orku/graduation_work/pics/research/list.jpg

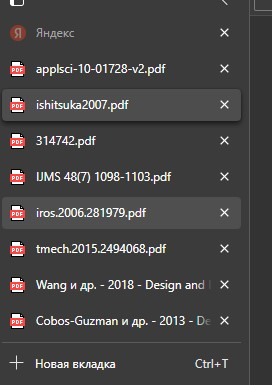
pics/research/list.jpg
