orku/graduation_work/pics/PID_tunes/Снимок экрана 2021-05-26 141231.jpg

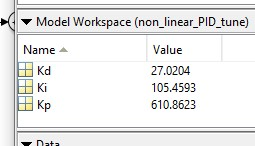
pics/PID_tunes/Снимок экрана 2021-05-26 141231.jpg
