orku/graduation_work/txt/schemes.pptx

М_в

1/(iμ)

ω_(ред)

U

−

1/(Ls+r)

i

K_M

−

−

М_(дв)

1/((J_п +J_р )s)

ω_(дв)

1/i

1/s

α

K_u

30/π

1/(iμ)

k_(гд)

## Slide 2

(K_M)/(Ls+r)

−

1/((J_п +J_р )s)

1/i

1/s

1/(iμ)

k_(гд)

k_л

1/i

(K_M)/(Ls+r)

K_u

30/π

М_(дв)

ω_(дв)

α

## Slide 3

М_в

ω_(ред)

U

−

1/(Ls+r)

i

K_M

−

М_(дв)

1/((J_п +J_р )s)

ω_(дв)

1/i

1/s

α

K_u

−

1/(iμ)

k_(гд)

k_л

## Slide 4

М_в

1/(iμ)

ω_(ред)

U

−

1/(Ls+r)

i

K_M

−

−

М_(дв)

ε/((J_п +J_р )s)

ω_(дв)

1/i

1/s

α

K_u

30/π

1/(iμ)

k_(гд)

k_л

## Slide 5

K_i

1/s

−

K_p

Объект
регулирования

K_d s

W_д

## Slide 6

(K_i)/s

−

K_p

Объект
регулирования

K_d s

W_д

## Slide 7

М_в

1/(iμ)

ω_(ред)

U

−

1/(Ls+r)

i

K_M

−

−

М_(дв)

ε/((J_п +J_р )s)

ω_(дв)

1/i

1/s

α

K_u

30/π

1/(iμ)

k_(гд)

## Slide 8

30/π

1/(iμ)

k_(гд)

k_л

(K_i)/s

K_p

U

1/(Ls+r)

i

K_M

−

М_(дв)

1/((J_п +J_р )s)

ω_(дв)

1/i

ω_(ред)

1/s

−

−

−

K_d s

K_u

α

## Slide 9

Линейная
часть

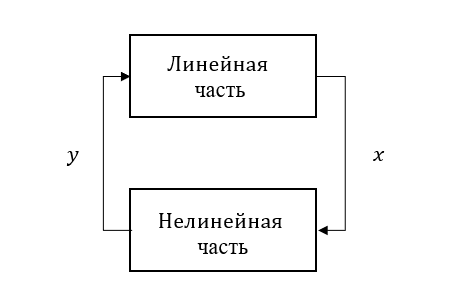
[picture p3: figure]

y

−

x

Нелинейная
часть

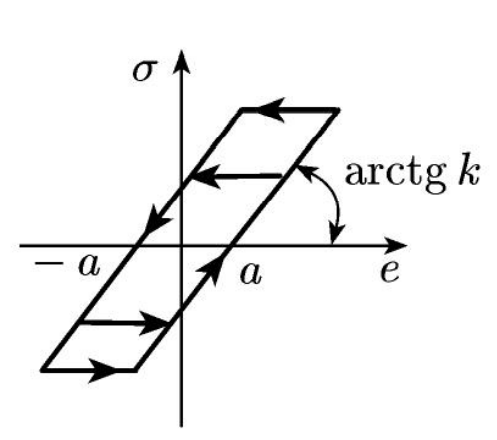
[picture p4: figure]
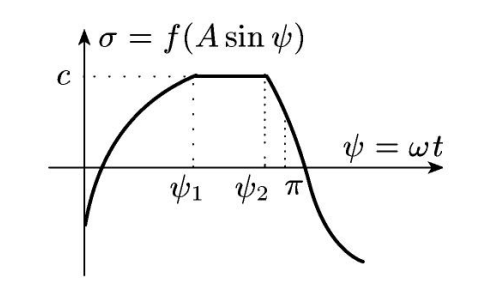
[picture p5: figure]

−

Линейная
часть

x

Нелинейная
часть

y

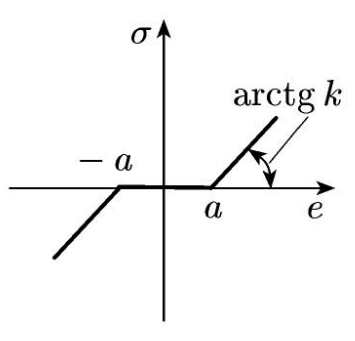
[picture p6: figure]

α

b

b

-b

b

α

## Slide 10

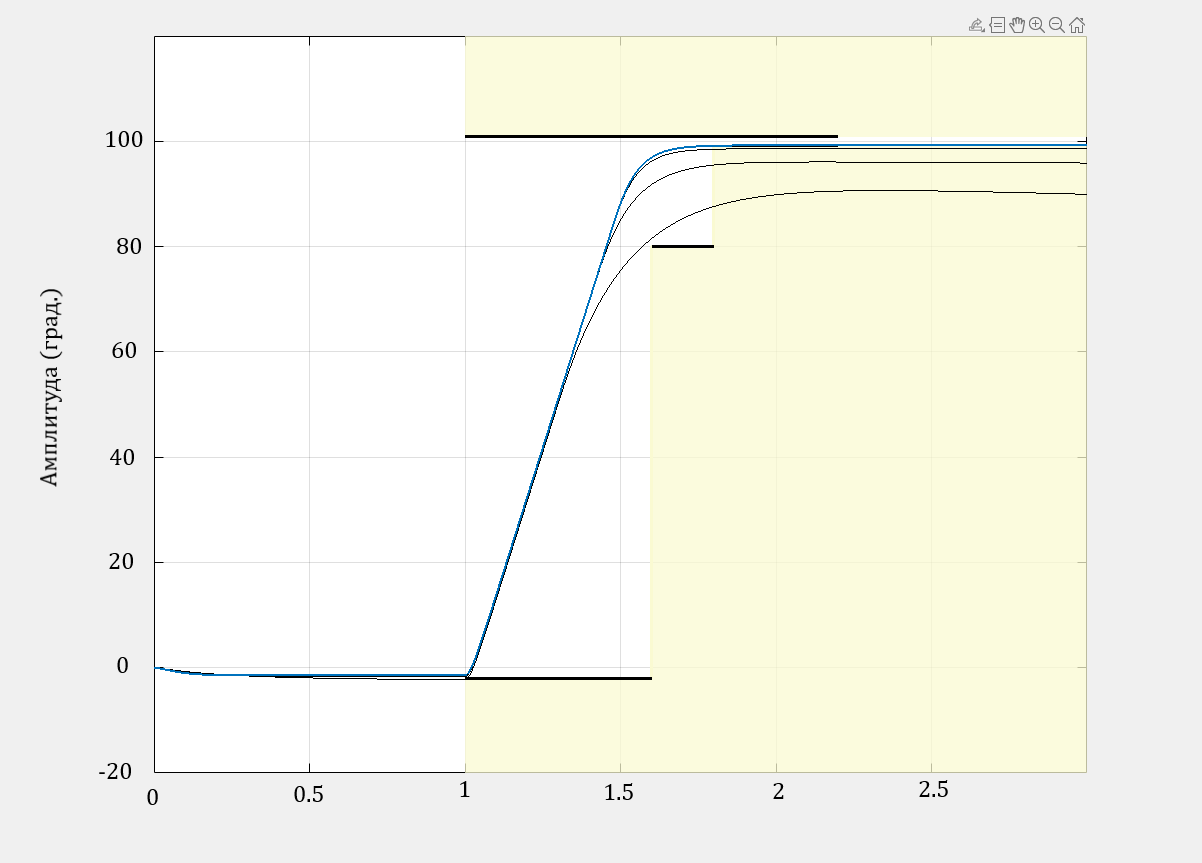
[picture p7: figure]

## Slide 11

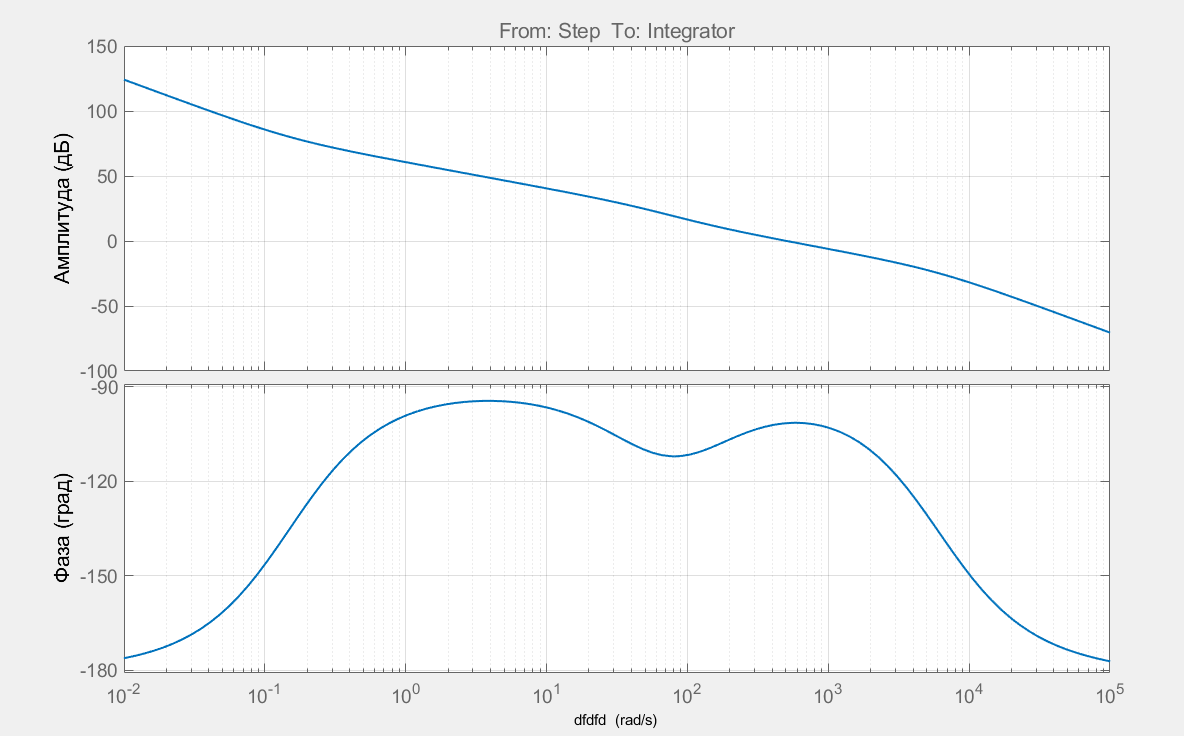
[picture p8: figure]

Частота (рад/с)

## Slide 12

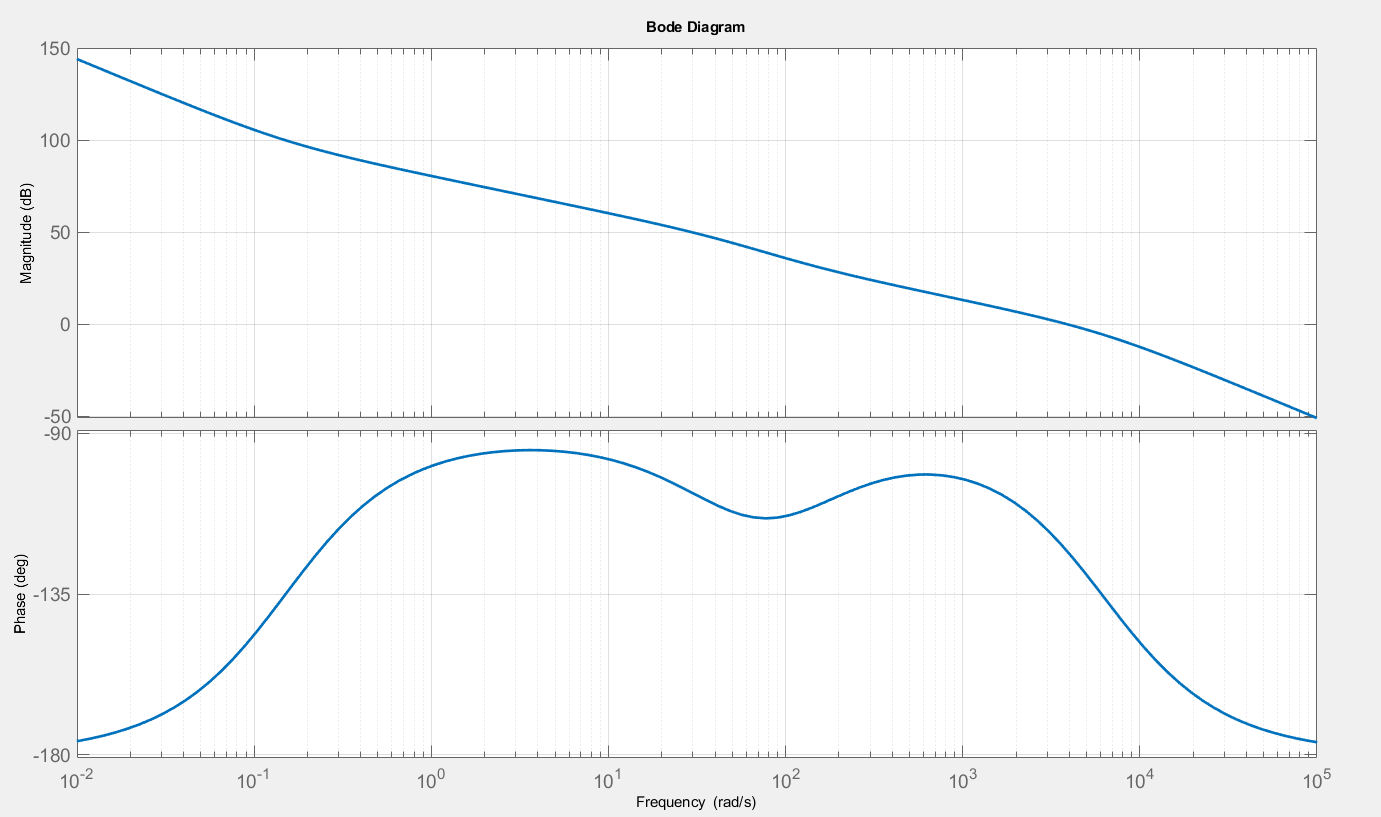
[picture p9: figure]

Амплитуда (дБ)

Фаза (град.)

Частота (рад/с)

## Slide 13

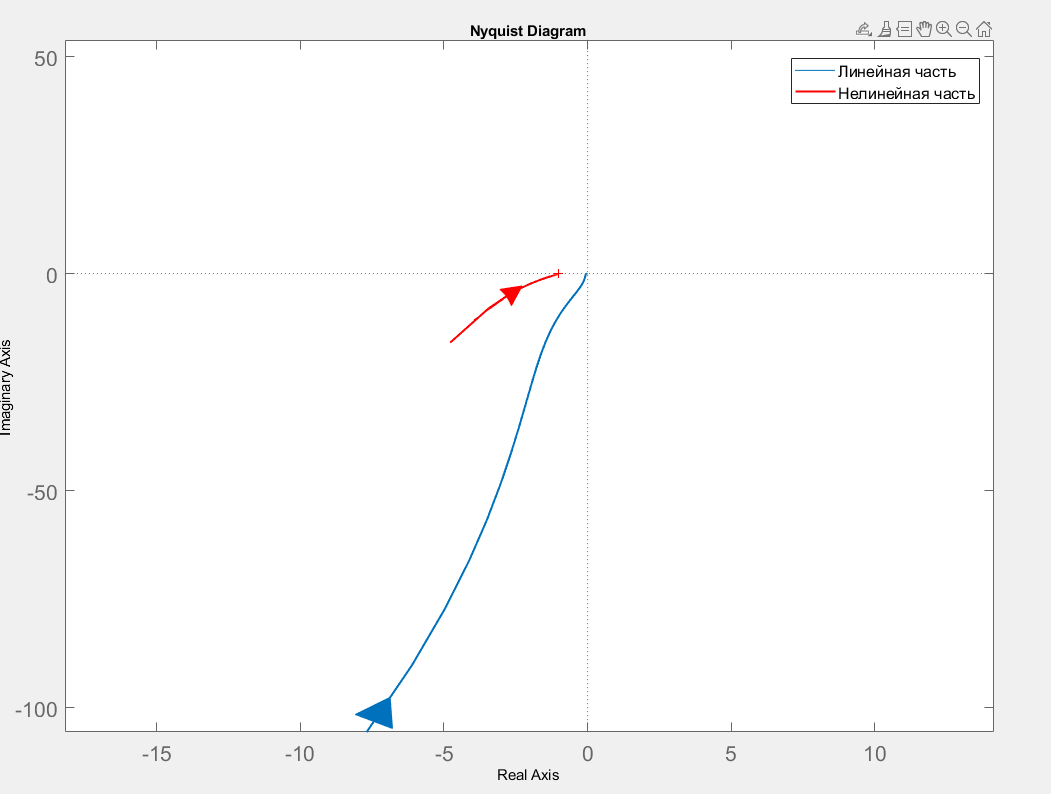
[picture p10: figure]

Мнимая часть

A = ∞

ω=∞

Действительная часть

## Slide 14

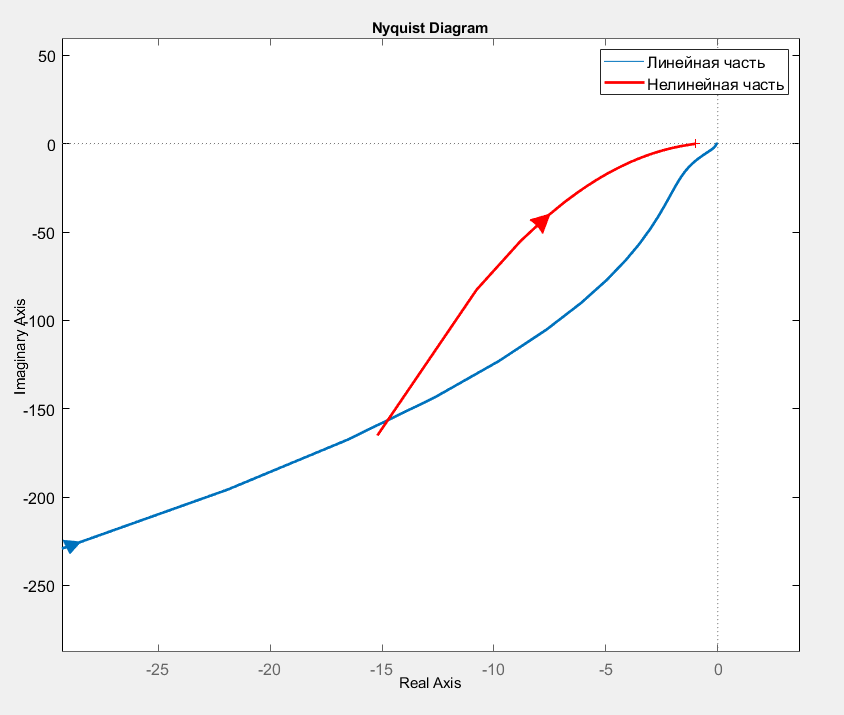
[picture p11: figure]

Мнимая часть

A = ∞

ω=∞

Действительная часть

## Slide 15

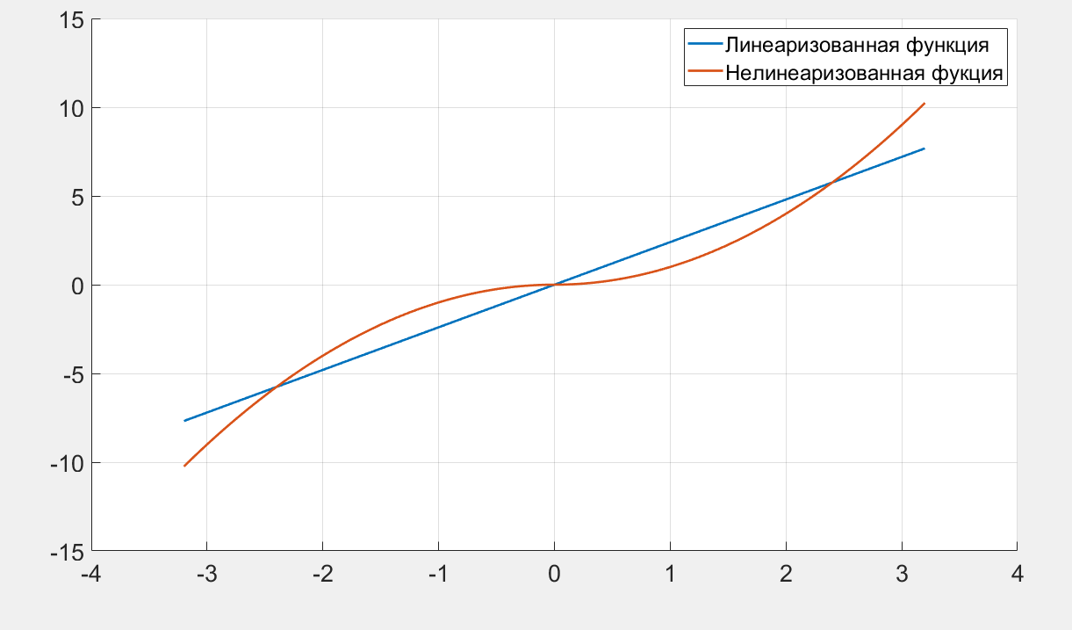
[picture p12: figure]

F(ω)

ω, рад/с

## Slide 16

20

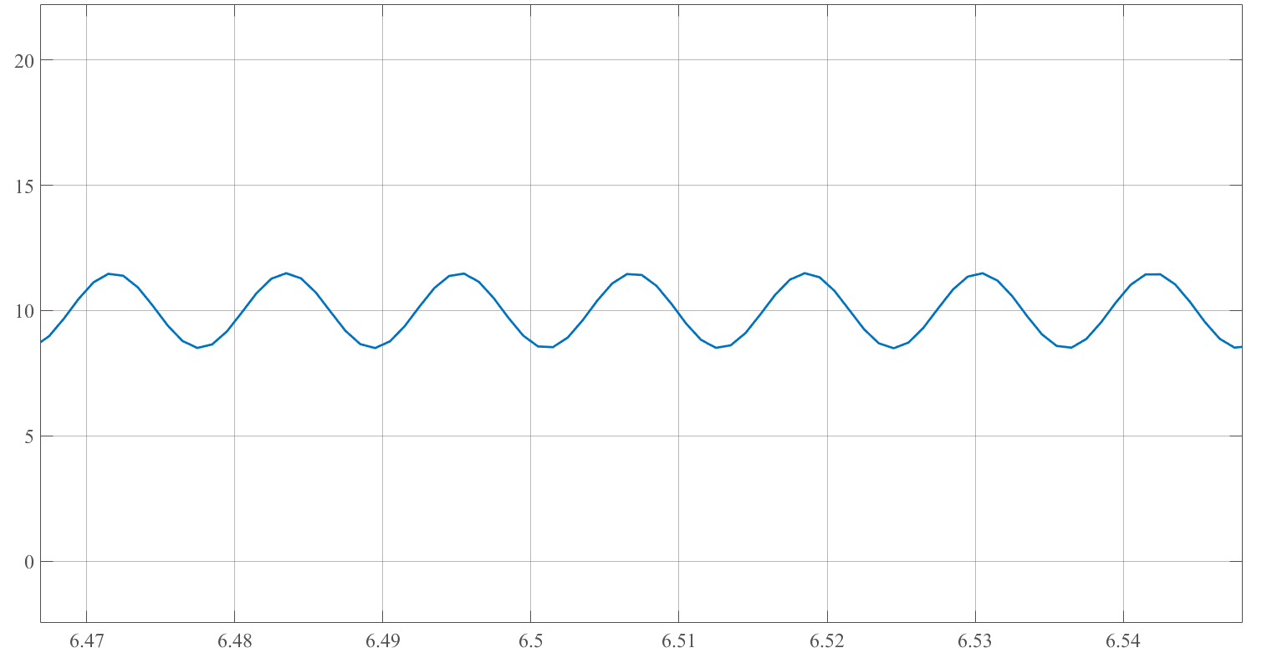
[picture p13: figure]

15

10

5

0

6.42

6.62

6.82

7.02

7.22

7.42

7.62

7.82

## Slide 17

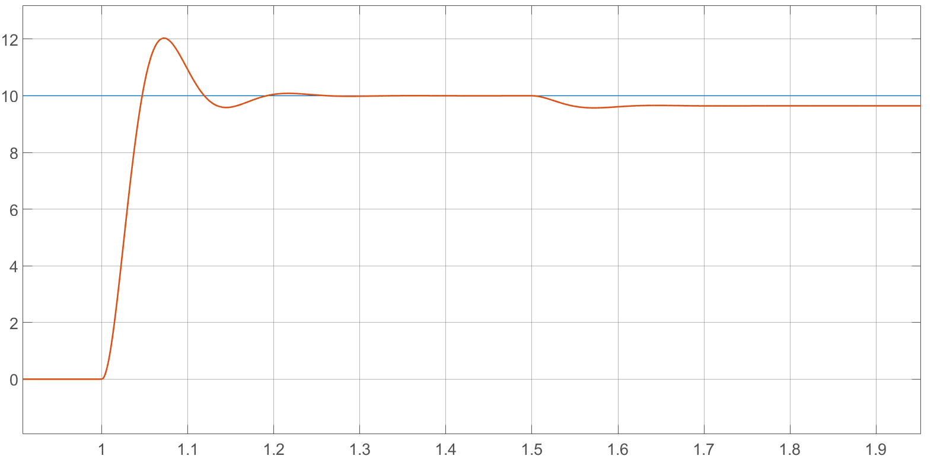
[picture p14: figure]
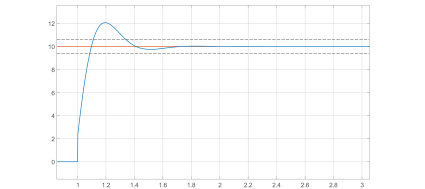
[picture p15: figure]
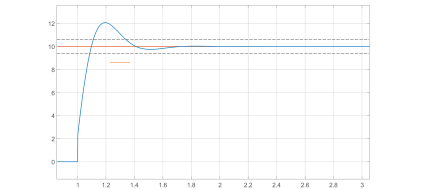
[picture p16: figure]

## Slide 18

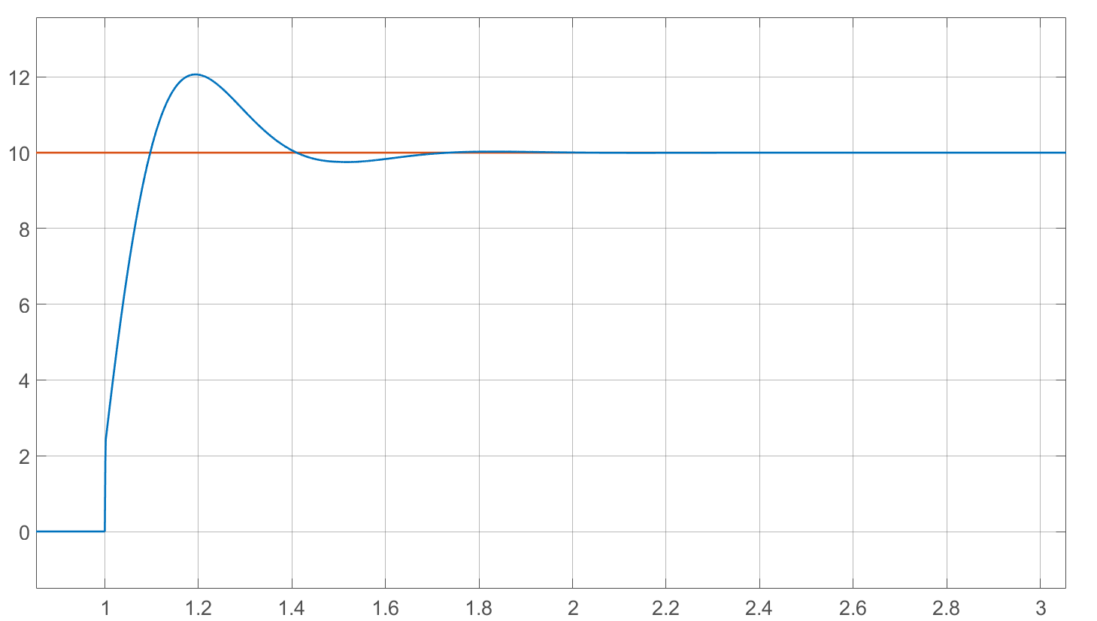
[picture p17: figure]

## Slide 19

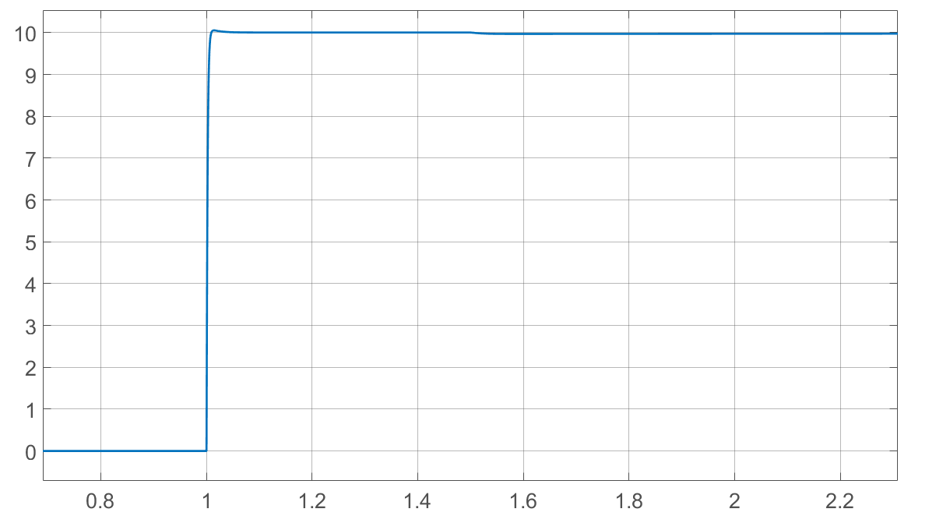
[picture p18: figure]

## Slide 20

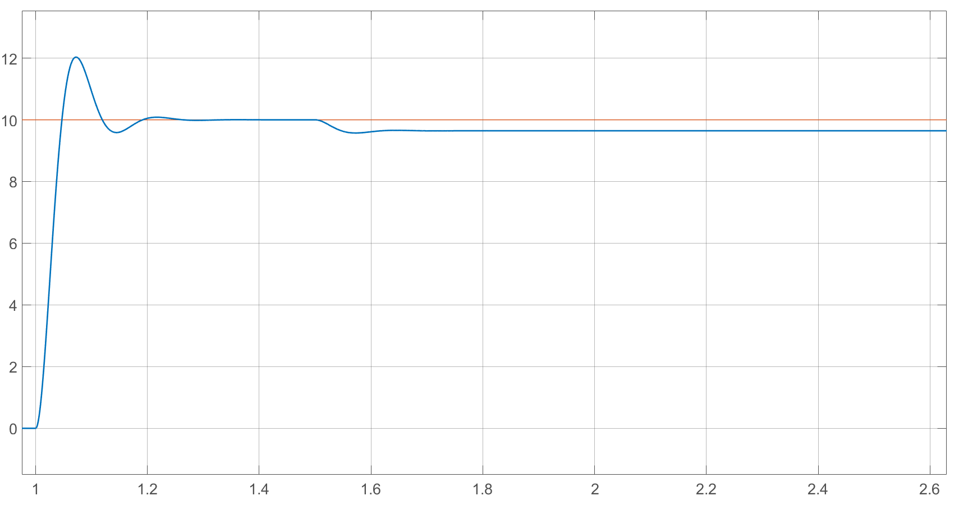
[picture p19: figure]

## Slide 21

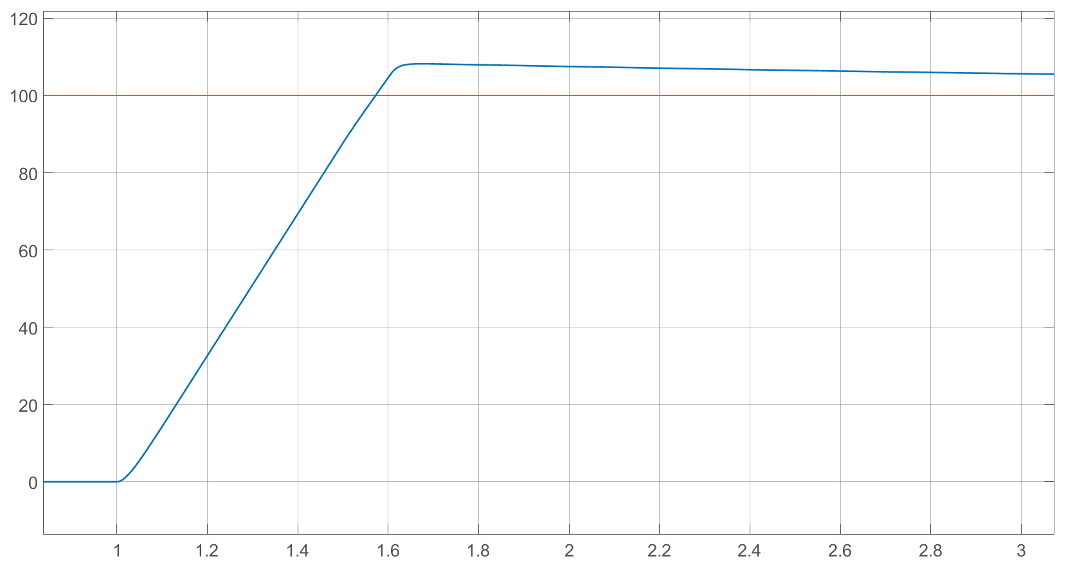
[picture p20: figure]

## Slide 22

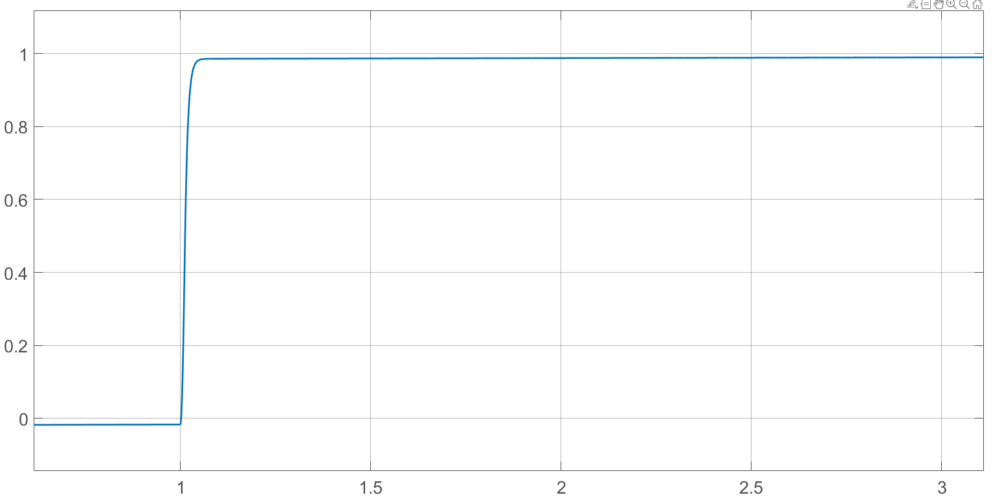
[picture p21: figure]

## Slide 23

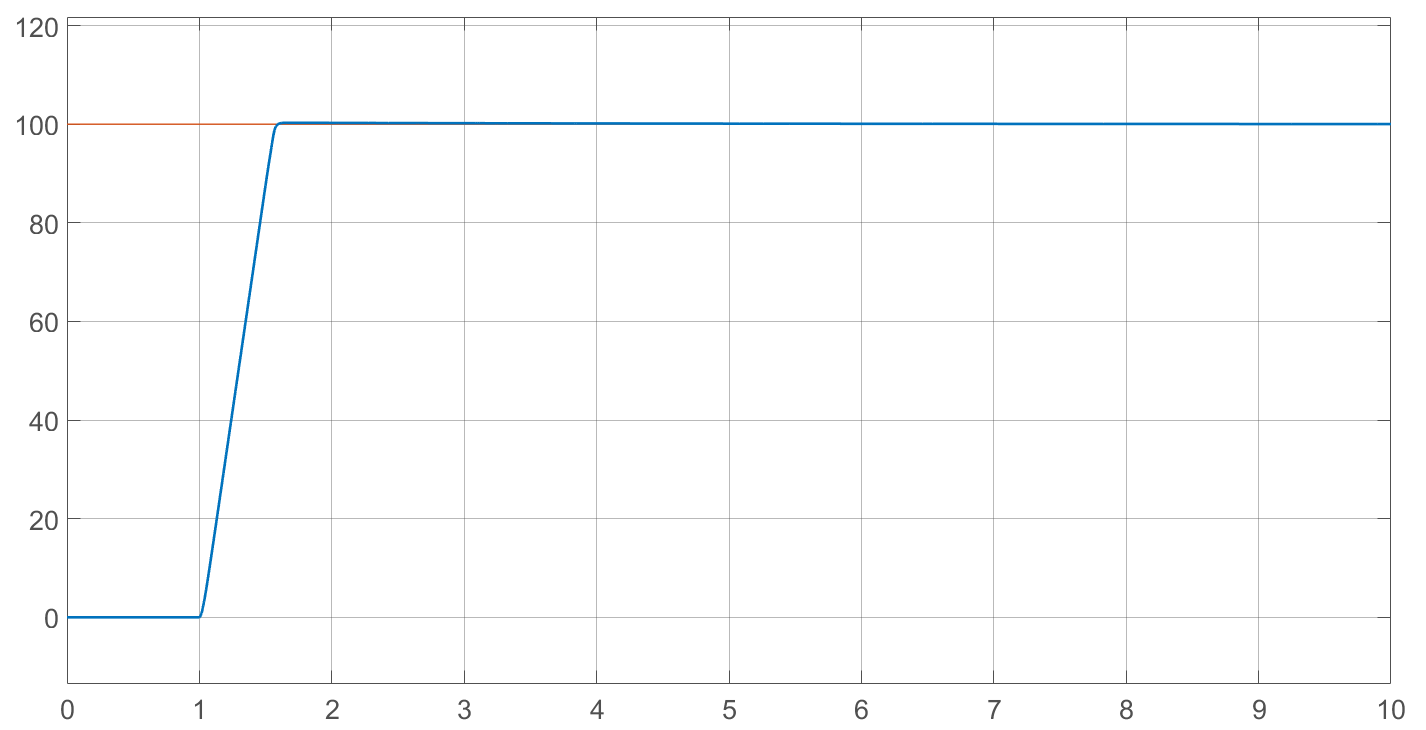
[picture p22: figure]

## Slide 24

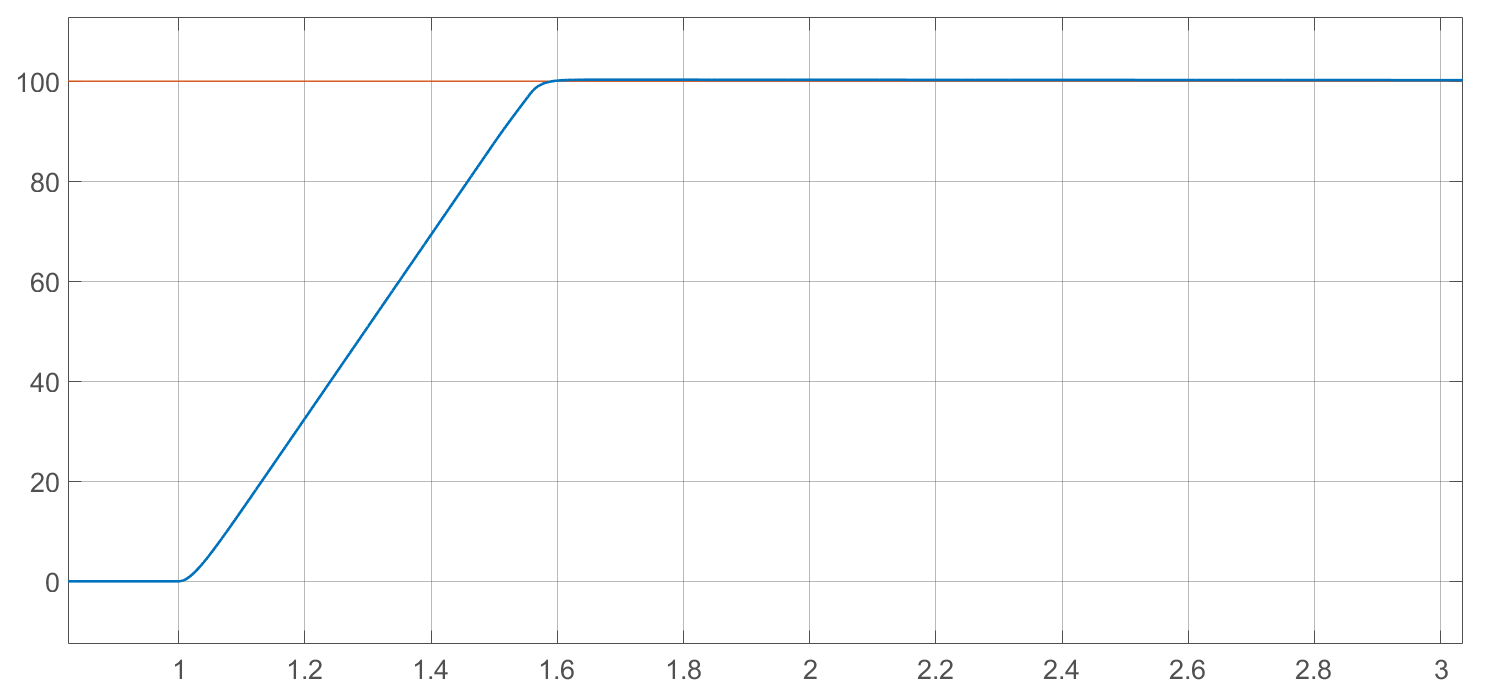
[picture p23: figure]

## Slide 25

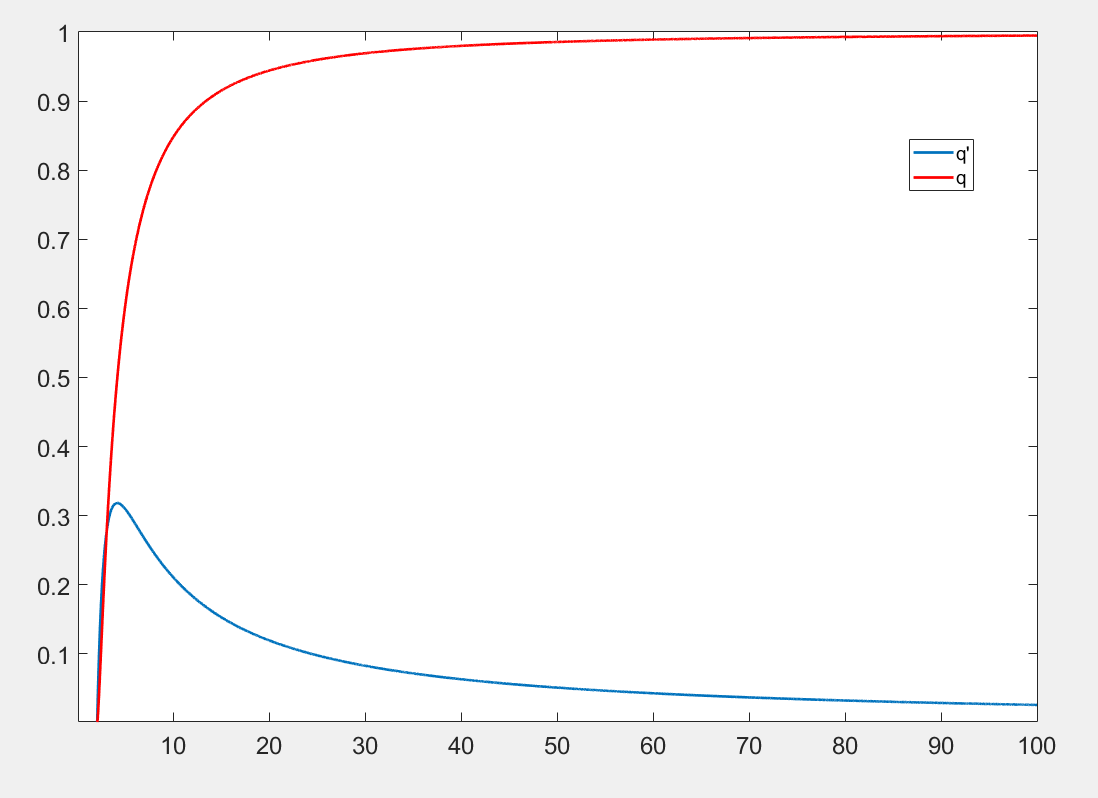
[picture p24: figure]

## Slide 26

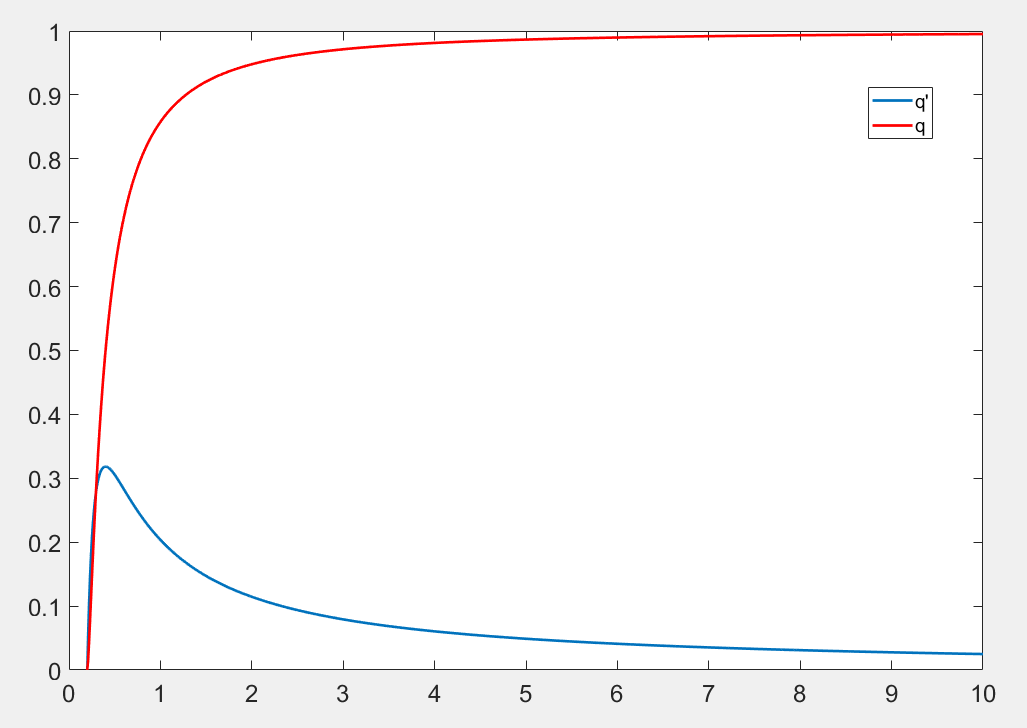
[picture p25: figure]

## Slide 27

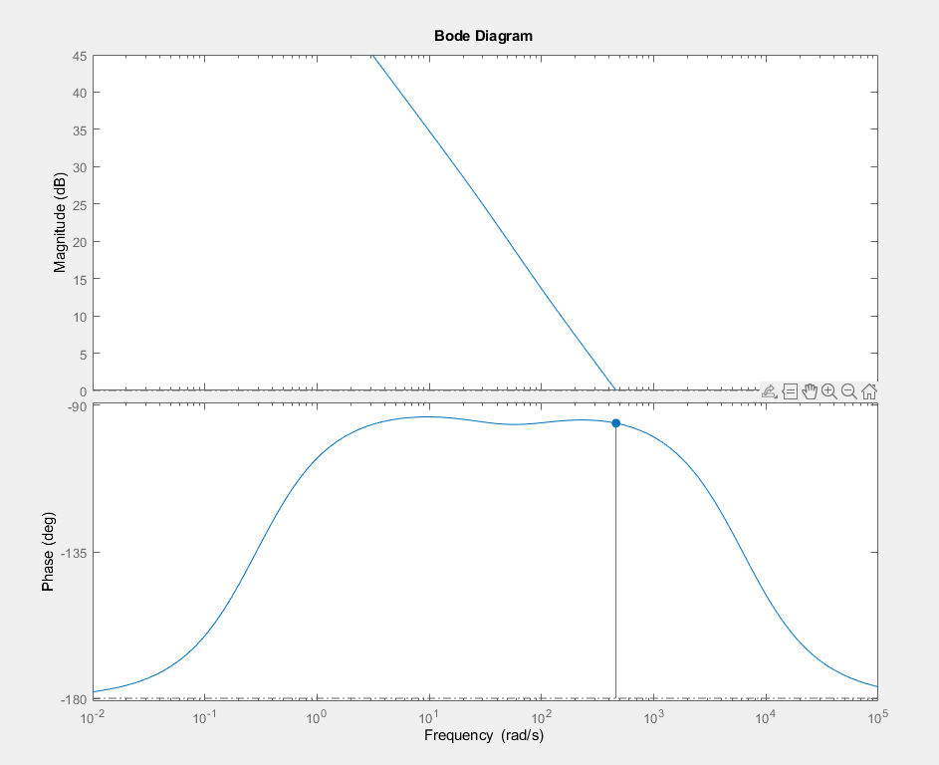
[picture p26: figure]
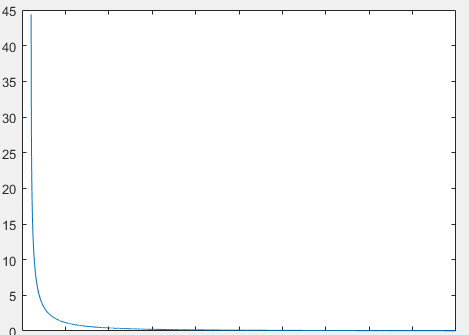
[picture p27: figure]
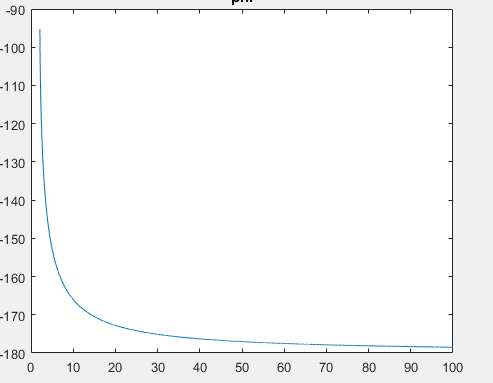
[picture p28: figure]

## Slide 28

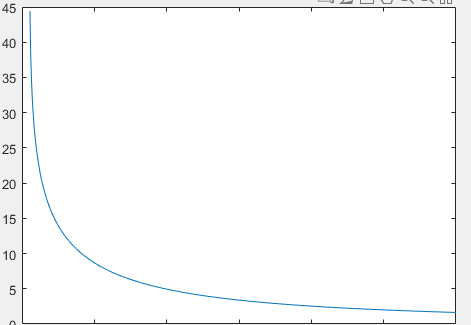
[picture p29: figure]
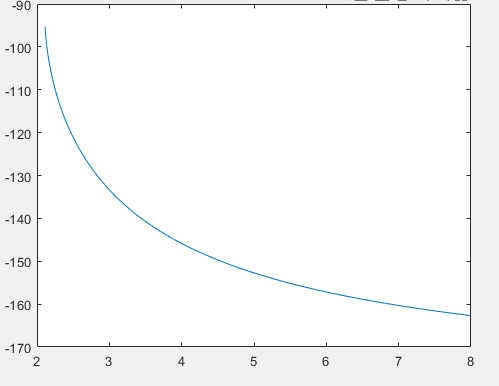
[picture p30: figure]

## Slide 29

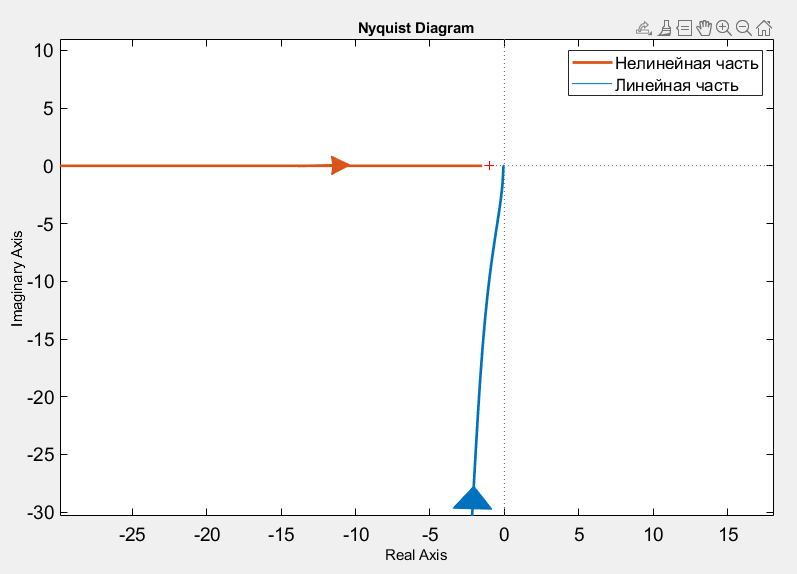
[picture p31: figure]

Мнимая часть

A = ∞

ω=∞

Действительная часть

## Slide 30

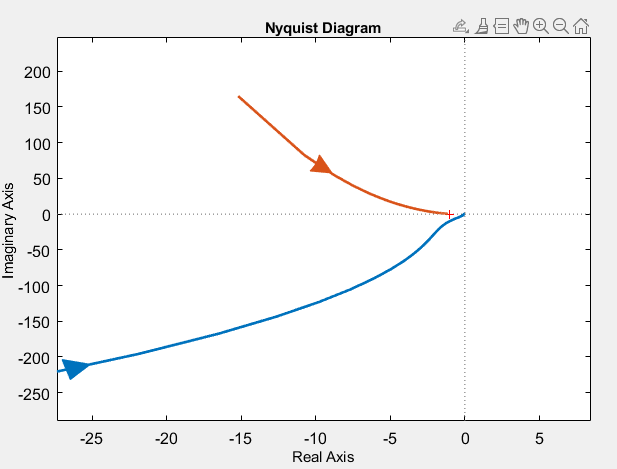
[picture p32: figure]

Действительная часть

Мнимая часть

A = ∞

ω=∞

## Slide 31

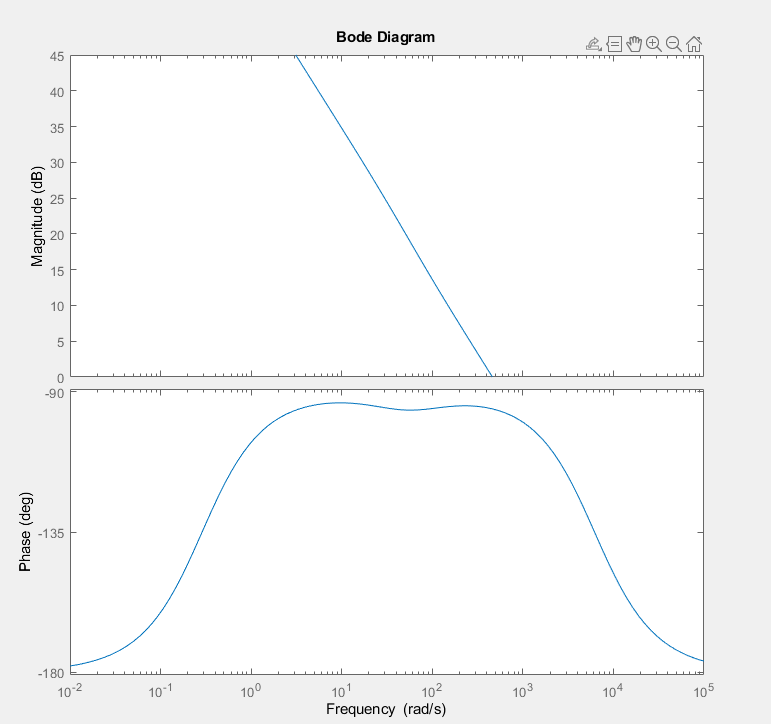
[picture p33: figure]
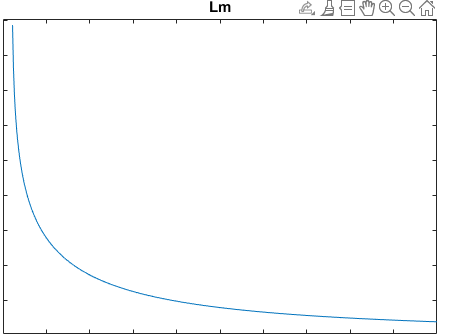
[picture p34: figure]
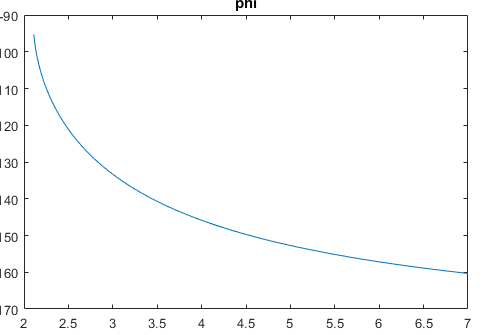
[picture p35: figure]

## Slide 32

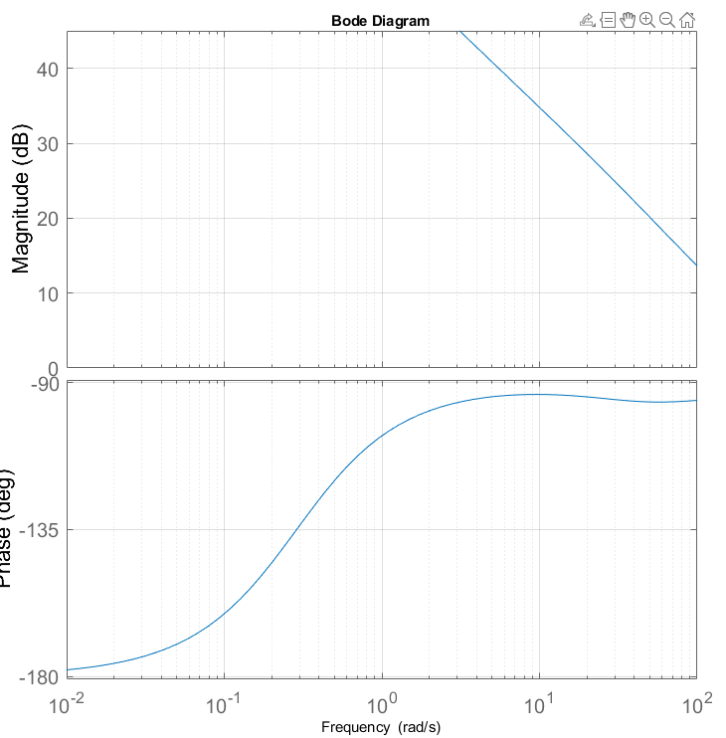
[picture p36: figure]
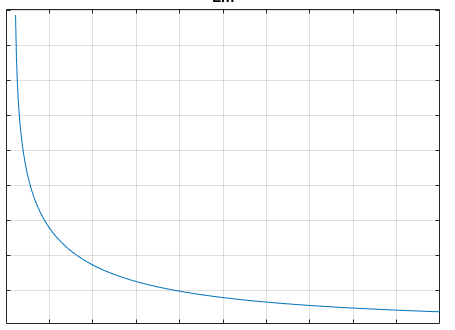
[picture p37: figure]
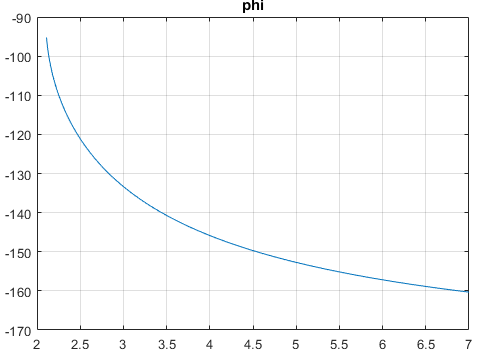
[picture p38: figure]

## Slide 33

4

3

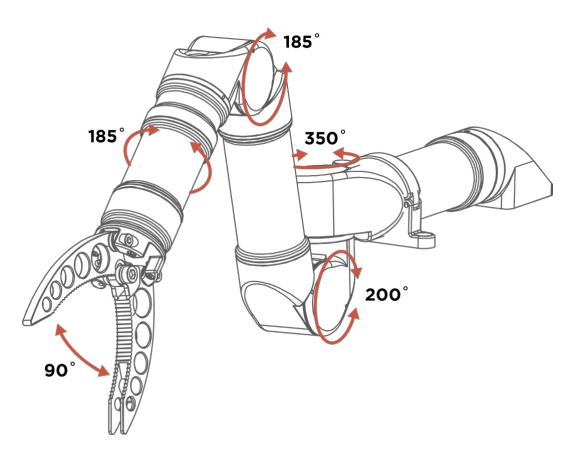
[picture p39: figure]

1

5

2

## Slide 34

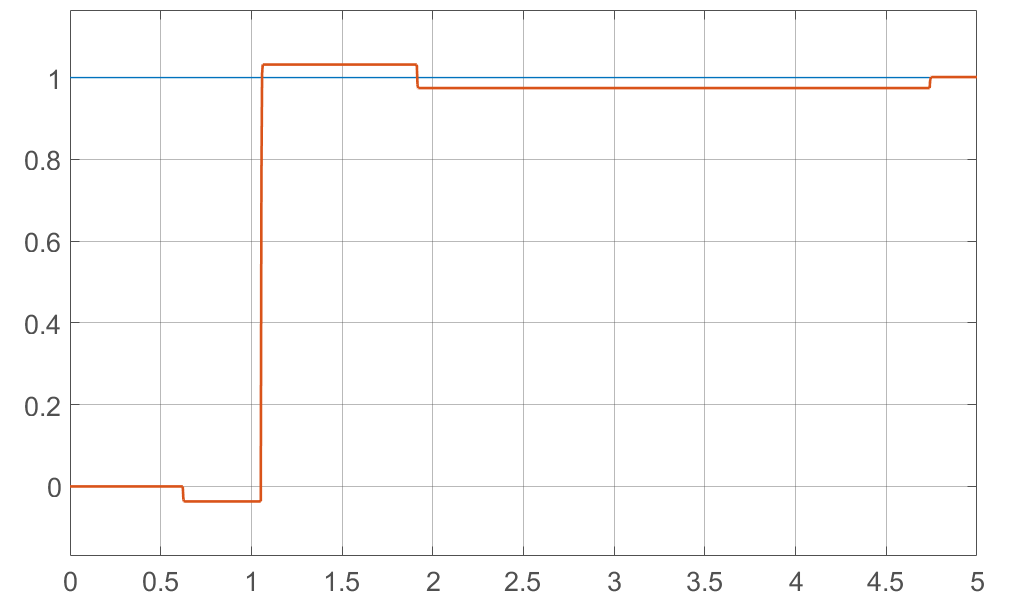
[picture p40: figure]

## Slide 35

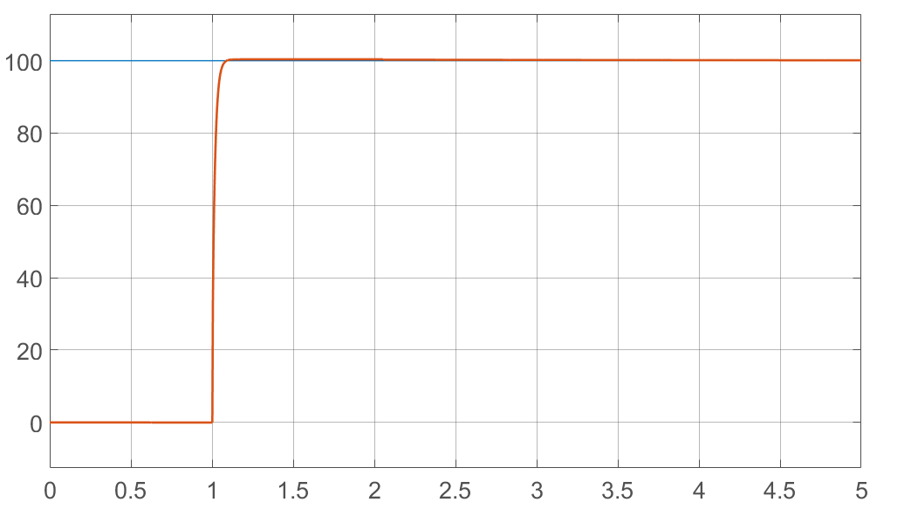
[picture p41: figure]

## Slide 36

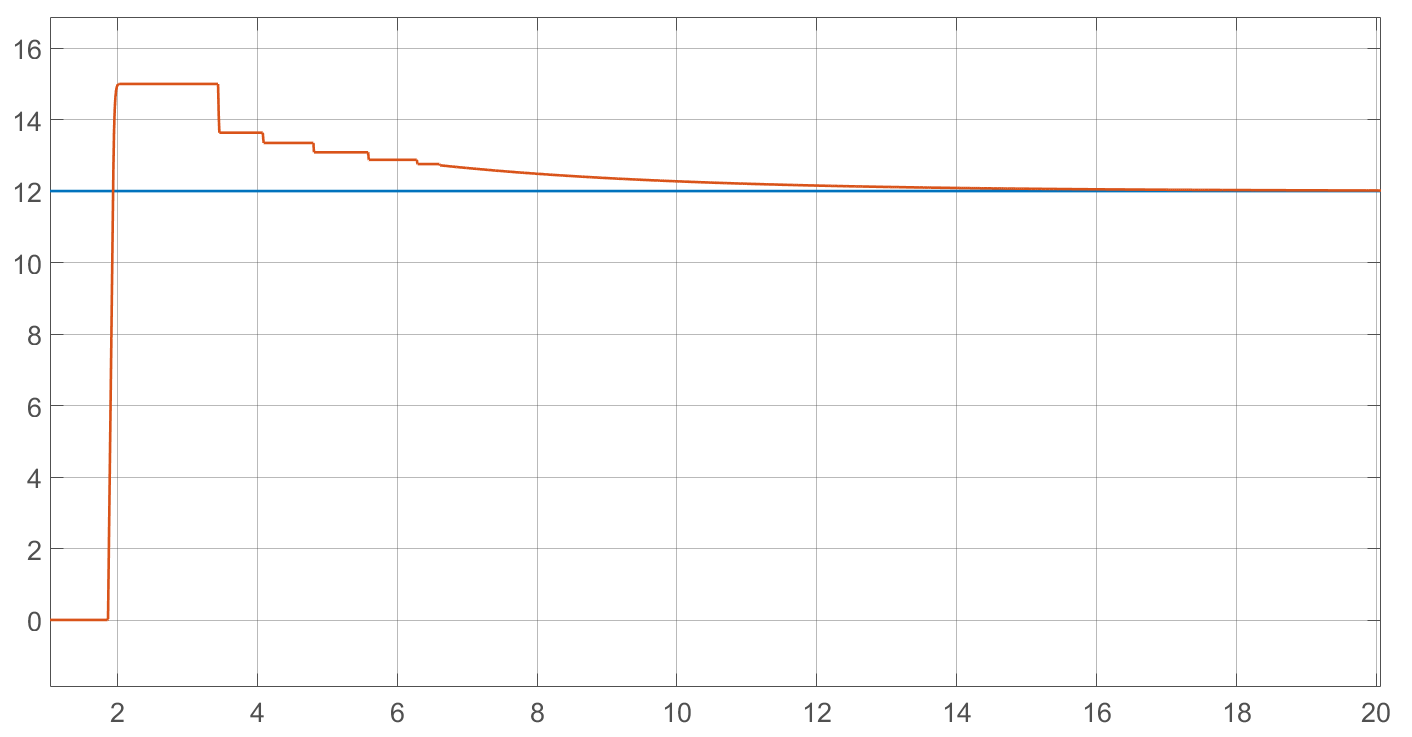
[picture p42: figure]

## Slide 37

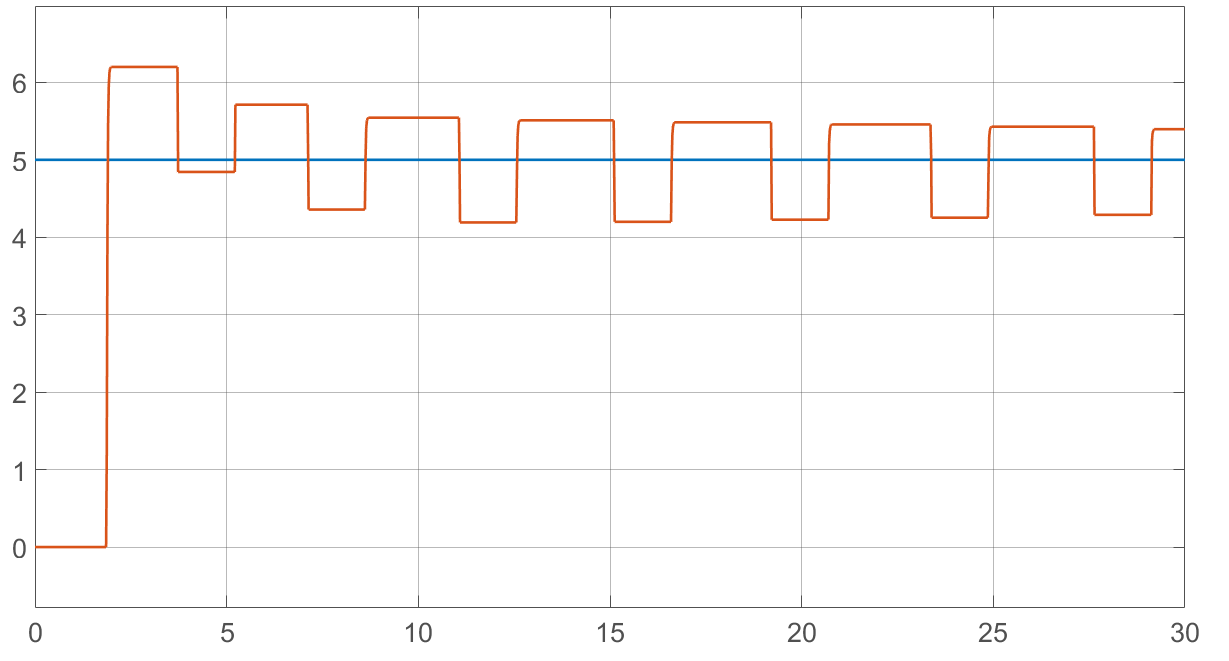
[picture p43: figure]

## Slide 38

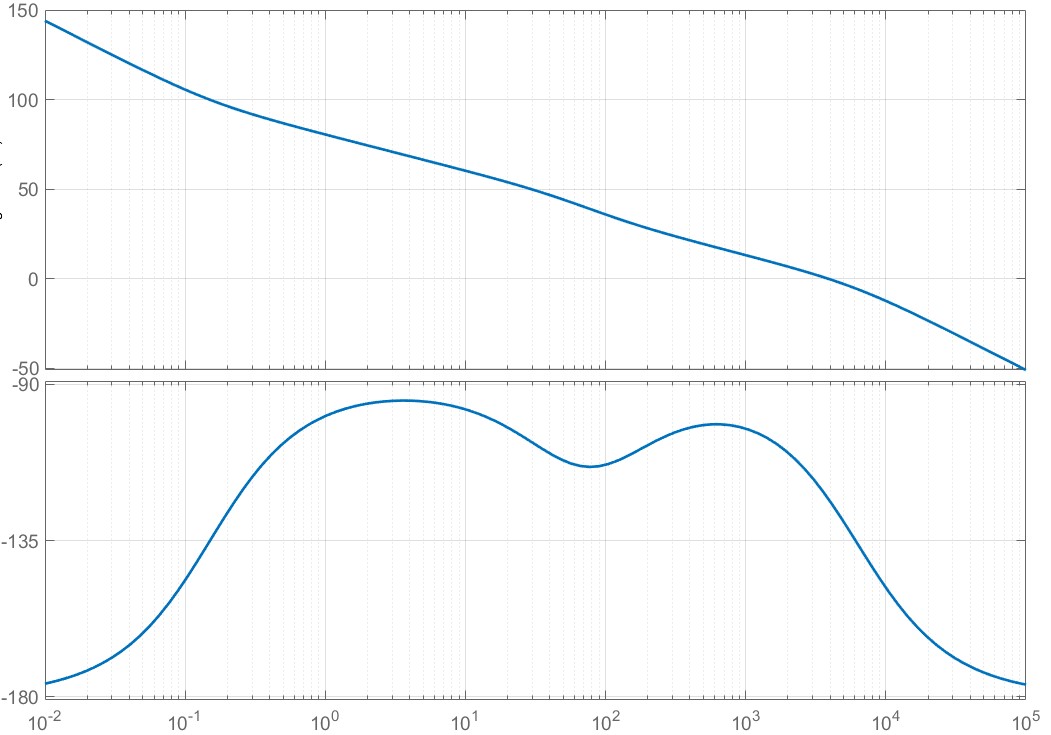
[picture p44: figure]

## Slide 39

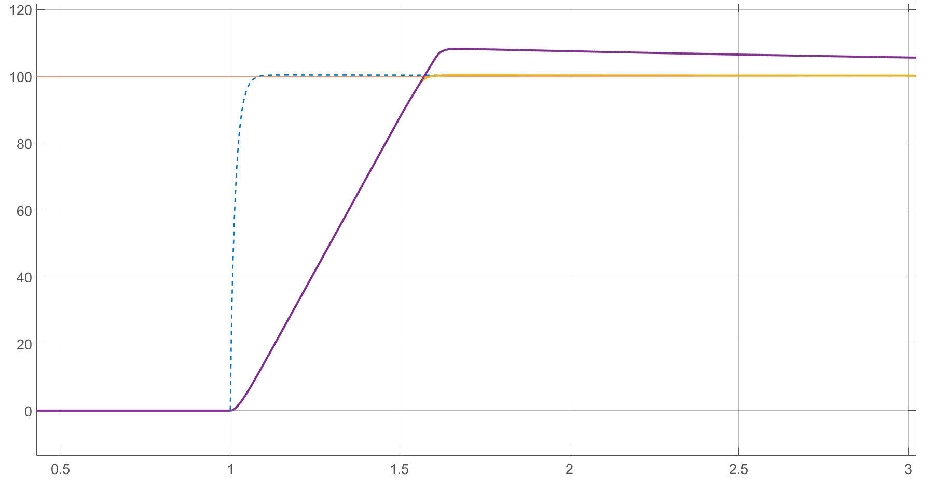
[picture p45: figure]

## Slide 40

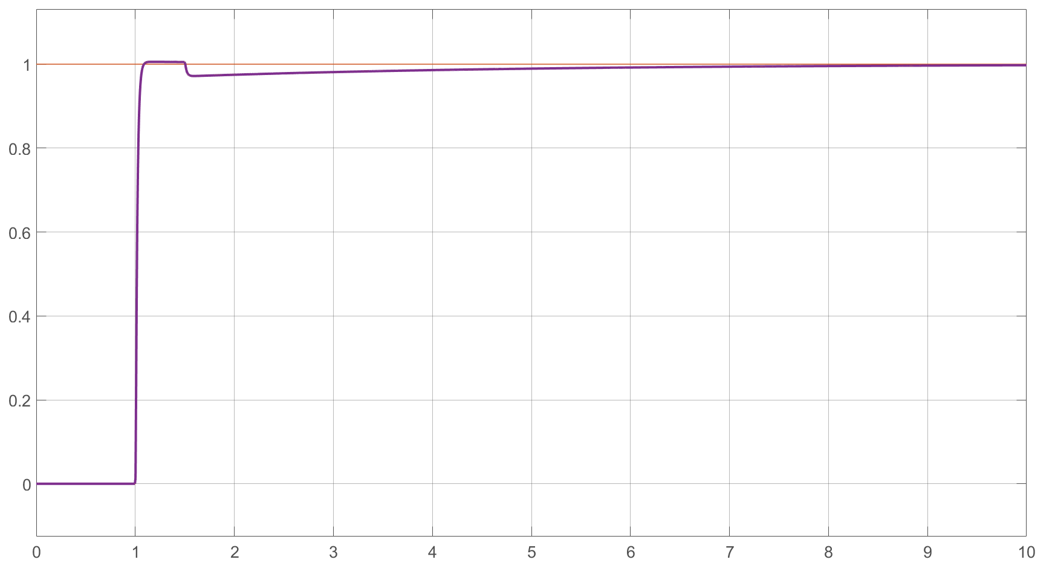
[picture p46: figure]

## Slide 41

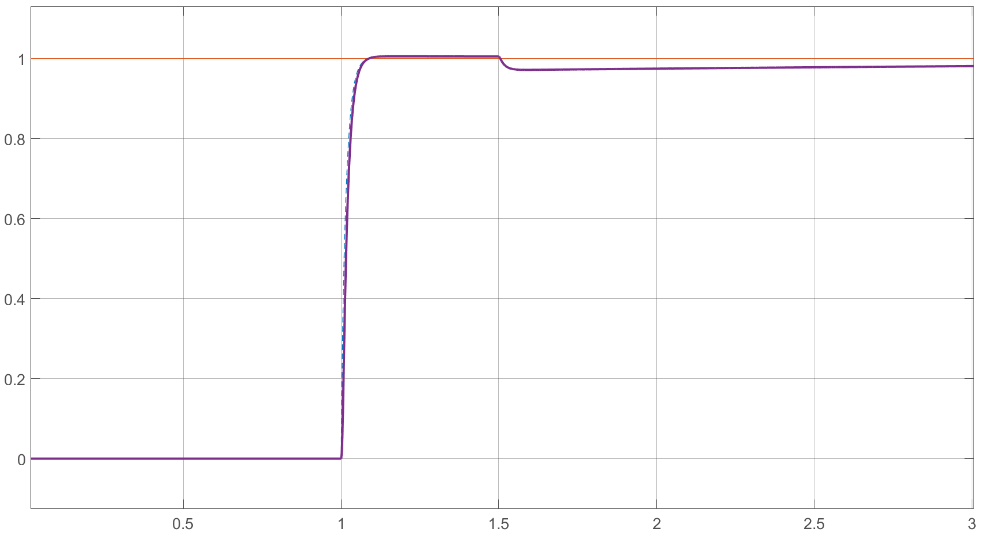
[picture p47: figure]

## Slide 42

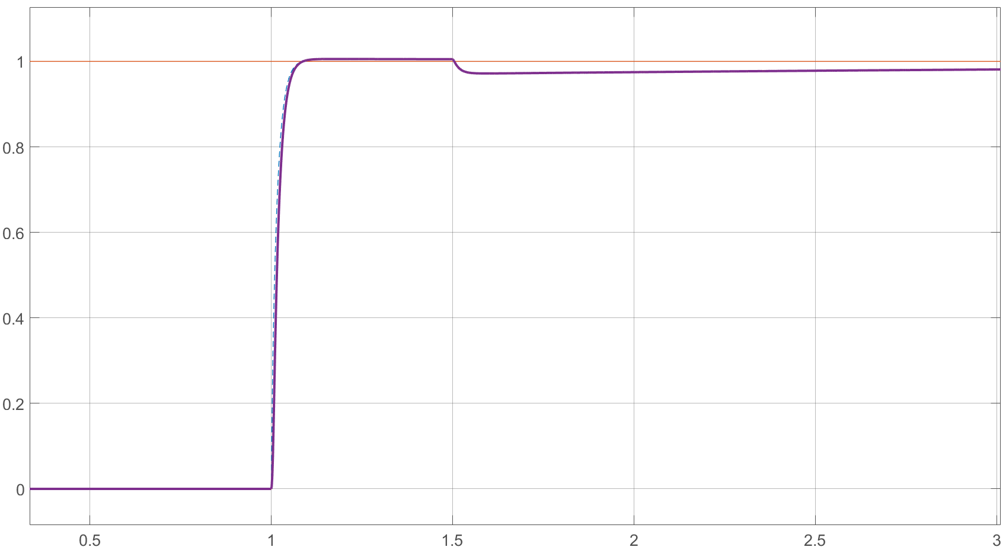
[picture p48: figure]
