orku/graduation_work/txt/main.docx

# Список сокращений

ТНПА – телеуправляемый подводный аппарат;

ДПТ – двигатель постоянного тока;

СУ – система управления;

ТЗ – техническое задание;

ЛФЧХ – логарифмическая фазовая частотная характеристика;

ЛАЧХ – логарифмическая амплитудная частотная характеристика;

САУ – система автоматического управления;

П – пропорциональный;

ПИД – пропорционально – интегрально – дифференцирующий;

АЦП - аналого – цифровой преобразователь;

# Введение

Манипуляторы являются крайне удобным инструментом для проведения работ в воде, поэтому с их помощью выполняется обширный спектр работ: взятие геологических проб, археологические работы, отчистка различных поверхностей, открытие и закрытие вентилей, прокладка и ремонт кабеля и так далее. Поскольку выполняемые манипуляторами подводных роботов задачи разнятся, то разнятся и их конструкции, от больших манипуляторов с небольшим числом степеней свободы, которые служат для перемежения тяжёлых объектов, и длинных манипуляторов с большим числом степеней свободы, которые выполняют сложные операции с более лёгкими объектами, до простых захватов с 1 степенью свободы.

Целью данной работы является проектирование первого привода подводного электромеханического манипулятора и его СУ (системы управления).

# 1 Постановка задачи

Технические характеристики манипулятора, для которого проектируется электромеханический привод представлены в ниже:

- число степеней свободы, с учётом рабочего звена – 4;
- грузоподъёмность в вытянутом состоянии 25Н;
- максимальная скорость перемещения по степени свободы – 25 об/мин;
- длина в вытянутом положении 0.4м.

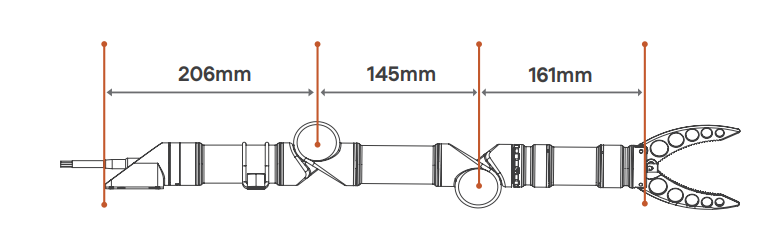
[picture p49: figure]

В качестве примера готового изделия можно привести электромеханический манипулятор Alpha 4 от компании BlueprintLab. Основываясь на его габаритах, будет строиться модель для определения значений некоторых необходимых для расчётов параметров. Он представлен на рисунке 1.

Рисунок 1 – Схема электромеханического манипулятора BlueprintLab Alpha 4

# 2 Энергетический расчёт привода подводного электромеханического манипулятора

Целями энергетического расчёта проектируемого привода являются:

- анализ действующих на привод нагрузок;
- выбор комплектующих изделий (ДПТ (двигатель постоянного тока) и редуктора);
- уточнение всех характеристик привода.

## 2.1 Анализ действующих на привод нагрузок

Рассмотрим полный момент нагрузки на выходном валу электропривода:

M_н =(J_н +J_д )(d^2 α)/(dt^2)+M_(ст) sgn((dα)/(dt))+b((dα)/(dt))+k_(гд) ((dα)/(dt))^2 sgn((dα)/(dt))+cα+M_в , (1)

где:

J_н –момент инерции нагрузки и вращающихся частей манипулятора;

J_н –момент инерции присоединенных масс;

α – угол поворота выходного звена вала;

M_(ст) – момент сухого трения, обусловленный трением в механических узлах манипулятора;

b – коэффициент вязкого трения;

k_(гд) – коэффициент гидродинамического сопротивления;

c – коэффициент позиционного момента;

M_в – внешний статический момент.

Теперь выделим основные составляющие нагрузки для энергетического расчёта. Позиционный момент является следствием действия позиционных сил на объект, примерами таких сил являются сила упругости и сила тяжести. В данном случае из позиционных сил на привод действует только сила тяжести – в общем случае её значение зависит от положения объекта, к которому она приложена. Однако в пределах рабочей области манипулятора её можно рассматривать как постоянную силу. Тогда её влияние и влияние силы Архимеда на вращающиеся части манипулятора учтём, как составляющую внешнего статического момента M_в . Провести расчёт присоединённых масс J_д и момента сухого трения в механических узлах манипулятора M_(ст) представляется трудоёмкой задачей. Но можно предположить, что динамический момент от момента инерции присвоенных масс J_д будет незначительным, потому что манипулятор имеет малые габариты, как и момент сухого трения M_(ст) , поскольку в механических узлах манипулятора будет использовать опоры качения, которые характеризуются малыми потерями на силы трения в них. Тогда введём коэффициент ε = 1.2 необходимый для учёта этих двух составляющих момента нагрузки. Момент вязкого трения возникает от действия внутренних сил, например, в маслонаполненном приводе это силы трения между подвижными деталями и маслом, в котором они находятся. В нашем случае разрабатываемый манипулятор сам перемещается в воде, поэтому очевидно, что величина момента вязкого трения будет пренебрежимо мала по сравнению с вентиляторным моментом от гидродинамических сил, действующих на вращающиеся части манипулятора, поэтому рассматривать её в энергетическом расчёте не будем.

Таким образом оставим динамический момент нагрузки, вентиляторный момент, внешний статический момент и коэффициент запаса ε = 1.2. Эти моменты составят основную часть момента нагрузки. После учёта вышеописанных соображений уравнение 1 примет вид:

M_н =ε(J_н (d^2 α)/(dt^2)+k_(гд) ((dα)/(dt))^2 sgn((dα)/(dt))+M_в ) , (2)

Результатом данного энергетического расчёта является нагрузочная характеристика привода, исходя из которой будут выбираться ДПТ и механическая передача. Для её построения необходимо определить численные значения параметров M_в , J_н , k_(гд) .

### 2.1.1 Определение внешнего статического момента

В общем случае внешний момент M_в зависит от угла поворота выходного вала привода α , однако для упрощения расчётов будем рассматривать его как статический момент, со значением равным его максимальному значению (тогда, когда манипулятор находится в вытянутом состояние). Тогда внешний статический момент определяется по следующей формуле:

M_в =M_(наг) +M_(пр) =P_(наг) l+(F_т -F_(арх) )r , (3)

где:

P_(наг) – максимальная вес нагрузки в воде, P_(наг) = 25 Н;

l – расстояние от выходного вала рассчитываемого привода до нагрузки при вытянутом состоянии манипулятора, l = 0.3 м;

F_т – сила тяжести, действующая на вращающуюся часть манипулятора, примем F_т = 15 Н;

F_(арх) – сила Архимеда, действующая на вращающуюся часть манипулятора, примем F_(арх) = 5Н;

r – расстояние от выходного вала рассчитываемого привода до центра масс вращающейся части манипулятора, примем r = 0.15 м.

Подставив все вышеперечисленные значения в формулу (3), получим значение внешнего момента M_в = 9 Н·м.

### 2.1.2 Определение коэффициента гидродинамического сопротивления вращающихся частей манипулятора

Для определения момента гидродинамического сопротивления необходимо определить коэффициент гидродинамического сопротивления k_(гд) . Определять численное значение данного коэффициента будем с помощью пакета SolidWorks Flow Simulation. Для начала проведем верификацию настройки параметров пакета SolidWorks Flow Simulation для дальнейших расчётов.

Проведем в нём расчёт момента гидродинамического сопротивления для бруска квадратного сечения 40x40мм и длиной 300 мм. Будем вращать рисунок относительно оси, проходящей через его торец, с угловой скоростью ω = 2 рад/с, как это показано на рисунке 2.

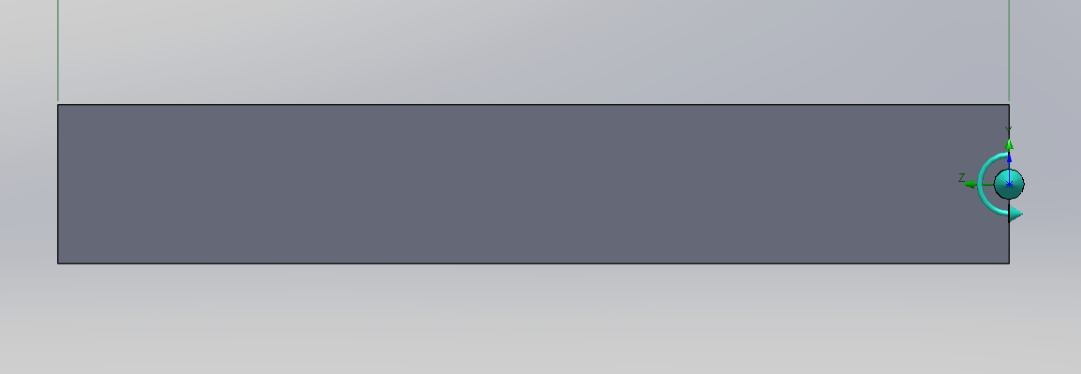
[picture p50: figure]

Рисунок 2 – Брусок в пакете SolidWorks Flow Simulation

Получим следующее значение момента M_(гд)^1 = 0.255 Н·м.

Теперь проведём аналогичный расчёт аналитическим способом. При вращении заданным образом на каждую элементарную часть детали длинной dr и шириной В набегает поток со скорость ωdr . Таким образом, на этом участке детали возникает сила гидродинамического сопротивления

dF=c_x ρ/2Bdr(ωdr)^2 , (4)

где:

c_x – коэффициент гидродинамического сопротивления, c_x = 1,6 [1];

B – ширина сечения бруска, B = 0.04 м;

ρ – плотность жидкости, в которой происходит вращение, ρ = 1000 кг/ м^3 .

Такая сила создаёт элементарный момент

dM=c_x ρ/2Bω^2 r^3 dr , (5)

Полный гидродинамический момент сопротивления при вращении получим, проинтегрировав элементарный момент по всей длине бруска R.

M_(гд) =∫_0^R c_x ρ/2Bω^2 r^3 dr=1/8c_x ρBR^4 ω^2 , (6)

Подставив все необходимые численные значения в формулу (6) и получим значение момента M_(гд)^2 =0.259 Н·м.

Видно, что значения M_(гд)^2 =0.259 Н·м и M_(гд)^1 = 0.255 Н·м, полученные разными способами примерно равны. Это значит, что настройки параметров пакета SolidWorks Flow Simulation проведена верно, поэтому перейдём теперь к определению коэффициента k_(гд) более сложной модели.

Построим более сложную модель вращающихся частей манипулятора и рассчитаем её на разных скоростях вращения. На рисунках 3 и 4 представлена данная модель с разных ракурсов.

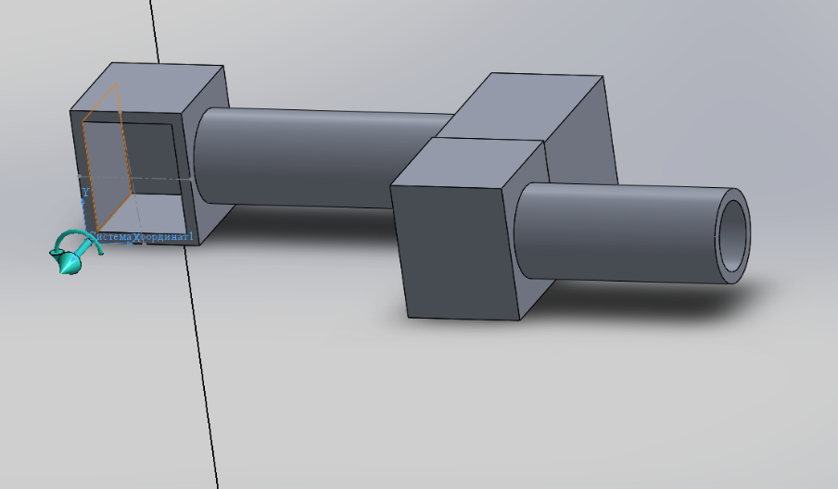
[picture p51: figure]

Рисунок 3 – Приближённая модель вращающихся частей манипулятора

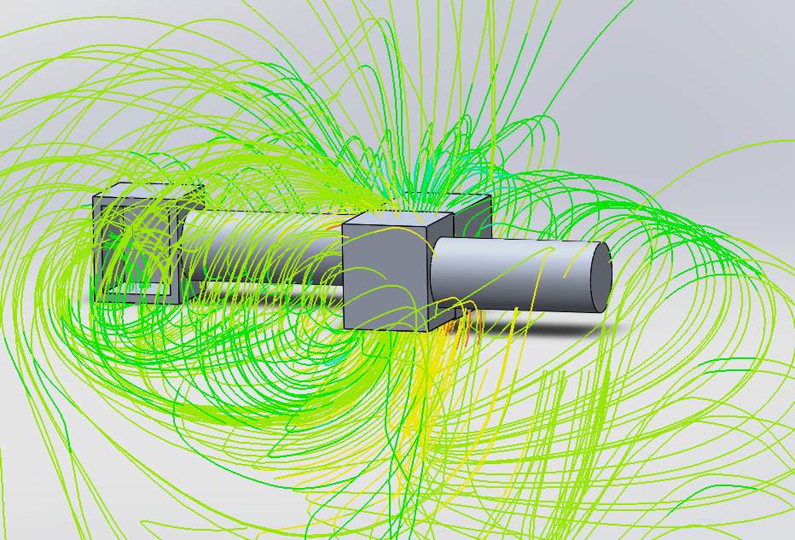
[picture p52: figure]

Рисунок 4 – Траектории обтекания вращающихся частей манипулятора частицами воды при расчёте

Результаты данных расчетов представлены в виде графика на рисунке 5. На рисунке 5 мы можем видеть, квадратичную зависимость гидродинамического момента сопротивления от скорости вращения гидропривода. Это согласуется с формулой гидродинамического момента сопротивления

M_(гд) = k_(гд) ω^2 sgn(ω) , (7)

учто ещё раз показывать достоверность расчётов, проведённых в пакете SolidWorks Flow Simulation.

Теперь рассчитаем k_(гд) . Возьмём среднее арифметическое значение по результатам 7 расчётов. Рассчитывать значения будем по формуле

k_(гд) =(M_(гд))/(ω^2) , (8)

Для каждолго рачёта соответсвующие значения M_(гд) и ω прдеставлены в табдице 1. Также в таблице 1 представлены значения коэффициента гидродинамического сопротивления k_(гд) , вычисленные для каждого испытания.

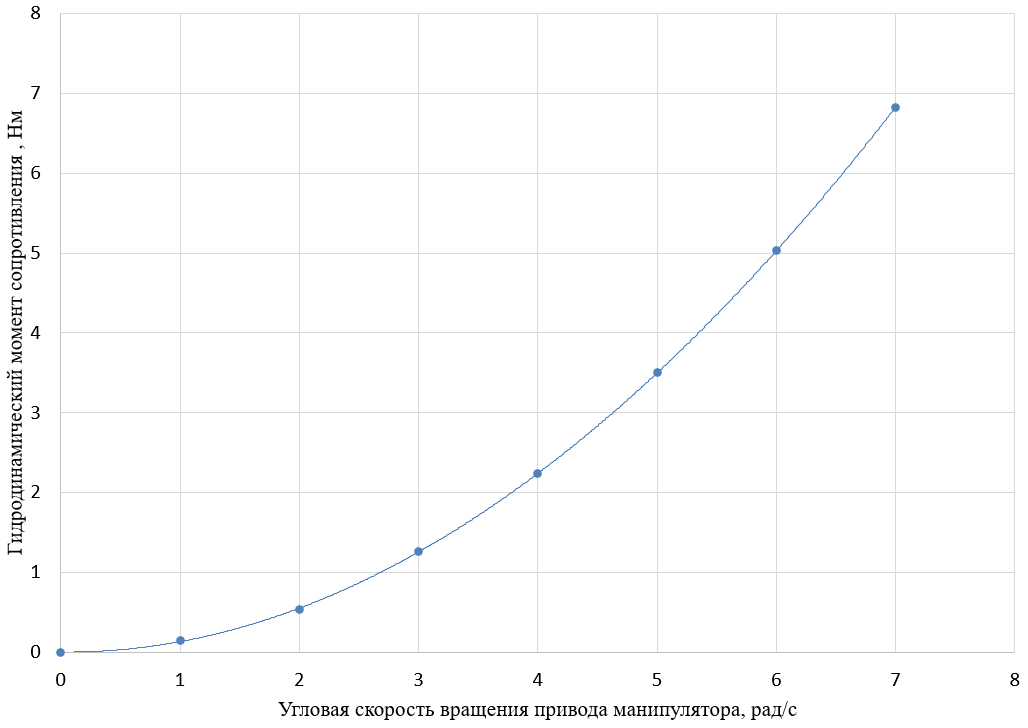
[picture p53: figure]

Рисунок 5 – График зависимости гидродинамического момента

сопротивления от угловой скорости вращения привода манипулятора

Таблица 1 – Значения коэффициентов k_(гд) по результатам расчётов

M_(гд) , Нм | ω, рад/с | k_(гд) | k_(гд)^(ср)
0,14 | 1 | 0.142 | 0.139
0,54 | 2 | 0.135
1,26 | 3 | 0.140
2,24 | 4 | 0.140
3,52 | 5 | 0.140
5,03 | 6 | 0.139
6,83 | 7 | 0.138

В дальнейших расчётах примем k_(гд) = 0.139 Н · м /(рад/с)^2

### 2.1.3 Определение момента инерции нагрузки и вращающихся частей манипулятора

Будем рассчитывать момент инерции нагрузки и вращающихся частей привода по формуле

J=J_н +J_м , (9)

где:

J_н – момент инерции нагрузки;

J_м – момент инерции вращающихся частей манипулятора.

Поскольку нам не известны габариты нагрузки то представим её как материальную точку с массой mн = 3 кг. Тогда её момент инерции будет равен

J_н =ml^2 =3⋅0.3^2 =0.27 кг⋅м^2 .

Момент инерции вращающихся частей манипулятора рассчитаем с помощью SolidWorks по модели, которая использовалась для расчёта k_(гд) . Примем материал всех частей модели алюминий 6061 – Т6. Получим J_м = 0.18 кг⋅м^2 .

Тогда итоговый момент инерции будет равен

J=J_н +J_м = 0.27 + 0.18 = 0.45 кг⋅м^2 .

### 2.2 Построение нагрузочной характеристики привода

Теперь, когда известны все численные значения необходимых нам параметров, можно переходить к построению нагрузочной характеристики. Предположим, что выходной угол α меняется по синусоидальному закону

α(t)=α_a sinω_э t , (10)

где:

α_a – амплитуда выходного угла, α_a = 200о или α_a = 3.5 рад;

ω_э – частота эквивалентного гармонического сигнала.

Тогда закон изменения скорости будет определяться по следующему выражению

α(t)=α_a ω_э cosω_э t = α_a cosω_э t , (11)

а ускорение соответственно

α(t)=-α_a ω_э sinω_э t . (12)

Поскольку значения α_a и α_a заданы, то можно определить значение ω_э

ω_э =(α_a)/(α_a)=2.5/3.5=0.74 рад/с. (13)

Подставив в (2) выражения (10), (11) и (12) получим выражение для построения нагрузочной характеристики привода

M_н =ε(-J_н α_a ω_э sinω_э t+k_(гд) (α_a cosω_э t)^2 sgn(α_a cosω_э t)+M_в ) , (14)

Построим нагрузочную характеристику привода по выражению (14) в среде разработки Matlab. Результат представлен на рисунке 6.

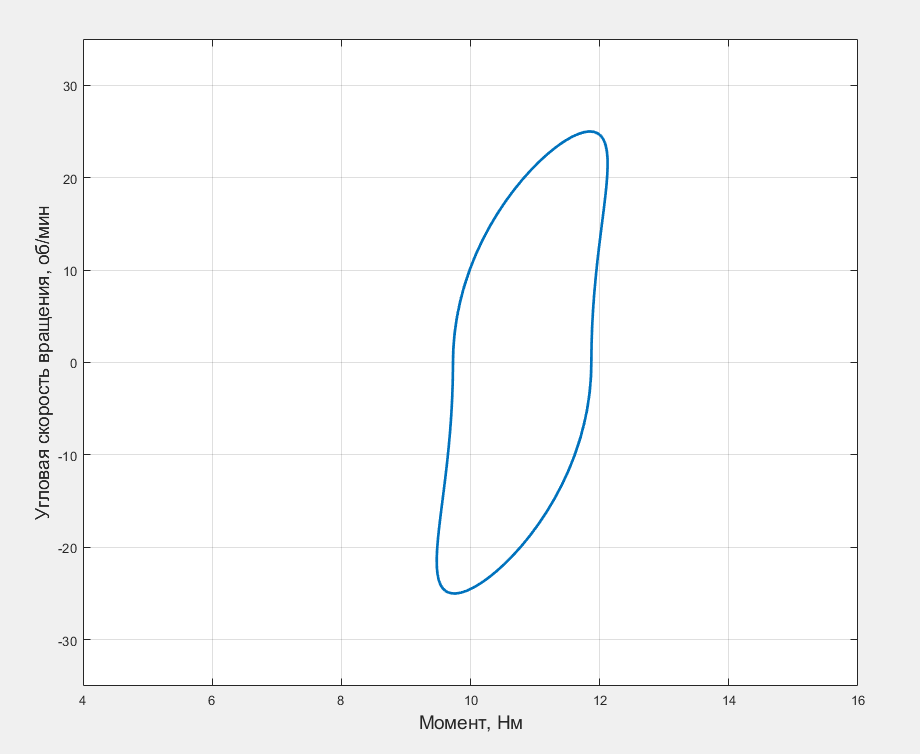
[picture p54: figure]

Рисунок 6 – Нагрузочная характеристика первого привода подводного электромеханического манипулятора

Из графика на рисунке 6 видно, что основную часть нагрузки составляет внешний статический нагрузки, когда динамический момент и гидродинамический момент сопротивления вносят меньший вклад в момент нагрузки гидропривода. Это происходит из-за небольших габаритов манипулятора и относительно небольших скоростей вращения его приводов. Также стоит отметить, что с помощью нагрузочной характеристики можно определить максимальный момент нагрузки Mmax = 12.3 Н·м, а максимальная мощность нагрузки P_н = 28 Вт.

## 2.3 Выбор двигателя и механической передачи электромеханического привода подводного манипулятора

Исходя из максимальной мощности нагрузки будем выбирать двигатель мощностью 60 Вт. Выбор правильность выбора двигателя будем осуществлять путём сравнения механической и нагрузочной характеристики привода. Эти характеристики должны удовлетворять следующему условию [1]

|M_(эп) (α_(эп) )|≥|M_н (α_н )| , (15)

где:

M_(эп) (α_(эп) ) – механическая характеристика электромеханического привода;

M_н (α_н ) – нагрузочная характеристика электромеханического привода. Иными словами, механическая характеристика электромеханического привода должна охватывать его нагрузочную характеристику.

В качестве двигателя для разрабатываемого привода был выбран коллекторный двигатель мощностью 60 Вт Faulhaber 3257 024CR, а в качестве редуктора к двигателю был выбран Faulhaber 42GPT с передаточным числом i = 196. Ниже в таблицах 2 и 3 представлены их основные характеристики.

Таблица 2 – Основные характеристики двигателя Faulhaber 3257 024CR

Номинальное напряжение | В | 24
Скорость холостого хода | об/мин | 5900
Ток холостого хода | мА | 129
Пусковой момент | мНм | 539
Номинальный момент | мНм | 71
Номинальная скорость | об/мин | 5200
Номинальный ток | А | 2.3
КПД | % | 83
Момент инерции ротора | г⋅см^2 | 41
Электромеханическая постоянная времени | мс | 4.7

Таблица 3 – Основные характеристики планетарного редуктора Faulhaber 3257 42GPT

Максимальный продолжительный момент | Нм | 15
Максимальный мгновенный момент | Нм | 20
Максимальная продолжительная скорость входного вала | об/мин | 10000
Максимальная мгновенная скорость входного вала | об/мин | 13000
Передаточное число | - | 196
КПД | % | 80
Мёртвый ход | о | 0.4

Как видно из таблицы 3 редуктор имеет высокий КПД и довольно высокий максимальный передаваемый момент, который больше максимального момента нагрузки, также данный редуктор подходит по скорости вращения входного вала.

Теперь построим механическую характеристику привода. Механическая характеристика ДПТ описывается уравнением

n=n_(хх) (1-M/(M_(пуск))) , (16)

где:

n_(хх) – скорость холостого хода;

M_(пуск) – пусковой момент электродвигателя.

С учётом редуктора уравнение (16) примет следующий вид

n_(ред) =(n_(хх))/i(1-(M_(ред))/(M_(пуск) iμ)), (17)

где:

μ – КПД редуктора, μ = 0.8;

i – передаточное число редуктора, i = 196;

M_(ред) – момент на выходном валу редуктора;

n_(ред) – скорость выходного вала редуктора.

Теперь мы можем построить механическую характеристику электромеханического привода. На рисунке 7 показаны графики нагрузочной и механической характеристики. Как видно из рисунка 7 механическая характеристика охватывает нагрузочную, а значит неравенство (15) выполняется.

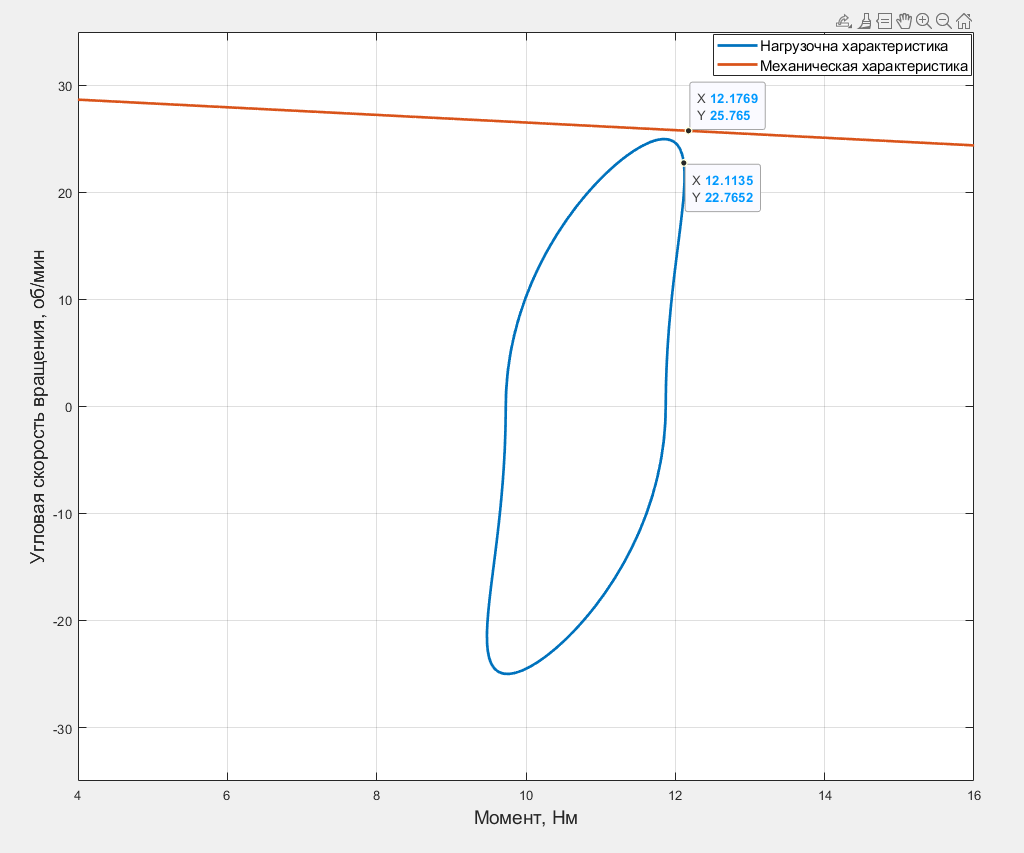
[picture p55: figure]

Рисунок 7 – Механическая и нагрузочная характеристика привода

Теперь рассмотрим тепловой режим, в котором работает двигатель. Рассмотрим точку максимальной мощности на нагрузочной характеристике и найдём соответствующую ей точку на механической характеристике привода. Эти точки отмечены на графиках на рисунке 7. На координаты точки механической характеристики показывают значения момента и скорости на выходном валу редуктора. Определим по ним соответствующие значения на валу двигателя:

n_(дв) =n_(ред) ⋅i = 25.7 ⋅196 = 5050 об/мин,

M_(дв) =(M_(ред))/(μ⋅i)=12.1/(196⋅0.8)= 77 мН·м

Как видно из рисунка 8, полученные значения близки к номинальным режиму работы двигателя и входят в режим продолжительной работы. Исходя из этого, можно сделать вывод, что двигатель выбран верно.

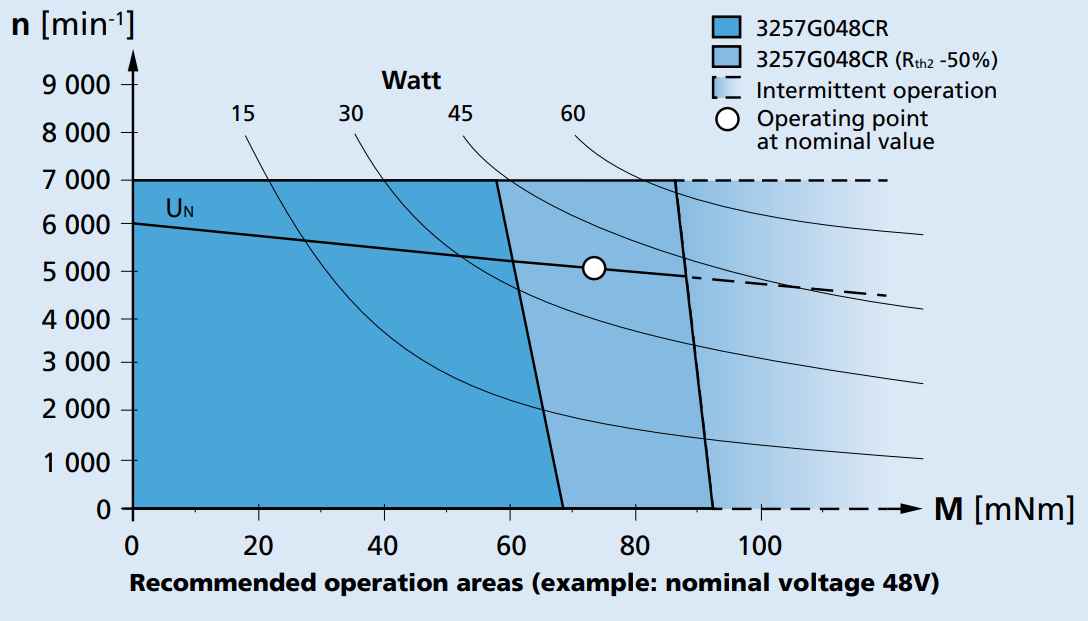
[picture p56: figure]

Рисунок 8 – Рабочие диапазоны двигателя рабочие диапазоны двигателя Faulhaber 3257 024CR

# 3 Составление математической модели привода электромеханического подводного манипулятора

Теперь составим математическую модель нашей системы. Начнём её с составления математической модели ДПТ. ДПТ описывается следующими уравнениями:

U=(Ldi)/(dt)+r+k_u ω_(дв) , (18)

M_(дв) =k_m i , (19)

где:

U – напряжение управления двигателя;

L – индуктивность обмоток двигателя;

r – сопротивление обмоток двигателя;

i – ток в обмотках двигателя;

M_(дв) – момент на валу ДПТ;

k_u – коэффициент противо-ЭДС;

k_m – моментный коэффициент.

Также у нас присутствует механическая передача, которая описывается следующими уравнениями:

ω_(дв) =ω_(ред) i , (20)

M_(дв) =(M_(ред))/(iμ)+J_р (dω)/(dt) , (21)

где J_р – момент инерции ротора двигателя.

Момент на выходном валу редуктора описывается в соответствие с выражением (2). Теперь запишем все эти выражения в операторной форме

U=Lsi+ri+k_u ω_(дв) , (22)

M_н =(J_н sω_(ред) +k_(гд) ω_(ред)^2 sgn(ω_(ред) )+M_в ) , (23)

M_(дв) =(M_(ред))/(iμ)+J_р sω_(дв) (24)

Выразим из (22) функцию i

i=(U-k_u ω_(дв) )1/(Ls+r) , (25)

Теперь выразим ω_(ред) из (24). Для этого распишем выражение для момента на валу двигателя более подробно

M_(дв) =(J_н sω_(ред) +k_(гд) ω_(ред)^2 sgn(ω_(ред) )+M_в )1/(iμ)+J_р sω_(дв) , (26)

Приведём момент инерции нагрузки J_н к валу двигателя и получим приведённый момент инерции нагрузки J_п

M_(дв) =(k_(гд) ω_(ред)^2 sgn(ω_(ред) )+M_в )1/(iμ)+(J_р +(J_н)/(i^2 μ)) sω_(дв)

M_(дв) = (k_(гд) ω_(ред)^2 sgn(ω_(ред) )+M_в )1/(iμ)+(J_р + J_п ) sω_(дв) , (27)

J_п =(J_н)/(i^2 μ) . (28)

Выразим из уравнения (27) ω_(дв)

ω_(дв) =(M_(дв) -(M_в +k_(гд) ω_(ред)^2 sgn(ω_(ред) ))1/(iμ))1/((J_н +J_п )s) . (29)

Далее по уравнениям (29), (25), (20) составим математическую модель нашего привода. Очевидно, что гидродинамический момент сопротивления вносит в данную модель нелинейность, поэтому эта модель не линейна. Её структурная схема представлена на рисунке 9.

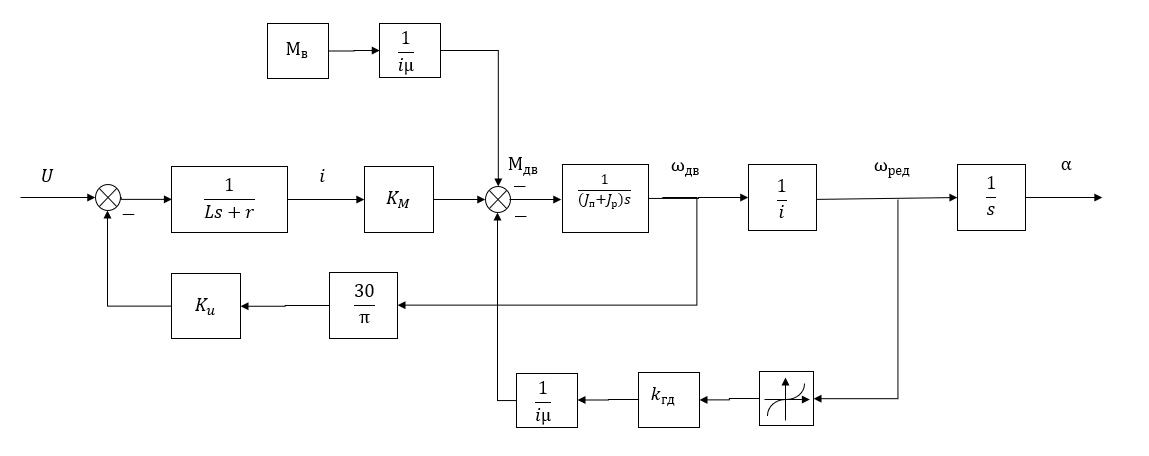
[picture p57: figure]

Рисунок 9 – Структурная схема нелинейной математической модели привода

## 3.1 Линеаризация математической модели

Наша нелинейность имеет следующий вид

f(ω)=ω^2 sgn(ω).

Поскольку угол наклона касательной в области малых скоростей у данной функции стремиться к 0, то разложение в ряд Тейлора использовать для линеаризации такой нелинейности нельзя. Тогда будет использован метод наименьших квадратов. Проводить линеаризацию будем на отрезке ω = -3.2 …3.2 рад/с. Аппроксимация в этом случаем будет иметь следующий результат

f(ω)=ω^2 sgn(ω)≈k_л ω , (30)

где k_л – коэффициент линеаризации. В нашем случае он принимает значение k_л = 2.4. На рисунке 10 представлен результат аппроксимации параболической нелинейности.

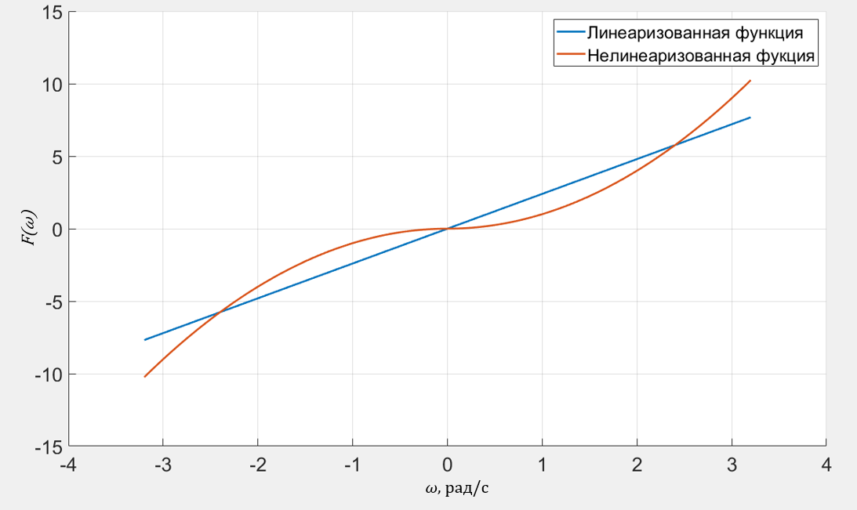
[picture p58: figure]

Рисунок 10 – Результат аппроксимации параболической нелинейности

Структурная схема линеаризованной математической модели привода с учетом выражения (30) представлена на рисунке 11.

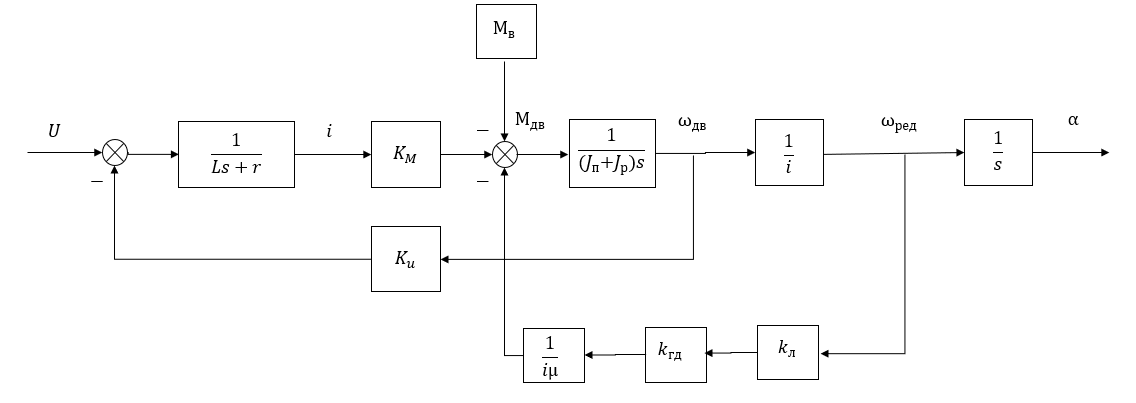
[picture p59: figure]

Рисунок 11 – Блок схема линеаризованной математической модели привода

Ниже, в таблице 4 представлены численные значения параметров линеаризованной математической модели.

Таблица 4 – Численные значения параметров математичкой модели

Индуктивность обмоток двигателя L | Гн | 0.00027
Сопротивление обмоток двигателя r | Ом | 1.63
Моментный коэффициент двигателя KM | Н · м/А | 0.0377
Коэффициент противо – ЭДС Ku | В/об/мин | 0.003395
Передаточное число редуктора i | - | 196
КПД редуктора μ | % | 80
Коэффициент гидродинамического сопротивления kгд | Н · м /(рад/с)^2 | 0.139
Коэффициент линеаризации kл | - | 2.4
Момент инерции ротора Jp | кг⋅м^2 | 0.0000042
Приведённый момент инерции Jп | кг⋅м^2 | 0,000014

## 3.2 Выбор потенциометрического датчика угла поворота и определение его передаточной функции

Для организации обратной связи по положению выходного вала привода будем использовать абсолютный датчик поворота угла. В качестве абсолютного датчика угла будет использован потенциометрический датчик PRS-65-A502. Его характеристики представлены в таблице 5.

Таблица 5 – Основные характеристики датчика PRS-65-A502

Диапазон измерения угла поворота | о | 0…355
Точность | % | 0 ± 01
Напряжение питания | В | 0…42
Рабочая температура | Со | -40…100

Выходная величина с датчика – постоянное напряжение, которое прямо пропорционально углу поворота вала, на который этот датчик установлен.

Поскольку для организации обратной связи используется аналоговый датчик, а СУ цифровая, то для передачи данных с датчика в СУ будет использован АЦП (аналого – цифровой преобразователь). В результате обработки выходного напряжения с датчика положения на АЦП получим цифровой код, соответствующий углу поворота выходного вала. Сигнал с АЦП – дискретный, но из-за достаточно высокой разрядности используемого АЦП (Atmega16 имеет десятиразрядный встроенный АЦП, который и будет использоваться для соответствующих преобразований) можно аппроксимировать его выходной сигнал до линейного. Тогда, исходя из вышеуказанных соображений, примем передаточную функцию датчика

W_д =1. (31)

# 4. Синтез САУ привода электромеханического подводного манипулятора

Теперь, когда у нас есть линеаризованная математическая модель начнём синтез САУ привода электромеханического подводного манипулятора. Манипуляторы – прецизионные системы, поэтому главное требование к их САУ — высокие показатели точности положения выходного звена и, как следствие, низкие значения перегулирования. Требования к нашей САУ следующие:

- значение установившейся ошибки ≤ 1о;
- значение перерегулирования ≤ 1%;
- время переходного процесса ≤ при задающем воздействие 100о 1c:
- запас по фазе ≥ 25o:
- запас по амплитуде ≥ 25 дБ.

Построим ЛФЧХ И ЛАЧХ нашей математической модели, они приведены на рисунке 12 линией синего цвета.

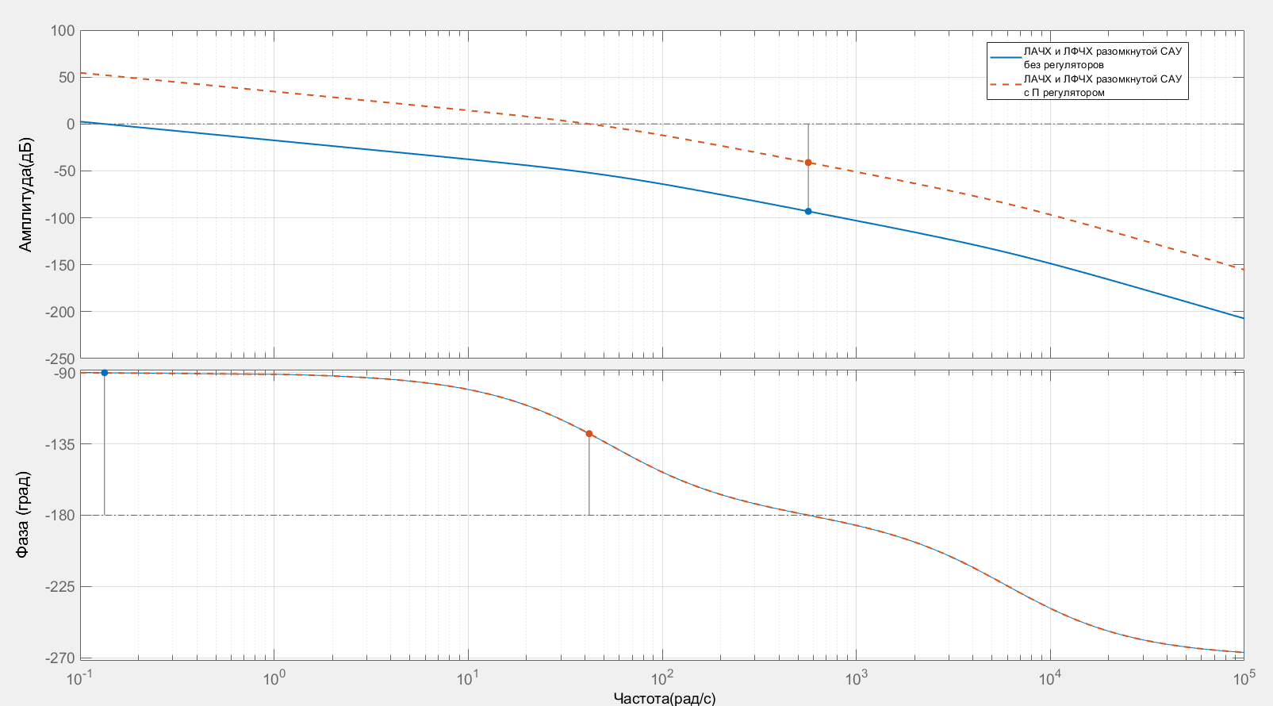
[picture p60: figure]

Рисунок 12 – ЛАЧХ и ЛФЧХ математической модели привода

Как видно, наша ЛАЧХ математичкой модели начинается с -1 наклоном, что значит, что модель имеет первый порядок астатизма. Также стоит отметить, что ЛАЧХ проходит низко и её можно поднять введением П регулятора. Введём П регулятор с коэффициентом Kp = 400 и замкнём нашу систему единичной обратной связью. ЛАЧХ и ЛФЧХ САУ с П регулятором представлены на рисунке 12 линиями оранжевого цвета. Такой коэффициент усиления регулятора поднимет ЛАЧХ САУ и оставит запасы по устойчивости по амплитуде 41дБ и 51о по фазе.

На рисунке 13 представлен переходной процесс САУ с П регулятором при ступенчатом воздействии. На рисунке 13 и далее в этом разделе синей линией показан выходной сигнал, оранжевой – величина задающего воздействия, а пунктирами – полки ±5% .

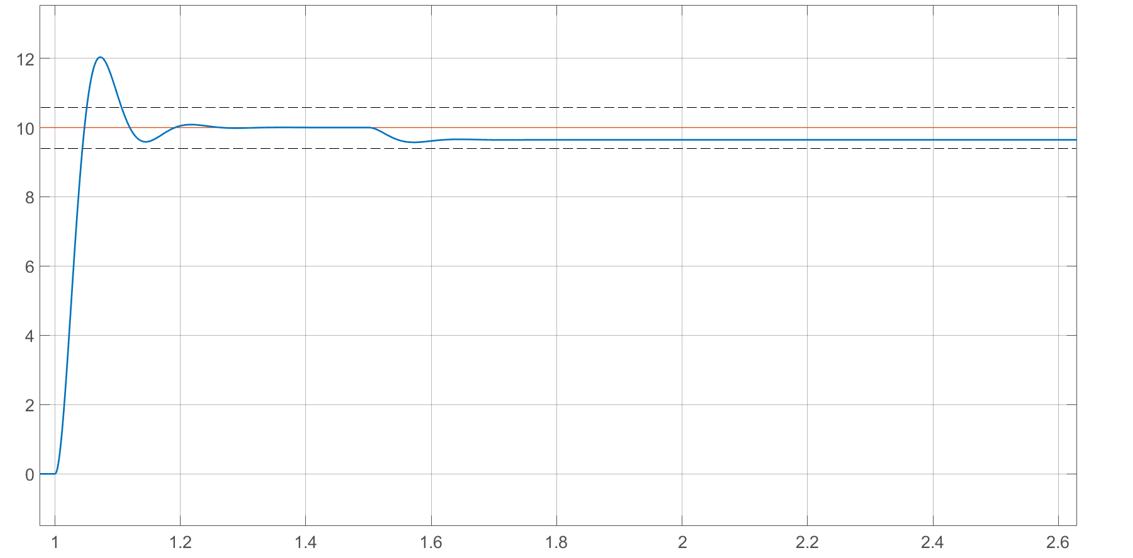
[picture p61: figure]

Время, с

Уровень сигнала, град

Рисунок 13 – Переходной процесс замкнутой системы с П регулятором

C момента времени t = 1 с на вход САУ подаётся задающий сигнал α = 10о, видно как система отрабатывает его с перерегулированием σ = 19 % и временем переходного процесса t_(пп) = 0.1 с. На моменте времени t = 1.5 с начинает действовать внешний момент M_в = 9 Н⋅м , из рисунка 13 видно, как в этот момент времени в САУ возникает статическая ошибка ε около 0.4о. Такая САУ не удовлетворяет требованиям ТЗ (технического задания).

Тогда реализуем типовую систему управления приводами манипулятора с использованием ПИД (пропорционального дифференциального интегрального) – регулятора. Структурная схема с ПИД регулятором приведена на рисунке 14, где объект регулирования – математическая модель привода электромеханического подводного манипулятора, а W_д – передаточная функция датчика.

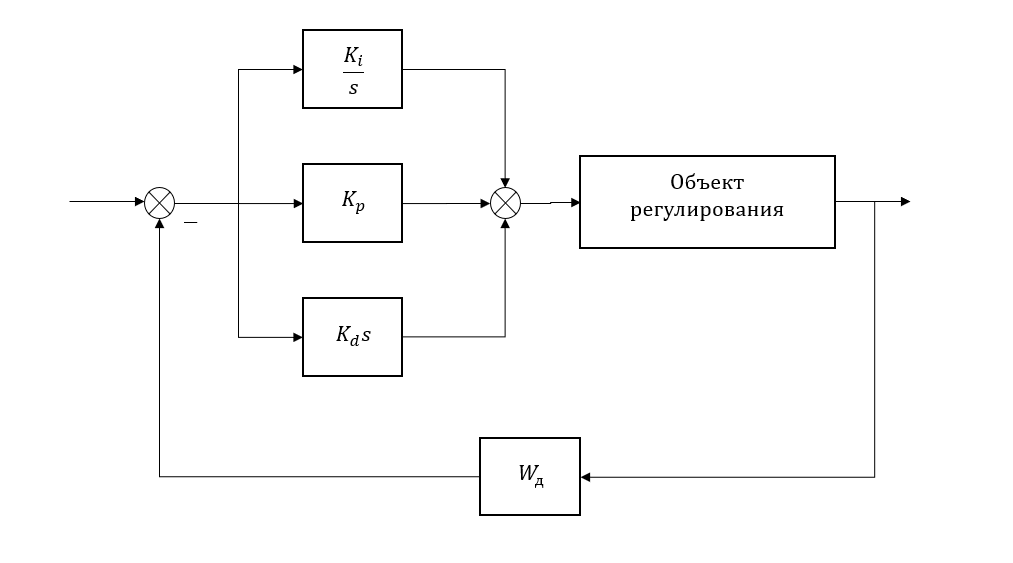
[picture p62: figure]

Рисунок 14 – Структурная схема САУ с ПИД – регулятором

Настраивать ПИД регулятор будем в соответствии с алгоритмом Циглера – Николса, который подробно описан в [2]. Стоит отметить, что главным недостатком данного метода синтеза является то, что он не учитывает требования по запасам устойчивости, учитываю только требования к переходным процессам. Установим в 0 коэффициенты усиления интегрального Ki и дифференциального Kd регуляторов и будем увеличивать коэффициент усиления Kp пропорционального регулятора до тех пор, пока САУ не выйдет на границу устойчивости. При коэффициенте Kp = 22782 можно наблюдать устойчивый колебательный переходной процесс с периодом Тu = 0.2с (рисунок 15).

Следующим шагом рассчитаем коэффициенты ПИД регулятора в соответствие со следующими формулами

К_p =0.2K_u =4567 , (32)

K_i =(0.4K_u)/(T_u) = 45564, (33)

K_d =0.066K_u T_u = 276 , (34)

где K_u – коэффициент усиления П регулятора, при котором САУ выходит на границу устойчивости.

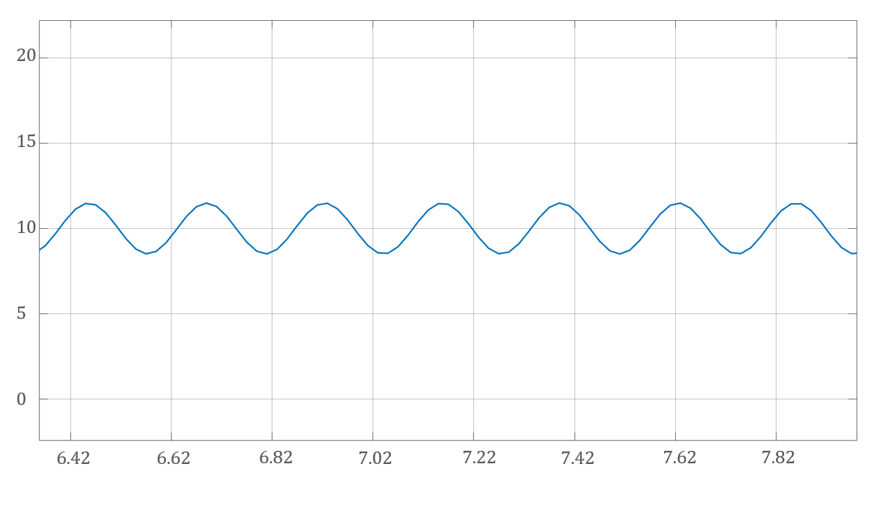
[picture p63: figure]

Уровень сигнала, град

Время, с

Рисунок 15 – Переходной процесс САУ, находящейся на границе устойчивости

При таком же воздействии, как и в случае с ПИД регулятором, получим результат, который представлен на рисунке 16, время переходного процесса составило t_(пп) = 0.33 с, а перегулирование σ= 20.2 %, устранившаяся ошибка ε_(уст) же составила меньше 0.1о. Как видно время переходного процесса уменьшилось, а влияние внешнего момента M_в значительно уменьшилось, однако перегулирование всё ещё не удовлетворяет требованиям ТЗ. Из рисунка 16 можно сделать вывод, что коэффициенты K_i и К_d имеют слишком большие значения.

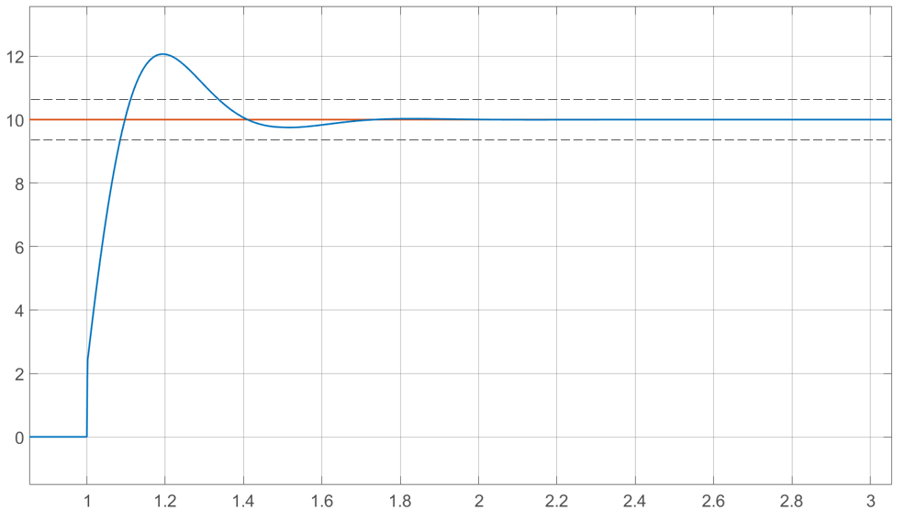
[picture p64: figure]

Время, с

Уровень сигнала, град

Рисунок 16 – Переходной процесс при входном ступенчатом воздействие

Проведём ручную подстройку этих коэффициентов. В результате были подобраны следующие значения: К_p = 4196 , K_i = 1200 , K_d = 73. На рисунке 17 представлен переходной процесс при данных коэффициентах.

Время переходного процесса составило t_(пп) = 0.05с, а перегулирование σ= 0.5% и ε_(уст) ≤0.1^o при таких параметрах ПИД – регулятора. Теперь рассмотрим ЛАЧХ и ЛФЧХ разомкнутой системы с ПИД – регулятором, чтобы оценить её запасы устойчивости по амплитуде и фазе, они представлены на рисунке 18. Получим запасы устойчивости по амплитуде 56 дБ и 57о по фазе. Из всего, вышеперечисленного, можно сделать вывод, что такая САУ удовлетворяет требованиям ТЗ.

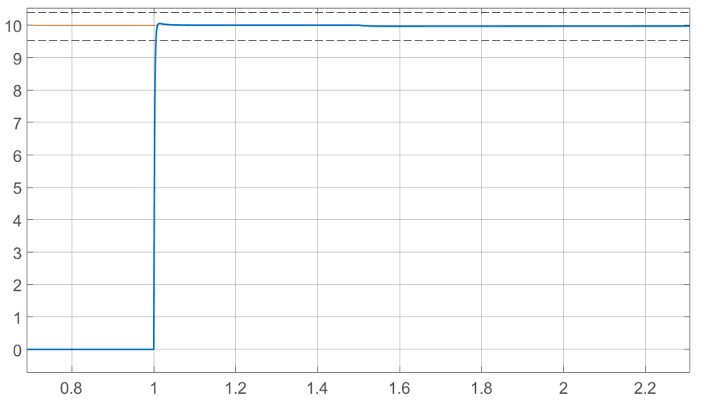
[picture p65: figure]

Время, с

Уровень сигнала, град

Рисунок 17 – Переходной процесс при коэффициентах ПИД регулятора полученных в ходе ручной подстройки

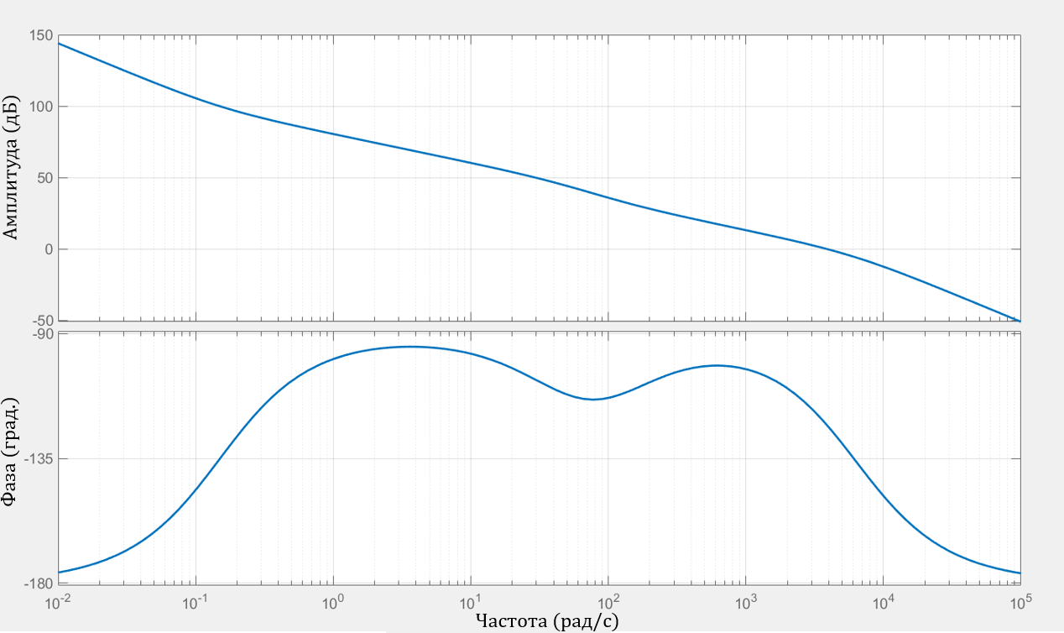
[picture p66: figure]

Рисунок 18 – ЛАЧХ и ЛФЧХ разомкнутой САУ с ПИД регулятором

Теперь проведём приближённую проверку работоспособности системы в реальных условиях. Введём в неё следующие нелинейности: ограничение напряжения перед передаточной функцией ДПТ и параболическую нелинейность в моменте гидродинамического сопротивления M_(гд) в нашу систему и исследуем нелинейную САУ. Подадим на вход САУ ступенчатое воздействие аналогичное тому, что подавали выше, с тем лишь отличием, что внешний момент M_в начинает действовать в момент времени t = 2 с. Однако, поскольку сейчас имеем нелинейную систему, рассмотрим две величины входного воздействия – малую, с уровнем задающего сигнала 1о, и большую, с уровнем задающего сигнала 100о. На рисунке 19.а представлен переходной процесс при малом задающем воздействие, а на 19.б при большом.

а)

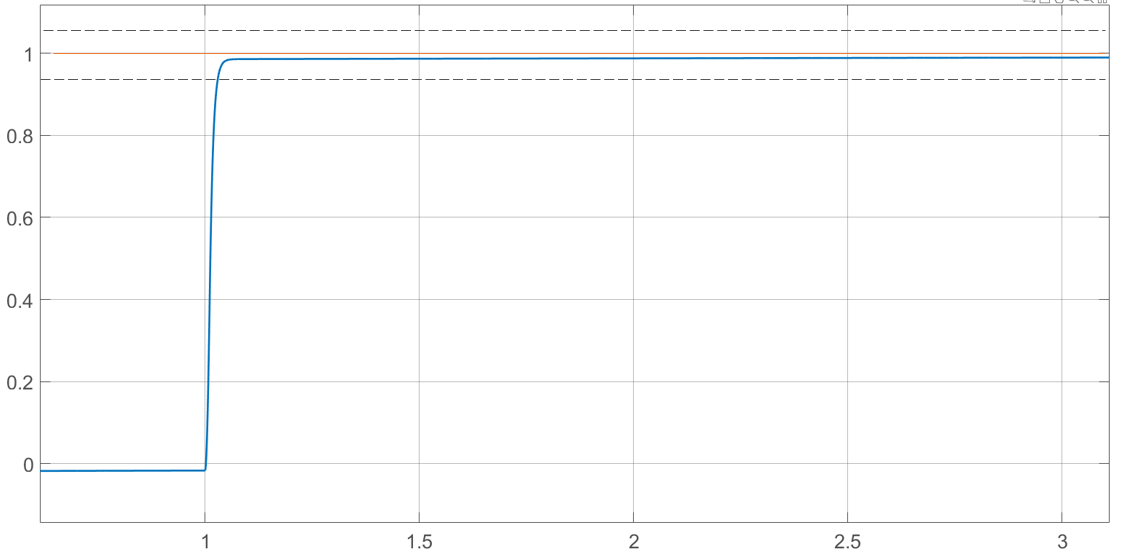
[picture p67: figure]

Уровень сигнала, град

б)

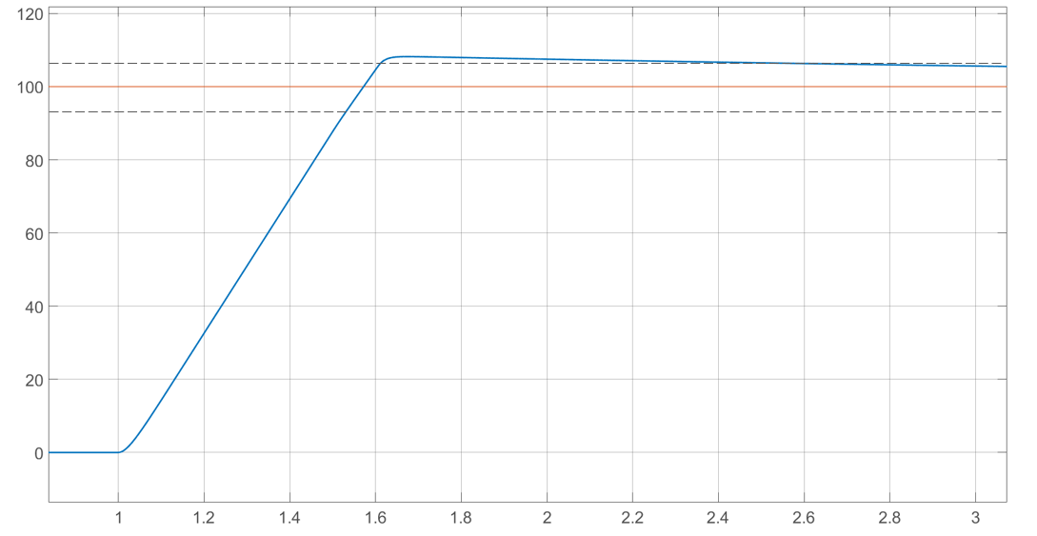
[picture p68: figure]

Уровень сигнала, град

Время, с

Рисунок 19 - Переходные процессы в нелинейной САУ при а – малом
входном сигнале, б – при большом входном сигнале

Как видно из рисунка 19.б при больших входных воздействиях установившийся сигнал имеет отличное от задающего значение. Ошибка в случае большого воздействия составила 4.9о, что не удовлетворяет ТЗ.

Тогда заменим обычный интегратор в ПИД регуляторе на интегратор с ограничением насыщения, задав полки ограничения насыщения -24 и 24 соответственно, что соответствует ограничению напряжения управления двигателем. Проведём повторную симуляцию. Переходные процессы приведены на рисунке 20.

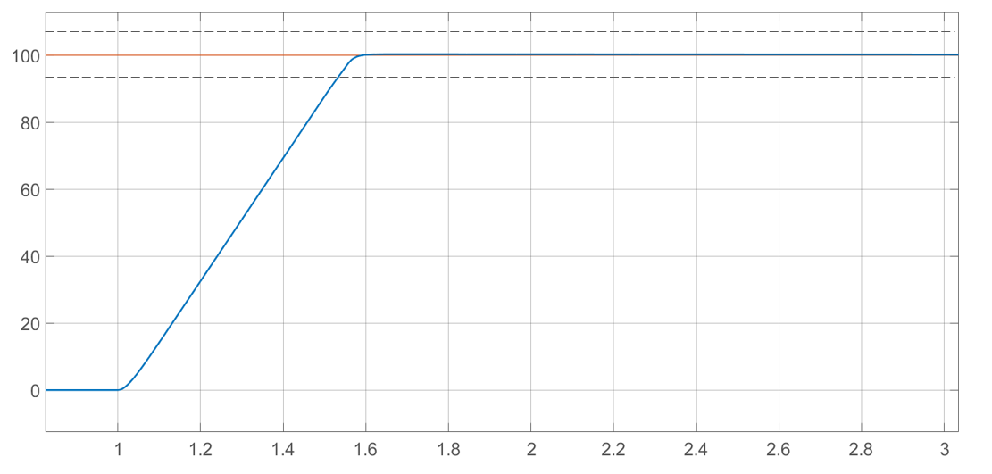
[picture p69: figure]

б)

а)

Уровень сигнала, град

Уровень сигнала, град

Время, с

Рисунок 20 – переходные процессы в нелинейной САУ при уменьшенном коэффициенте усиления K_i при а – малом входном воздействие, б – при большом входном воздействие

Как видно из рисунка 20, теперь значение установившегося сигнала ближе к задающему. При малом входном воздействие переходного процесса составило t_(пп) = 0.02с, перегулирование σ= 0.1% и значение ошибки выходного сигнала составило около 0.06о; при большом входном воздействие время переходного процесса составило t_(пп) = 0.51 с, перегулирование σ= 0.83 % и отклонение от задающего сигнала около 0.4о. Из этого можно сделать вывод, что синтезированная САУ подходит по пребываниям ТЗ. Итоговые коэффициенты ПИД регулятора составили следующие значения K_p = 4196,K_i = 1200, K_d = 73 , полки ограничения насыщения, встроенного в интегратор, составили -24 и 24 соответственно.

Из графика б на рисунке 19 можно определить максимальную скорость, которую развивает привод. Она соответствует наклону прямой в то время, пока работает как разомкнутая. Рассчитаем её значение согласно следующей формуле

ω_(max) =(30A)/(πt_(пп))=(30⋅100)/(π⋅0,60) ≈ 27,6 об/мин

где:

ω_(max) – максимальная угловая скорость, развиваемая приводом;

A – амплитуда сигнала, которая достигается за t_(пп) .

Как видно из графика механической характеристики привода на рисунке 7, привод действительно может развить такие скорости при отсутствие внешнего момента Mв, который начинает действовать на САУ с момента времени t = 2c. Из чего можно сделать вывод, что САУ синтезирована верно и соответствует энергетике привода.

Проведём проверку полученных результатов путем поиска оптимальных коэффициентов с помощью пакета Simulink Response Optimizer. Зададим следующие параметры переходного процесса: время переходного процесса – 0.7 с, перегулирование – 1 %, время нарастания 0.6 с, нарастание - 90 %, отклонение от задающего сигнала – 1 %. На вход будем подавать ступенчатое входное воздействие с амплитудой 100о. Начальные значения коэффициентов усиления ПИД – регулятора установим в 10. На рисунке 21 представлен результат работы данного пакета.


Время, с

Уровень сигнала, град

Рисунок 21 – Результат работы пакета Simulink Response Optimizer

Тонкими чёрными линиями обозначены графики переходных процессов, которые зашли за пределы заданных параметров переходного процесса (жёлтая область). Синей линией показан график переходного процесса, который удовлетворяет заданным требованиям. Такому переходному процессу соответствуют следующие значения коэффициентов усиления ПИД регулятора: K_p = 4258, K_i = 1137.23, K_d = 65 .12. Как видно, коэффициенты, полученные в пакете Simulink Response Optimizer, близки к тем, что были получены согласно алгоритму в ходе ручной подстройки результатов алгоритма Циглера – Николса, из этого можно сделать вывод, что САУ синтезирована верно.

# Заключение

В рамках данной работы была спроектирована САУ приводом подводного электромеханического манипулятора и выбраны соответствующие устройства для её реализации. В качестве двигателя привода был выбран ДПТ Faulhaber 3257 024CR, в качестве механической передачи был выбран планетарный редуктор Faulhaber 3257 42GPT. Для организации обратной связи был использован потенциометрический датчик угла PRS-65-A502. В результате синтеза САУ была получена система с ПИД – регулятором с коэффициентами усиления в соответствующих ветвях K_p = 4196,K_i = 1200, K_d = 73 , также в интегратор было установлено насыщение с ограничением с полками, соответствующими напряжению управления двигателя, -24 и 24. Спроектированная САУ соответствует всем требованиям, указанным в ТЗ.

# Список литературы

1) Проектирование движительных комплексов подводных аппаратов М. : Издательство МГТУ им. Н. Э. Баумана / В. В. Вельтищев, 2019 – 167 с.

2) Теория систем управления.: М., МГГУ / Л. Д. Певзнер. под ред.
Сытдыковой А. Н. , 2002 – 235 с.

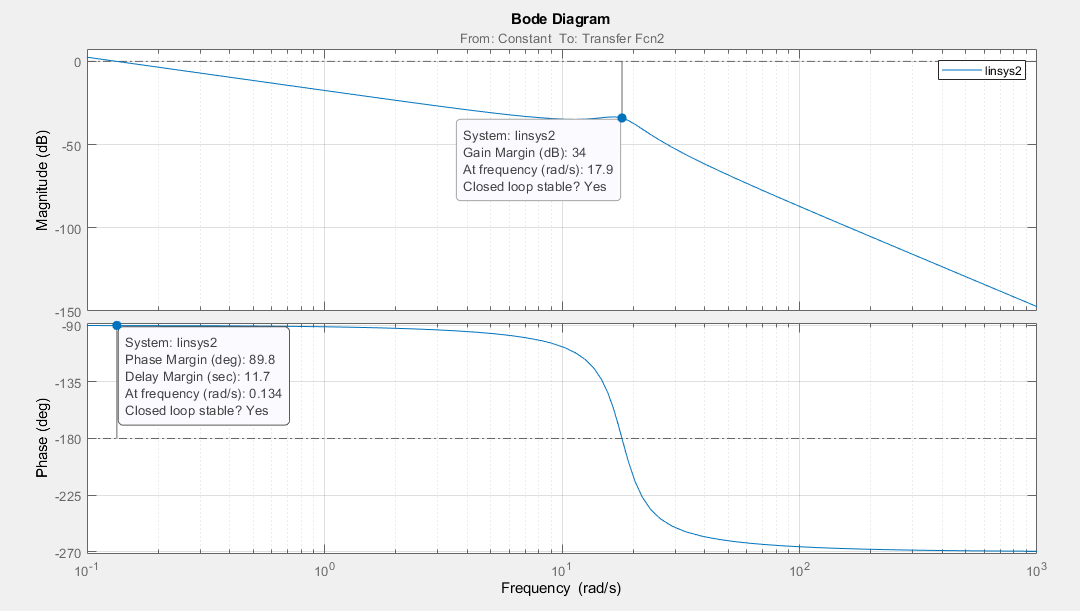
[picture p70: figure]

(J_н +K(d^2 α)/(dt^2)M_(ст) sgn((dα)/(dt))+b((dα)/(dt))+k_(гд) ((dα)/(dt))^2 sgn((dα)/(dt))+cα+M_в

(J_н +J_д )

Для проведем исследования имеющейся математической модели найдём её передаточную функцию, для этого проведём структурные преобразования имеющейся структурной схемы. Их результаты приведены на рисунке 10.

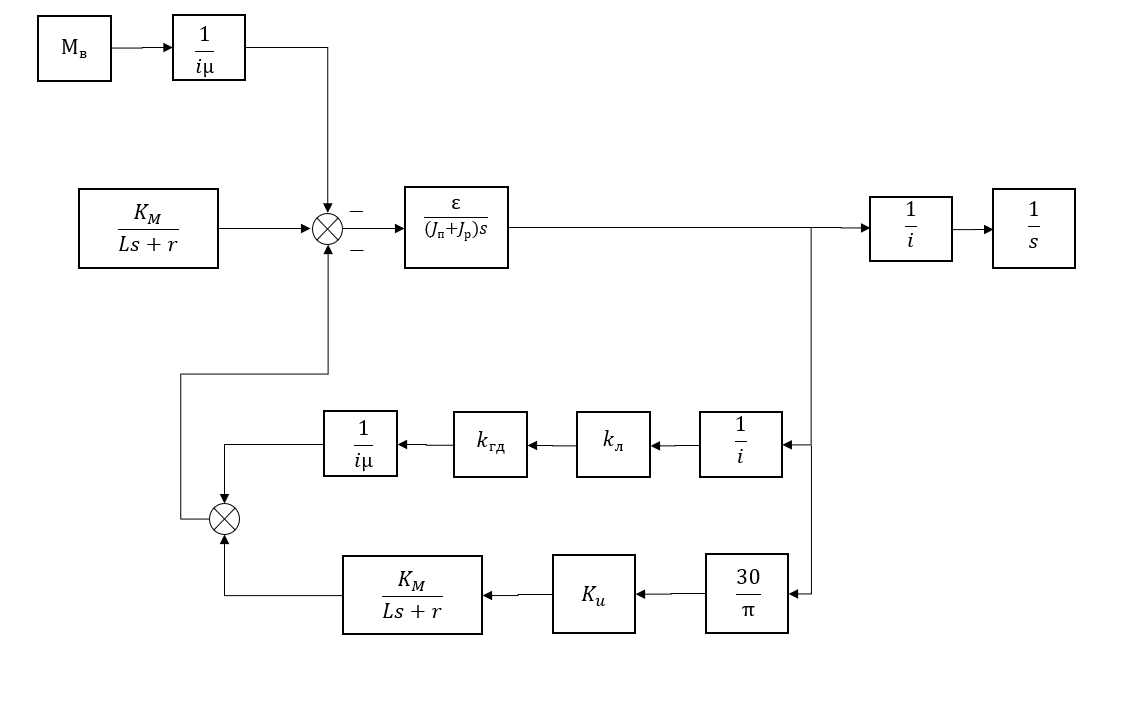
[picture p71: figure]

Рисунок 10 – Преобразованная математическая модель привода.

Согласно структурной схеме на рисунке 10 получим передаточную функцию системы

W(s)=(0.001653s+0.00998)/(1.458e^(-6) s^4 +1.856e^(-5) s^3 +0.01286s^2 +0.0773s). (31)

Ниже, на рисунке 11 приведены ЛФЧХ (логарифмическая фазовая частотная характеристика) и ЛАЧХ (логарифмическая амплитудная частотная характеристика).

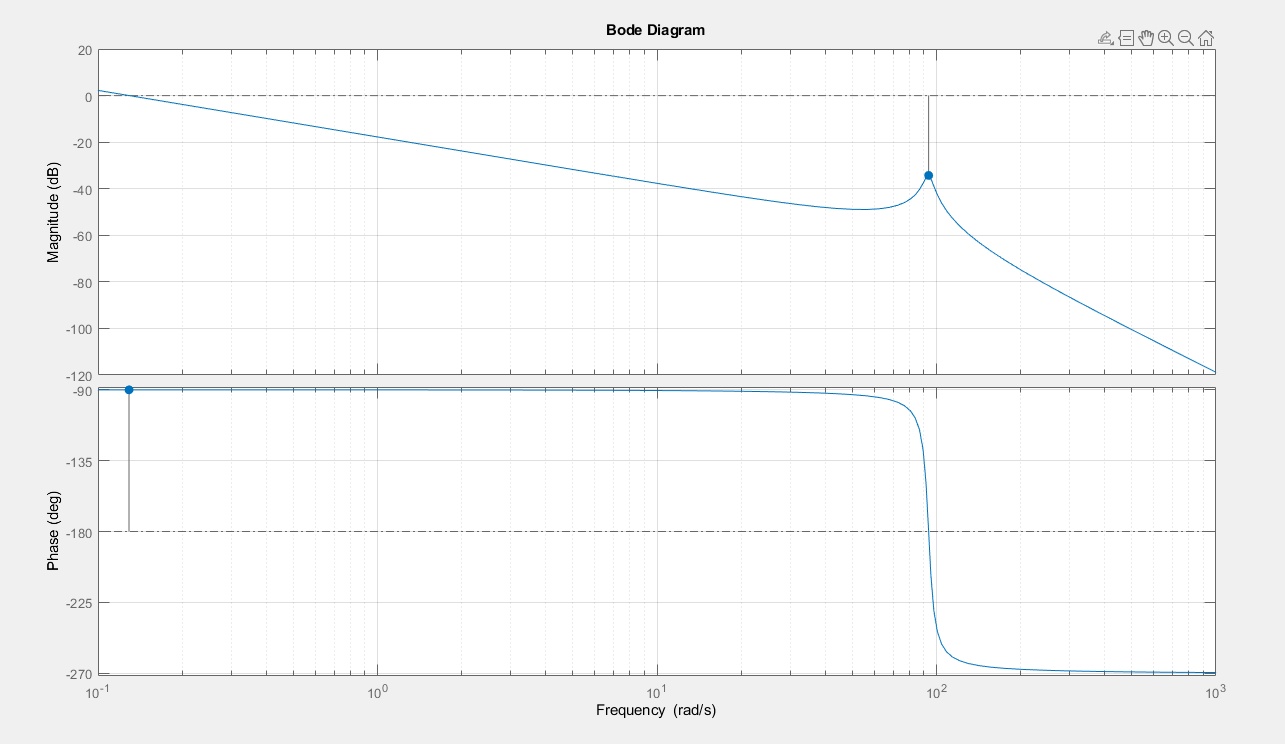
[picture p72: figure]

Как видно из рисунка 11, мы имеем запас устойчивости по коэффициенту усиления 34 дБ и по фазе 90. Введём П (пропорциональный) регулятор с коэффициентом усиления k_p = 13 . Это не выведет нашу систему в неустойчивое состояние, но позволит нам оценить качество переходного процесса. Из рисунка 12 видно, что замкнутая система удовлетворяет требованиям по перерегулированию, но не по времени переходного процесса. Мы не можем оценить точность системы так как данная САУ не учитывает внешний статический момент M_в . Для него проведём отдельную симуляцию.

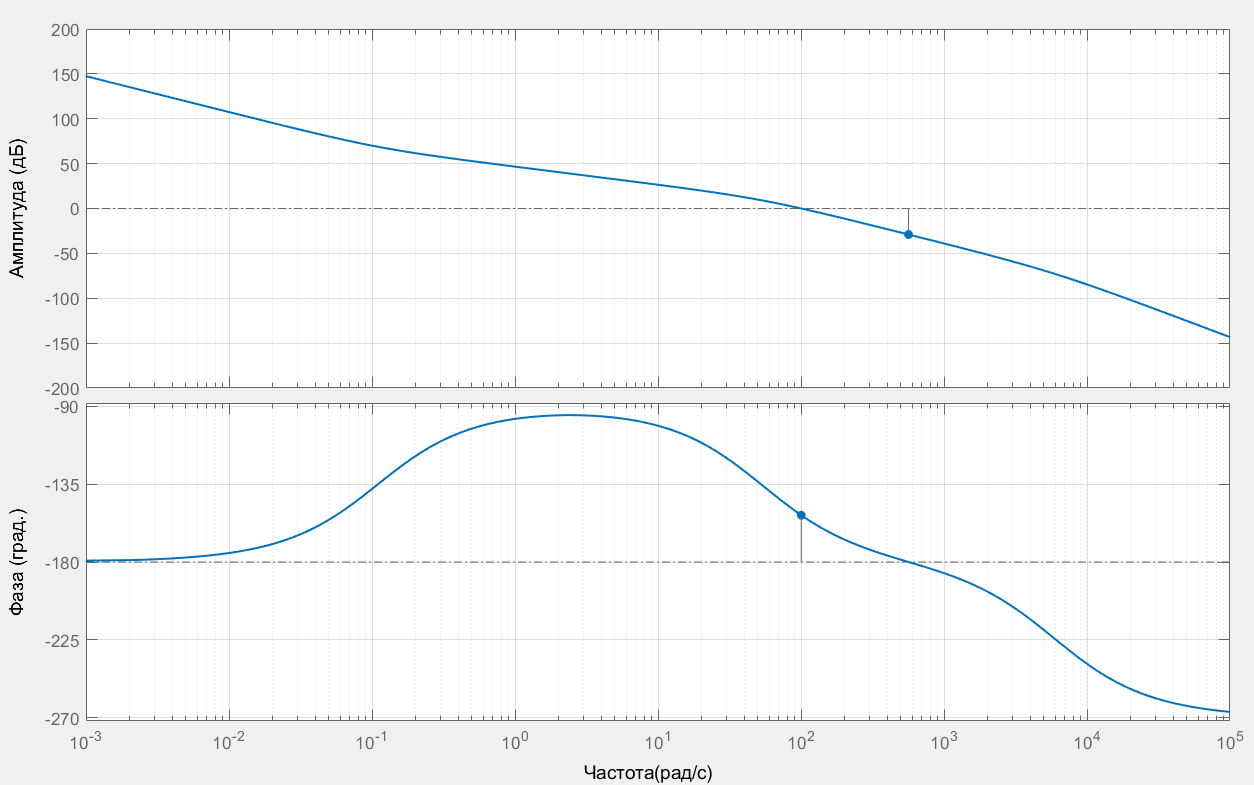
[picture p73: figure]
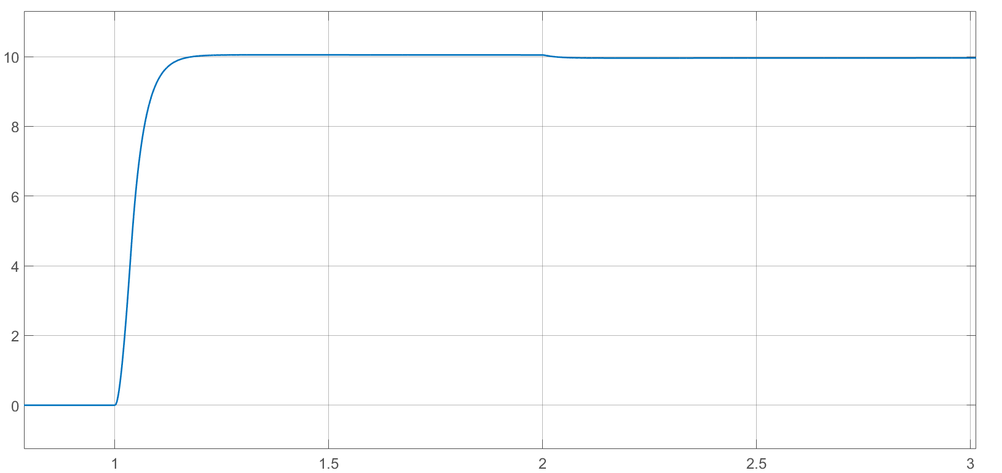
[picture p74: figure]
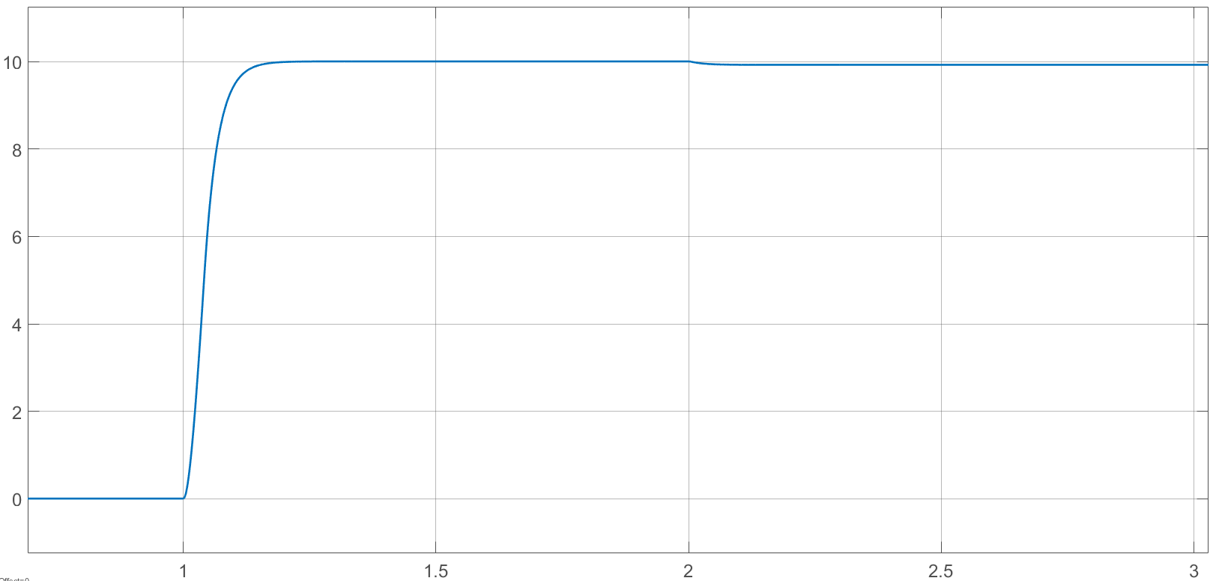
[picture p75: figure]
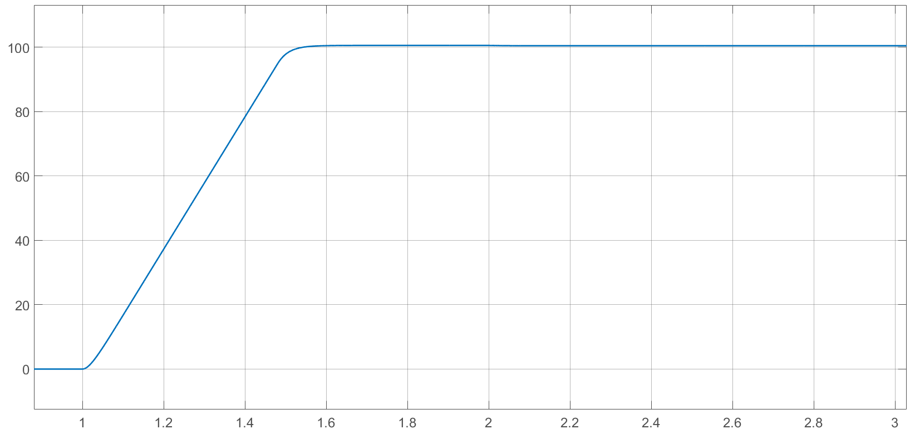
[picture p76: figure]
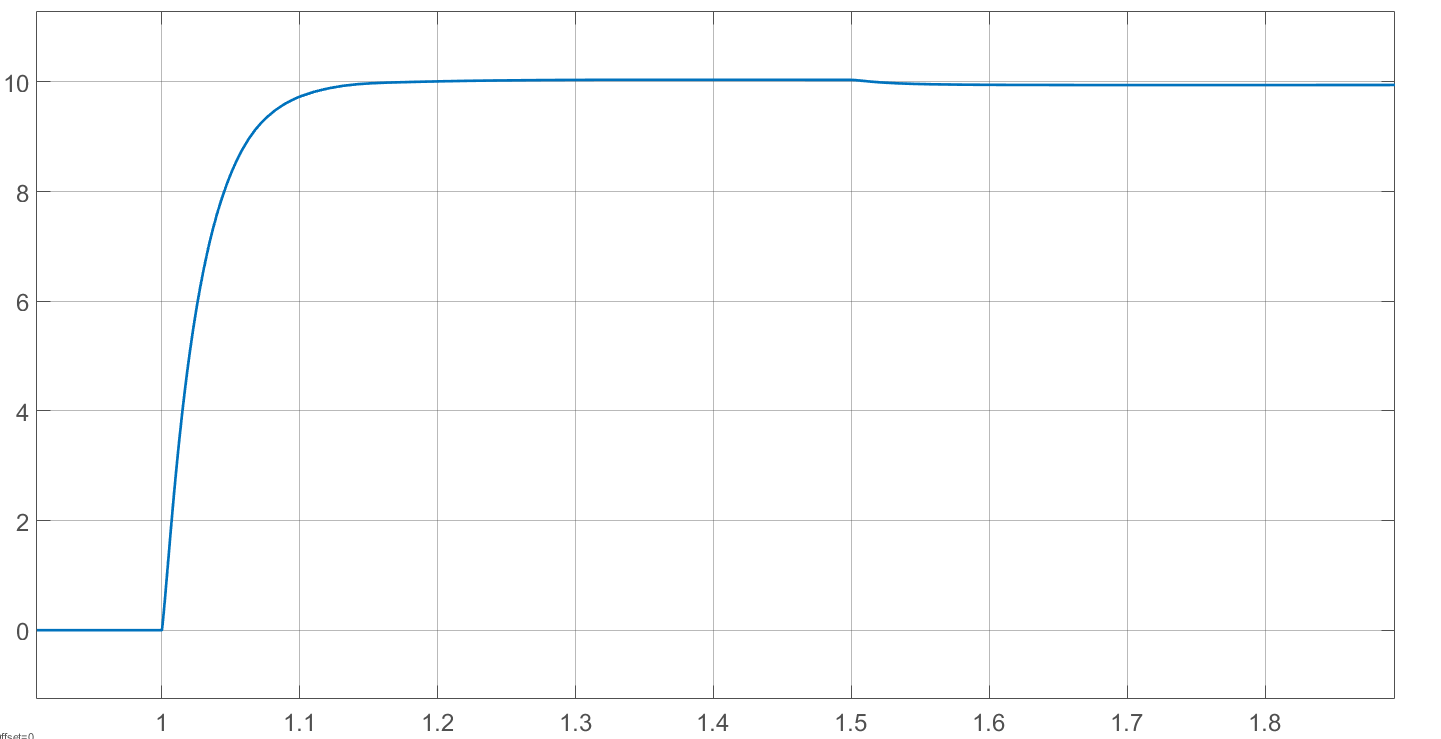
[picture p77: figure]

Время, с

Амплитуда сигнала, град

Настраивать ПИД регулятор будем в соответствии с алгоритмом Циглера – Николса, который подробно описан в [2]. Стоит отметить, что главным недостатком данного метода синтеза является то, что он не учитывает требования по запасам устойчивости, учитываю только требования к переходным процессам. Установим в 0 коэффициенты усиления интегрального Ki и дифференциального Kd регуляторов и будем увеличивать коэффициент усиления Kp пропорционального регулятора до тех пор, пока САУ не выйдет на границу устойчивости. При коэффициенте Kp = 39998 можно наблюдать устойчивый колебательный переходной процесс с периодом Тu = 0.013с (рисунок 15).

Следующим шагом рассчитаем коэффициенты ПИД регулятора в соответствие со следующими формулами

К_p =0.2K_u = 7996 , (32)

K_i =(0.4K_u)/(T_u) = 123076, (33)

K_d =0.066K_u T_u = 35 (34)

где K_u – коэффициент усиления П регулятора, при котором САУ выходит на границу устойчивости.


Уровень сигнала, град

Время, с

Рисунок 15 – Переходной процесс САУ, находящейся на границе устойчивости

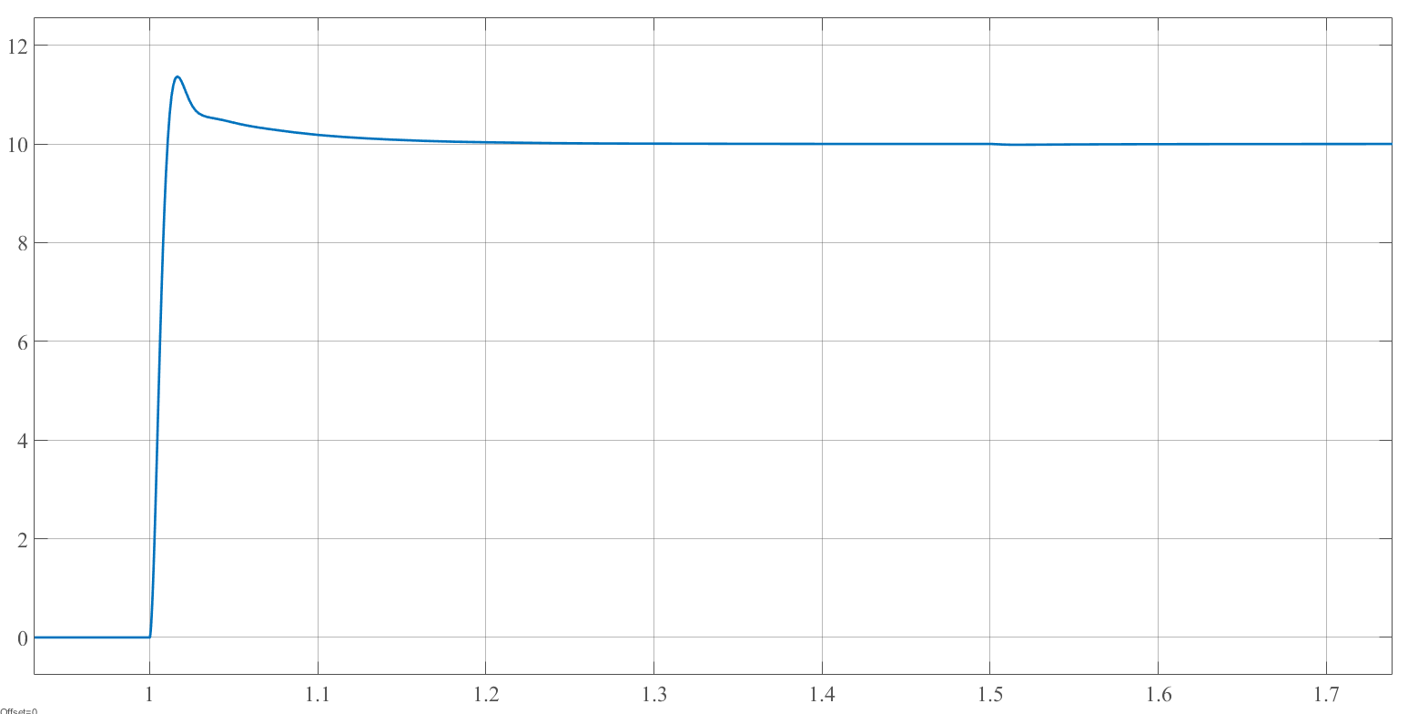
[picture p78: figure]
