orku/graduation_work/txt/research.docx

# Список сокращений

В настоящем отчете о НИР применяют следующие сокращения и обозначения:

САУ – система автоматического управления;

АФЧХ - амплитудно – фазовая частотная характеристика;

# Введение

Механические передачи являются неотъемлемой частью любых манипуляторов. Особенно часто в качестве понижающих механических передач в манипуляторах используются планетарные редукторы из-за высокого передаваемого момента и большого порядочного отношения при сравнительно малых габаритах. Однако, они вносят в систему ряд нелинейностей, которые обычно в ходе проектирования САУ (системы автоматического управления) не учитываются в виду их сложности. Одна из таких нелинейностей – мёртвый ход редуктора, который возникает из – за зазоров между зубьями зубчатых колёс в редукторе.

Целью данной работы является исследование влияния мертвого хода редуктора на САУ приводом подводного электромеханического манипулятора.

# 1 Описание системы управления приводом подводного электромеханического манипулятора

Привод подводного электромеханического манипулятора обычно состоит из коллекторного двигателя, механической понижающей передачи и датчика угла поворота, для организации обратной связи. Его математическую модель можно описать с помощью следующих уравнений

U=L(di)/(dt)+rI+k_u ω_(дв) , (1)

M_(дв) =(M_(ред))/(iμ)+J_р (dω_(дв))/(dt) , (2)

M_(дв) =k_m I , (3)

M_н =(J_н +J_д )(d^2 α)/(dt^2)+M_(ст) sgn((dα)/(dt))+b((dα)/(dt))+k_(гд) ((dα)/(dt))^2 sgn((dα)/(dt))+cα+M_в , (4)

где:

U – напряжение питания двигателя;

L – индуктивность обмоток двигателя;

r – сопротивление обмоток двигателя;

I – ток в обмотках двигателя;

k_u – коэффициент противо – ЭДС;

ω_(дв) – скорость вращения выходного вала двигателя;

M_(дв) – момент на валу двигателя;

M_(ред) – момент на выходном валу механической передачи;

i – передаточное число механической передачи;

μ – КПД механической передачи;

J_р – момент инерции ротора двигателя;

k_m – моментный коэффициент двигателя;

J_н –момент инерции нагрузки и вращающихся частей манипулятора;

J_н –момент инерции присоединенных масс;

α – угол поворота выходного звена вала;

M_(ст) – момент сухого трения, обусловленный трением в механических узлах манипулятора;

b – коэффициент вязкого трения;

k_(гд) – коэффициент гидродинамического сопротивления;

c – коэффициент позиционного момента;

M_в – внешний статический момент.

Однако математическая модель не может описывать объект в точности и содержит ряд допущений, которые принимаются исходя из задач, для которых математическая модель составлялась. Поскольку наша задача состоит в исследовании автоколебаний вызванных мёртвым ходов механической передачи, то примем следующие допущения:

- На модель не будет приложены внешние воздействия, значит внешний и позиционные моменты рассматриваться не будут;
- Нелинейность вида f(α)=((dα)/(dt))^2 sgn((dα)/(dt)) будет аппроксимирована к прямой вида f_л (α)=k_л (dα)/(dt) с коэффициентом линеаризации k_л = 2.4;
- Моменты сухого и вязкого трения, а также составляющая динамического момента от добавочных масс также не будут учитываться из-за того, что они не оказывают значительного воздействия на данный привод.

В качестве регулятора для нашей САУ (системы автоматического управления) будет использоваться ПИД – регулятор с коэффициентами
K_p = 1800, K_i = 35.2, K_d = 46 . На рисунке 1 представлена структурная схема САУ.

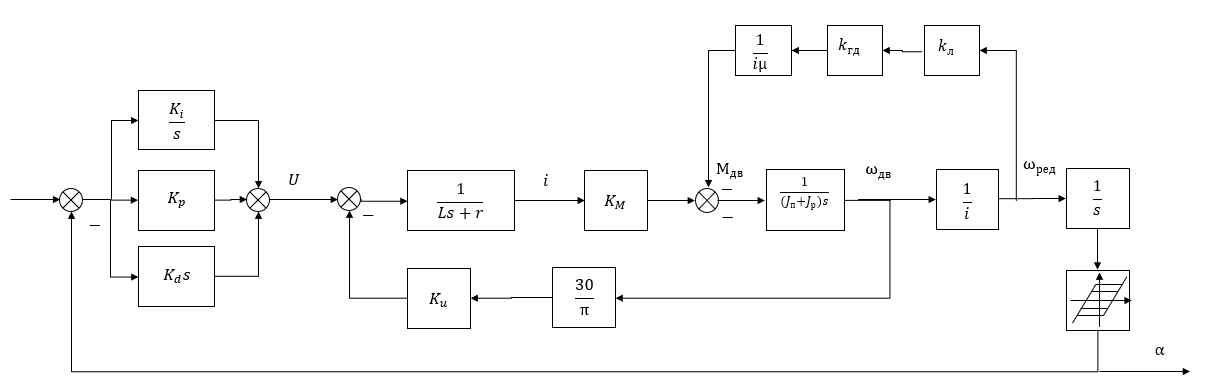
[picture p79: figure]

α

α

Рисунок 1 – Структурная схема САУ

В таблице 1 приведены численные параметры данной САУ.

Таблица 1 – численные параметры САУ

Индуктивность обмоток двигателя L | Гн | 0.00027
Сопротивление обмоток двигателя r | Ом | 1.63
Моментный коэффициент двигателя KM | Н · м/А | 0.0377
Коэффициент противо – ЭДС Ku | В/об/мин | 0.003395
Передаточное число редуктора i | - | 196
КПД редуктора μ | % | 80
Коэффициент гидродинамического сопротивления kгд | Н · м /(рад/с)^2 | 0.139
Коэффициент линеаризации kл | - | 2.4
Момент инерции ротора Jp | кг⋅м^2 | 0.0000042
Приведённый момент инерции Jп | кг⋅м^2 | 0,000014

Продолжение таблицы 1

Коэффициент усиления пропорционального регулятора K_p | - | 4196
Коэффициент усиления интегрального регулятора K_i | - | 1200
Коэффициент усиления дифференциального регулятора K_d | - | 73

Для исследования процесса автоколебаний, возникающих в данной САУ нам необходимо привести её к виду который представлен на рисунке 2.

Рисунок 2 – Типовой вид исследуемой нелинейной САУ.

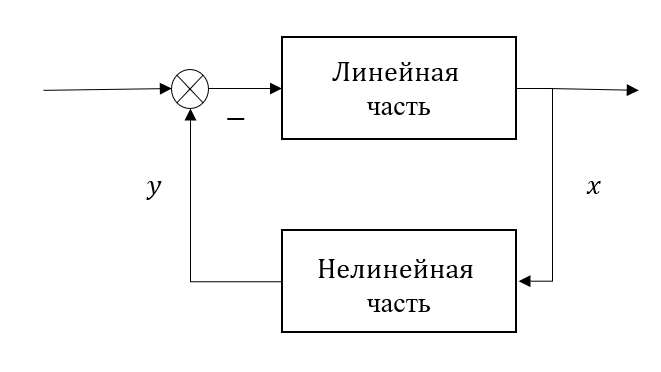
[picture p80: figure]

Выделим передаточную функцию линейной части W_л (s) . Передаточная функция линейной части вычисляется по следующей формуле

W_л (s)=W_р (s)⋅W_п (s)=(R(s))/(Q(s)) , (5)

где:

W_р (s) – передаточная функция ПИД – регулятора;

W_п (s) – передаточная функция привода.

Передаточная функция ПИД – регулятора имеет вид [4]

W_р (s)=(k(T_1 s+1)(T_2 s+1))/s . (6)

С учётом наших коэффициентов ПИД – регулятора передаточная функция W_р (s) будет иметь вид

W_р (s)=(1200(3.5s+1)(0.016s+1))/s . (7)

Определим передаточную функцию объекта управления. Преобразуем линейную часть структурной схемы привода из рисунка 1 в соответствие с правилами структурных преобразований для облегчения задачи нахождения передаточной функции линейной части. Результат этих преобразований представлен на рисунке 3.

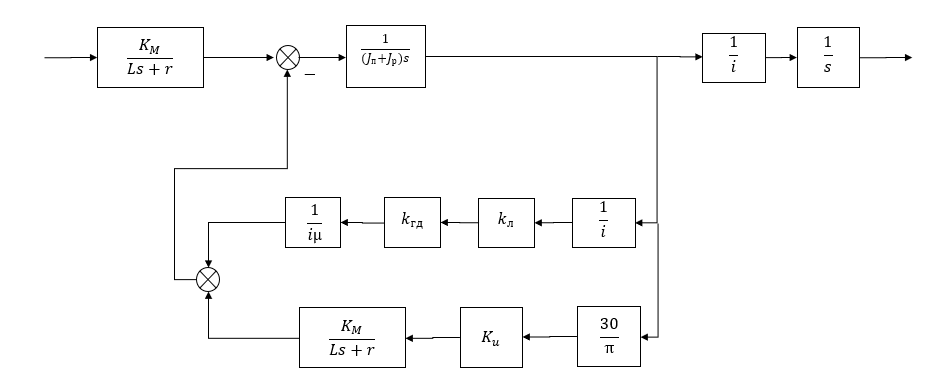
[picture p81: figure]

Рисунок 3 – Преобразованная структурная схема привода подводного электромеханического манипулятора

По структурной схеме на рисунке 3 получим следующую передаточную функцию привода:

W_п (s)=0.138/(0.000003s^3 +0.02016s^2 +s)=0.138/((0.02s+1)(0.00016s+1)s) (8)

Тогда передаточная функция линейной части будет иметь вид

W_л (s)=(165.6(3.5s+1)(0.016s+1))/((0.02s+1)(0.00016s+1)s^2) . (9)

Как видно из формулы 9 передаточная функция имеет свойство фильтра низких частот, а в системе присутствует одна нелинейность. Это значит, что можно линеаризовать нелинейность методом гармонической линеаризации.

# 2 Описание нелинейности, вызванной мертвым ходом редуктора

Мёртвый ход (люфт) создаёт такую нелинейность, которая возникает
из – за наличия зазора между зубчатыми колёсами. Математически её можно описать различными способами, самыми частыми из которых являются представления её в виде зоны нечувствительности и кусочно – линейной характеристики с гистерезисом. В данной работе будет использовано представление в виде кусочно – линейной характеристики с гистерезисом, её график изображён на рисунке 3. В дальнейшем будем называть такую характеристику «люфтом». На рисунке 3 отрезок [-b, b] задаёт значение мёртвого хода, а k – коэффициент усиления нелинейности. Согласно [5] такая нелинейность с гистерезисом описывается следующим выражением для угла

α = {, (α-b)k,если α>0, (α+b)k, если α < 0, 0, в остальных случаях , (10)

где:

α – выходной сигнал с нелинейности вида «люфт»;

α – входной сигнал нелинейности вида «люфт»;

k – коэффициент нелинейности вида «люфт», в данном случае k = 1;

b – полуширина полки мёртвого хода редуктора, в данном случае b = 0.2.

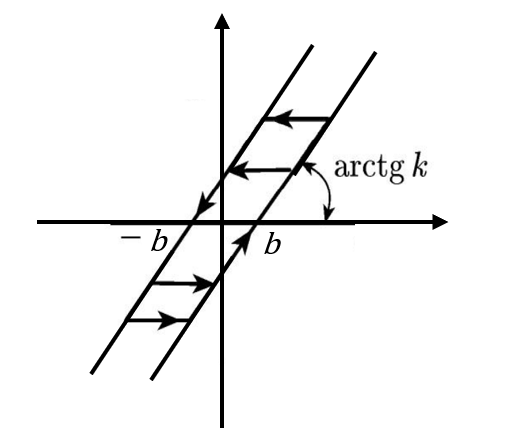
[picture p82: figure]

α

α

Рисунок 3 – график нелинейности типа «люфт»

Простимулируем нашу САУ с данной нелинейностью в пакете Simulink, подав на вход системы синусоидальный задающий сигнал c амплитудой
А* = 1о и частотой ω* = 2 рад/с. На рисунке 4 показаны графики входного и выходного сигнала с нелинейности. На нём видно, что при изменении знака производной по времени входного сигнала α происходит резкий скачок входного сигнала на величину мёртвого хода, используемого редуктора. Физически, в момент времени, когда α меняет свой знак, происходит смена направления вращения вала. Из-за наличия зазора между зубчатыми колёсами, в этот момент времени они теряют зацепление, на вал двигателя перестаёт передаваться нагрузка, в результате чего резко возрастает скорость вращения двигателя, что видно на рисунке 5, на котором показан график скорости вращения вала двигателя. Это продолжается до тех пор, пока зубчатые колёса снова не поймают зацепление и нагрузка опять не начнёт подаваться на вал двигателя. Стоит отметить, что пока зубчатые колёса не находятся в зацеплении, САУ работает как разомкнутая, как только колёса снова находятся в зацеплении, обратная связь начинает снова действовать.

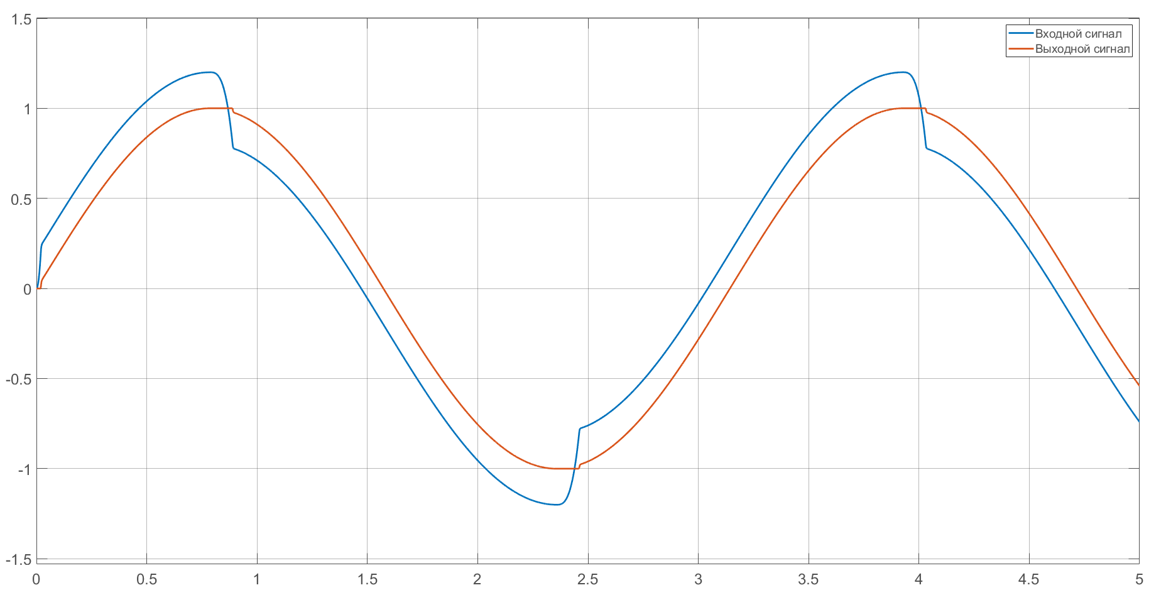
[picture p83: figure]

Уровень сигнала, град

Время, с

Рисунок 4 – Графики входного и выходного сигналов нелинейности вида «люфт» при синусоидальном задающем входном воздействие на САУ

Также из рисунка 4 видно, что такая нелинейность вносит запаздывание по фазе на выходной сигнал, а также небольшие сдвиги по амплитуде. По требованиям технического задания на данную САУ, её точность составляет 1о, а сдвиги по амплитуде значительно меньше 1о, поэтому можно сказать, что эта нелинейность незначительно влияет на качественные характеристики данной САУ при малых амплитудах. При больших амплитудах входного задающего синусоидального воздействия данная нелинейность также не будет оказывать значительного влияния на выходной сигнал. Соответствующий график представлен в приложении А.

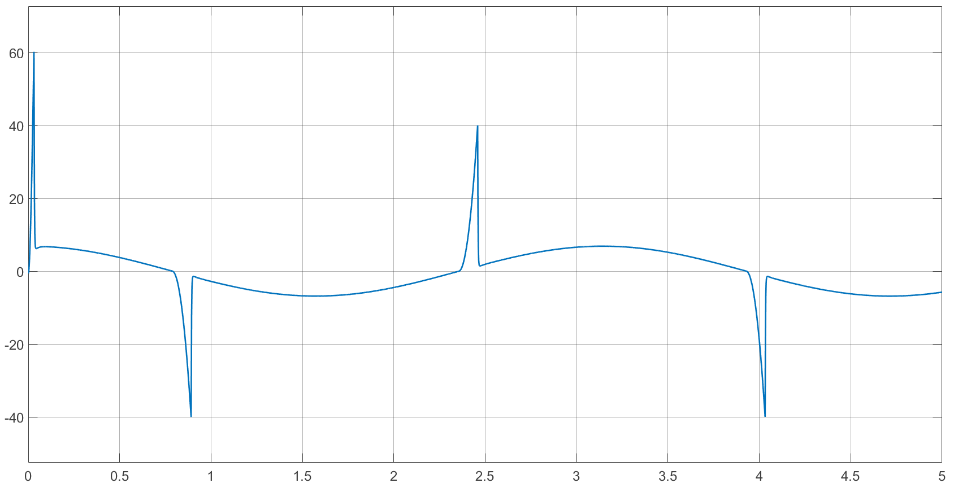
[picture p84: figure]

Время, с

Угловая скорость, рад/с

Рисунок 5 – График скорости выходного вала двигателя при синусоидальном входном воздействие.

На этом закончим описание нелинейности и перейдём к исследованию автоколебаний в данной САУ.

# 3 Частотный метод определения автоколебаний в САУ

Для того чтобы определить возникают автоколебания в системе или нет, необходимо найти передаточную функцию нелинейной часть W_н (s) ,

Поскольку данная нелинейная функция неоднозначная, то её передаточная функция описывается следующим выражением:

W_л (s)=q(A)+(q^(') (A))/ωs. (11)

где q(A) и q^(') (A) коэффициенты гармонической линеаризации, а А – амплитуда входного сигнала. В [1] подробно описаны нахождения коэффициентов для данной нелинейности. Возьмём готовые выражения для этих коэффициентов

q(A)=k/π[π/2+arcsin(1-(2b)/A)+2(1-(2b)/A)√(b/A(1-b/A))] (12)

q^(') (A)=-(4kb)/(πA)(1-b/A) (13)

Формулы (12) и (13) справедливы тогда, когда выполняется неравенство A ≥b .

Запишем условие существования автоколебаний в системе [2]

W_л (jω)=(-1)/(W_н (jω)). (14)

Графической интерпретацией выражения (14) является пересечение годографа АФЧХ (амплитудно – фазовой частотной характеристики) передаточной функции линейной части W_л (jω) и годографа нелинейной части (-1)/(W_н (jω)) . Из уравнения (14) и графиков q(a) и q^(') (a) также можно определить и параметры автоколебаний, если они присутствуют в системе.

# Заключение

В данной работе было рассмотрено влияние мёртвого хода редуктора на линейную САУ приводом подводного электромеханического манипулятора.

Были рассмотрены различия между входным и выходными воздействиями при малых и больших величинах задающего сигнала, а также была рассмотрена возможность появления автоколебаний в данной САУ. в результате был сделан вывод, что в данной САУ, включающей в себя только нелинейность вида «люфт», возникновение автоколебаний невозможно, а сама нелинейность незначительно влияет на характеристики системы.

# Список литературы

1) Теория автоматического управления. Т. 2. Многомерные, нелинейные, оптимальные и адаптивные системы. М.: ФИЗМАТЛИТ /
Ким Д. П. 2004 – 264 с.

2) Теория нелинейных систем автоматического регулирования и управления. М.: Наука, Попов Е. П., 1988 - 256 с.

3) Документация на редуктор 42 GPT [Электронный ресурс]
https://www.faulhaber.com/fileadmin/Import/Media/EN_42GPT_FMM.pdf
Дата обращения 19.05.2021

4) Теория систем управления. М.: МГГУ / Л. Д. Певзнер. под ред.
Сытдыковой А. Н. , 2002 – 235 с.

5) Controlling mechanical systems with backlash—A survey. Automatica, vol. 38, no. 10 / M. Nordin, P.-O. Gutman, 2002 - pp. 1633–1649.

# Приложение А

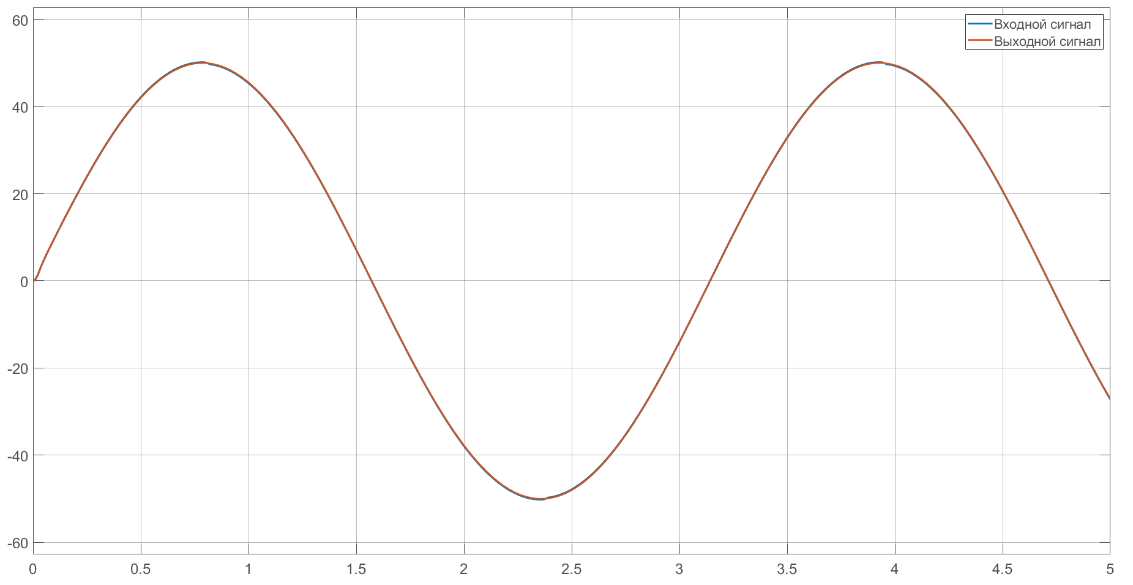
[picture p85: figure]

Рисунок А.1 – Графики входного и выходного сигналов нелинейности при синусоидальном входном воздействие с амплитудой А* = 50о и частотой ω* = 2 рад/с.

ω=∞

A = ∞

α

α

α≥ b

α

α≤- b

-b < α< b

α

α ={, (α-b)k,если α>0, (α+b)k, если α < 0, 0, в остальных случаях

= {, (α-b)k, если α≥ b , 0, если -b < α < b, (α+b)k, если α≤ -b

Тогда определим при каких значениях мёртвого хода редуктора в данной САУ возможны автоколебания. В ходе нескольких исследований было получено, что годограф нелинейной части пересекает (-1)/(W_н (jω)) пересекает годограф АФЧХ линейной части при b = 2.1o, эти два графика представлены на рисунке 7. Как видно значение мёртвого хода, при котором в системе возникают автоколебания значительно превышает значение мёртвого хода, выбранного редуктора. Из этого можно сделать вывод, что

Далее рассмотрим влияние мёртвого хода на качественные характеристики системы.

В этом разделе будет рассмотрено влияние мёртвого хода на качество переходных процессов в нелинейной САУ. Для исследования влияния нелинейности типа «люфт» на появление автоколебаний в САУ, было сделано предположение

Из рисунка 5 видно, что положительный отсчёт амплитуды А вдоль кривой (-1)/(W_н (А)) направлен снаружи во внутрь через кривую W_л (jω) , что означает что колебательный процесс неустойчивый, а значит автоколебания в данной САУ не возникают. Это же показывает и симуляция в пакете Simulink.
