orku/graduation_work/txt/for control/formulas.docx

U=(Ldi)/(dt)+r+k_u ω_(дв)

M_(дв) =k_m i

ω_(дв) =ω_(ред) i

M_(дв) =(M_(ред))/(iμ)+J_р (dω)/(dt)

M_(дв) = (k_(гд) ω_(ред)^2 sgn(ω_(ред) )+M_в )1/(iμ)+(J_р + J_п )(dω_(дв))/(dt)

(dω_(дв))/(dt)

ω_(max) =(30A)/(πt_(пп))=(30⋅100)/(π⋅0,60) ≈ 27,6 об/мин
