orku/graduation_work/txt/old/title.pdf

Министерство науки и высшего образования Российской Федерации Федеральное государственное бюджетное образовательное учреждение высшего образования
«Московский государственный технический университет имени Н.Э. Баумана
(национальный исследовательский университет)» (МГТУ им. Н.Э. Баумана)

ФАКУЛЬТЕТ _Специальное Машиностроение________________________________________

КАФЕДРА ___СМ11______________________________________________________________

# РАСЧЕТНО-ПОЯСНИТЕЛЬНАЯ ЗАПИСКА

# К КУРСОВОЙ РАБОТЕ

# НА ТЕМУ: ______Проектирование системы управления_______ ______________приводами подводного_____________ ______электромеханического манипулятора_______ _______________________________________________ _______________________________________________ _______________________________________________

Студент _СМ11-81Б__ | _________________ ____Шестаков А. А.__
(Группа) | (Подпись, дата) | (И.О.Фамилия)
Руководитель курсовой работы | _________________ ____Вельтещев В. В.__
| (Подпись, дата) | (И.О.Фамилия)
Консультант | _________________ ____Вельтищев В. В.__
| (Подпись, дата) | (И.О.Фамилия)

2021г.

Министерство науки и высшего образования Российской Федерации Федеральное государственное бюджетное образовательное учреждение высшего образования
«Московский государственный технический университет имени Н.Э. Баумана (национальный исследовательский университет)» (МГТУ им. Н.Э. Баумана)

УТВЕРЖДАЮ
Заведующий кафедрой __________
(Индекс)
______________ _______________
(И.О.Фамилия)
« _____ » ____________ 20 ____ г.

## З А Д А Н И Е

## на выполнение курсовой работы

по дисциплине __Проектирование подводных роботехнических систем___________________

Студент группы __СМ11-81Б____
___Шестаков Артём Андреевич_____________________________________________________ (Фамилия, имя, отчество)
Тема курсовой работы __Проектирование системы управления приводами подводного _____ __электромеханического манипулятора______________________________________________ ________________________________________________________________________________ Направленность КР (учебная, исследовательская, практическая, производственная, др.) __учебная_______________________________________________________________________ Источник тематики (кафедра, предприятие, НИР) ___кафедра___________________________

График выполнения работы: 25% к _4_ нед., 50% к _7_ нед., 75% к _10_ нед., 100% к _14_ нед.

Задание _______Спроектировать систему управления приводом подводного________________ ______________электромеханического манипулятора, _______________________________ ______________ удовлетворяющую требованиям технического задания _________________ _______________________________________________________________________________ _______________________________________________________________________________ Оформление курсовой работы:
Расчетно-пояснительная записка на _35__ листах формата А4.

_______________________________________________________________________________ _______________________________________________________________________________ _______________________________________________________________________________ _______________________________________________________________________________

Дата выдачи задания « _15_ » __февраля__ 2021 г.

Руководитель курсовой работы | _________________ __Вельтищев В. В,__
(Подпись, дата) | (И.О.Фамилия)
Студент | _________________ __Шестаков А. А,__
(Подпись, дата) | (И.О.Фамилия)
Примечание: Задание оформляется в двух экземплярах: один выдается студенту, второй хранится на кафедре.
