orku/graduation_work/txt/old/title_research.pdf

Министерство науки и высшего образования Российской Федерации Федеральное государственное бюджетное образовательное учреждение высшего образования
«Московский государственный технический университет имени Н.Э. Баумана
(национальный исследовательский университет)» (МГТУ им. Н.Э. Баумана)

ФАКУЛЬТЕТ ___СМ_____________________________________________________________

КАФЕДРА _____СМ11____________________________________________________________

# РАСЧЕТНО-ПОЯСНИТЕЛЬНАЯ ЗАПИСКА

## К НАУЧНО-ИССЛЕДОВАТЕЛЬСКОЙ РАБОТЕ

## НА ТЕМУ: __Исследование влияния нелинейности, вызванной_ ______мёртвым ходом редуктора, на систему _____ ________ управления приводом подводного_________ ______электромеханического манипулятора_______ _______________________________________________ _______________________________________________

Студент ___СМ11-81Б____ | _________________ ___Шестаков А. А.__
(Группа) | (Подпись, дата) | (И.О.Фамилия)
Руководитель | _________________ ___Вельтищев В. В.__
| (Подпись, дата) | (И.О.Фамилия)
Консультант | _________________ ____________________
| (Подпись, дата) | (И.О.Фамилия)

2021 г.

Министерство науки и высшего образования Российской Федерации Федеральное государственное бюджетное образовательное учреждение высшего образования
«Московский государственный технический университет имени Н.Э. Баумана (национальный исследовательский университет)» (МГТУ им. Н.Э. Баумана)

УТВЕРЖДАЮ
Заведующий кафедрой __СМ11__
(Индекс)
______________ _Вельтищев В. В.__
(И.О.Фамилия)
« _____ » ____________ 20 ____ г.

## З А Д А Н И Е

### на выполнение научно-исследовательской работы

по теме __Исследование влияния нелинейности на линейно синтезированную ____________ __систему управления ____________________________________________________________ ________________________________________________________________________________

Студент группы __СМ11-81Б____ ________________________________________________________________________________
(Фамилия, имя, отчество)
Направленность НИР (учебная, исследовательская, практическая, производственная, др.) _______Учебная__________________________________________________________________ Источник тематики (кафедра, предприятие, НИР) __Кафедра__________________________

График выполнения НИР: 25% к 4 нед., 50% к 7 нед., 75% к 10 нед., 100% к 14 нед. Техническое задание __Исследовать влияние нелинейности, вызывной мёртвым ______ ___ходом редуктора, на систему управления подводным электромеханическим___________ ___ манипулятором______________________________________________________________ _______________________________________________________________________________ _______________________________________________________________________________ Оформление научно-исследовательской работы:
Расчетно-пояснительная записка на _19__ листах формата А4.
Перечень графического (иллюстративного) материала (чертежи, плакаты, слайды и т.п.) _______________________________________________________________________________ _______________________________________________________________________________ _______________________________________________________________________________ _______________________________________________________________________________

Дата выдачи задания « 15 » февраля 2021 г.

Руководитель НИР | _________________ ___Вельтищев В. В.__
(Подпись, дата) | (И.О.Фамилия)
Студент | _________________ ___Шестаков А. А.__
(Подпись, дата) | (И.О.Фамилия)

Примечание: Задание оформляется в двух экземплярах: один выдается студенту, второй хранится на кафедре.
