orku/graduation_work/drawings/bode.jpg

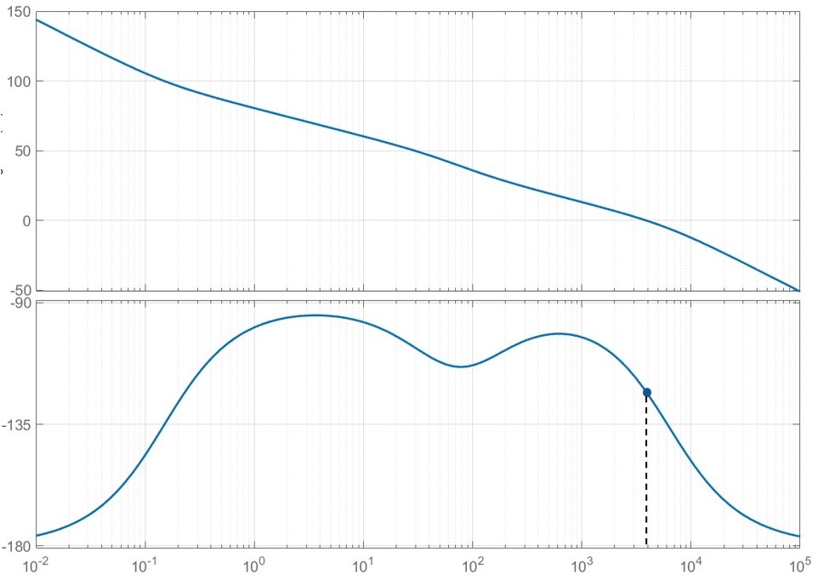
drawings/bode.jpg
