orku/graduation_work/drawings/driver.jpg

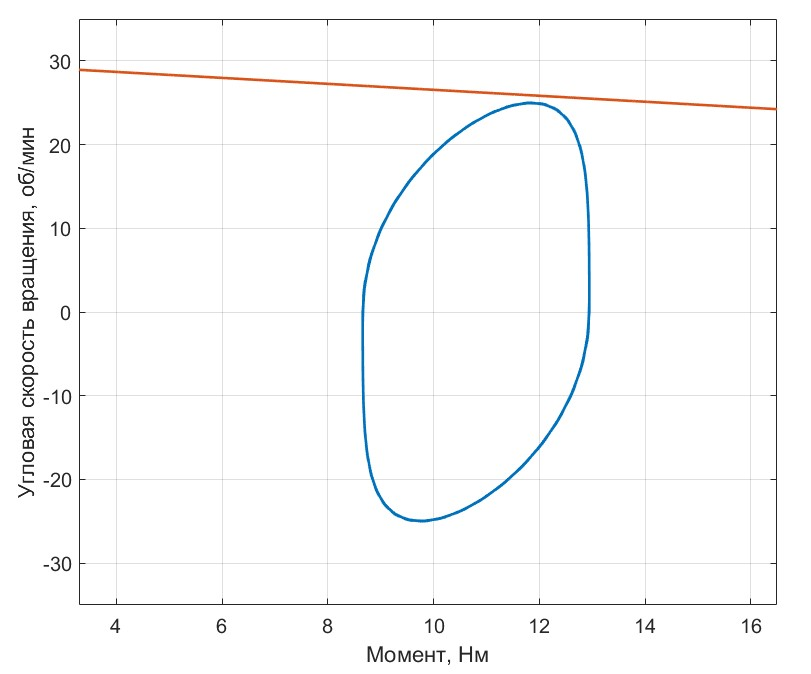
drawings/driver.jpg
