orku/graduation_work/drawings/driver_without.jpg

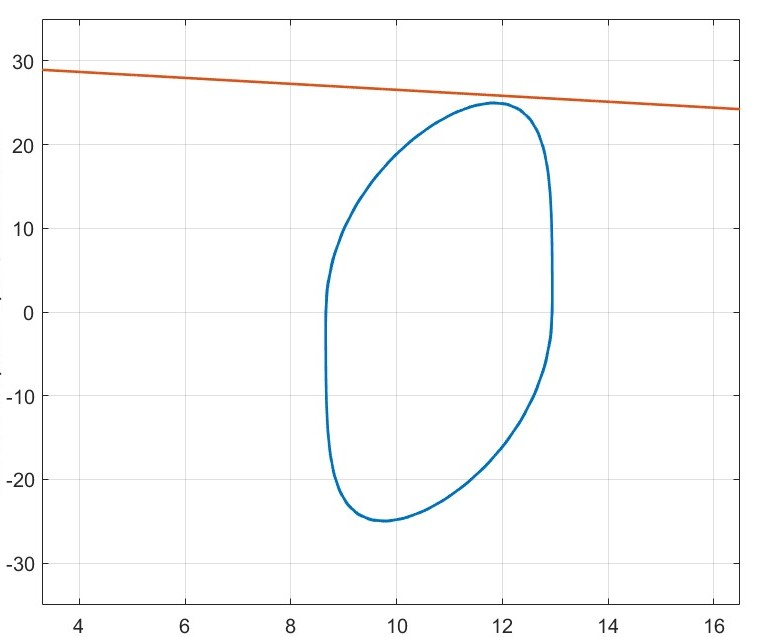
drawings/driver_without.jpg
