orku/graduation_work/drawings/f(w).jpg

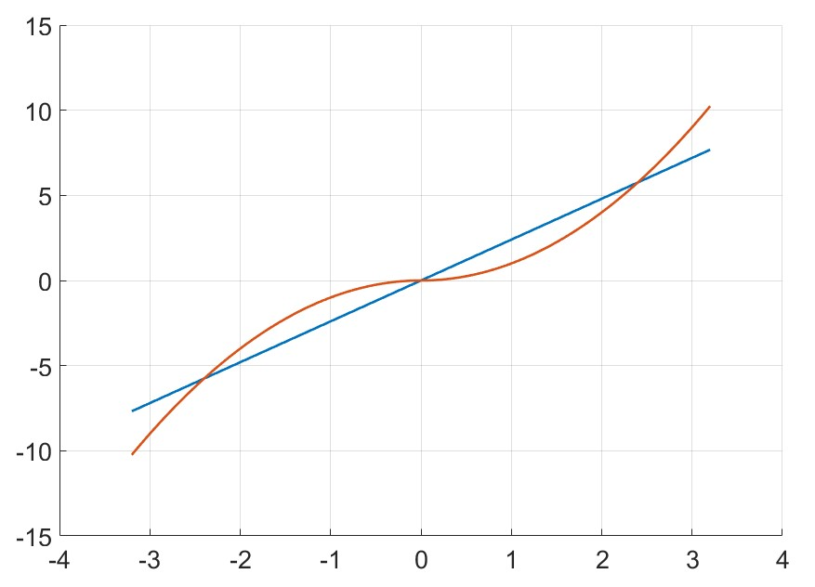
drawings/f(w).jpg
