orku/graduation_work/drawings/k_gd.jpg

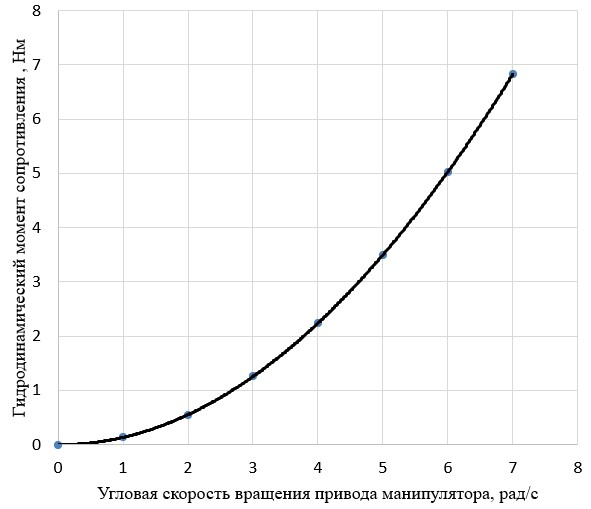
drawings/k_gd.jpg
