orku/graduation_work/drawings/k_gd_without.jpg

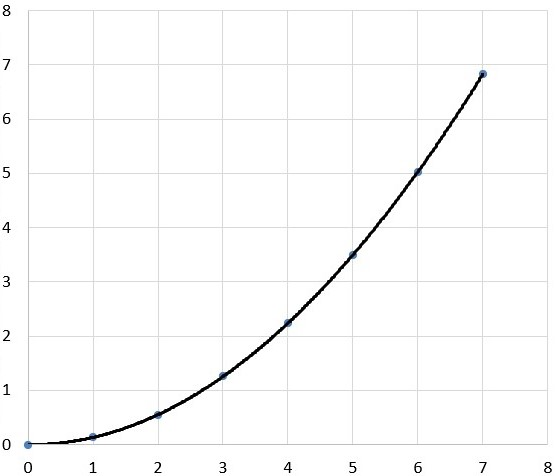
drawings/k_gd_without.jpg
