orku/graduation_work/drawings/manipulator.jpg

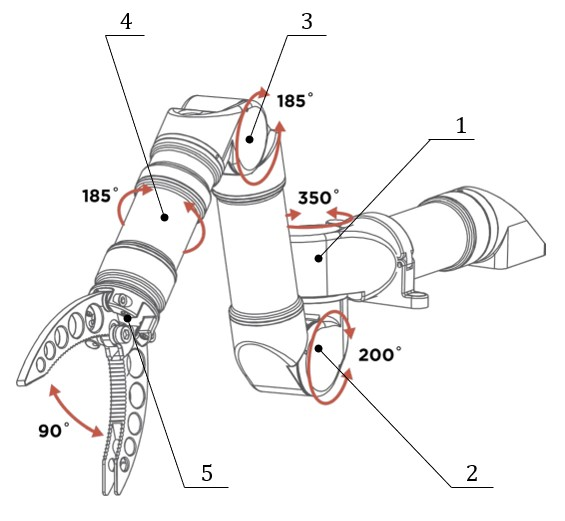
drawings/manipulator.jpg
