orku/graduation_work/drawings/math_.jpg

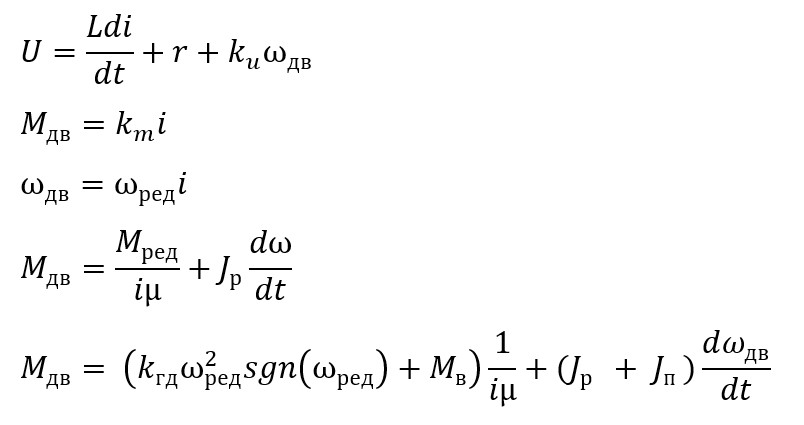
drawings/math_.jpg
