orku/graduation_work/drawings/math_model.jpg

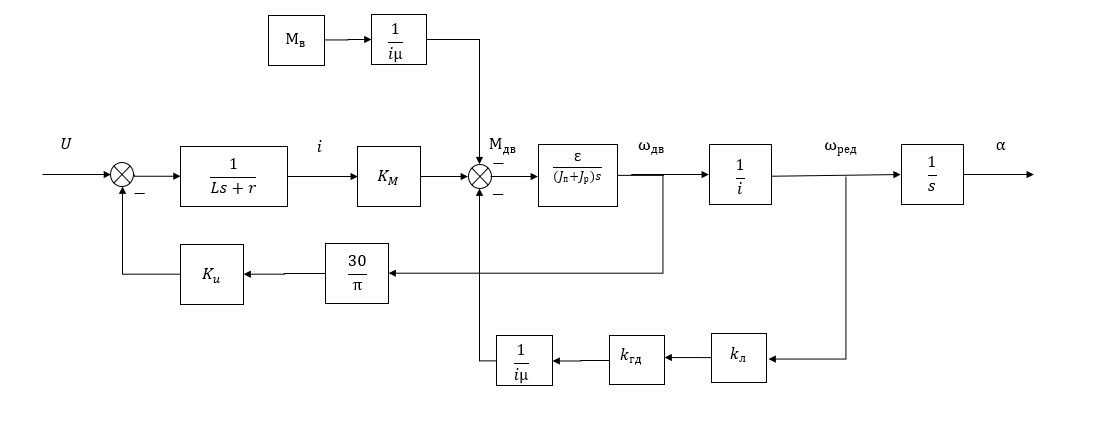
drawings/math_model.jpg
