orku/graduation_work/drawings/model.png

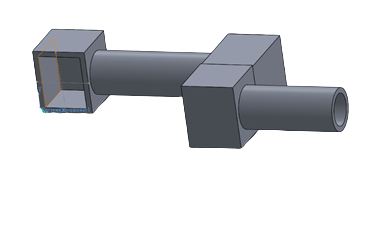
drawings/model.png
