orku/graduation_work/drawings/model_white.jpg

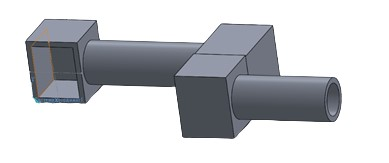
drawings/model_white.jpg
