orku/graduation_work/drawings/PID_saturation.jpg

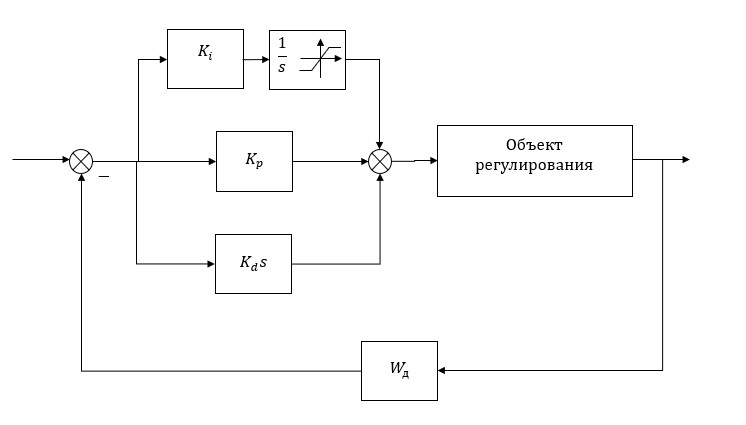
drawings/PID_saturation.jpg
