orku/graduation_work/drawings/pp_1.jpg

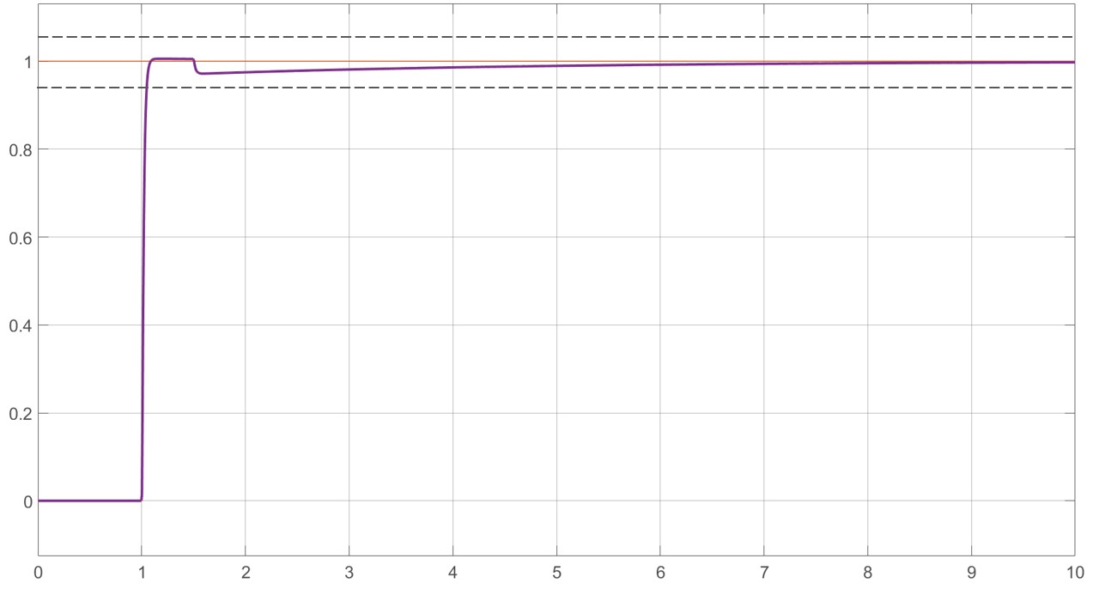
drawings/pp_1.jpg
