orku/graduation_work/drawings/pp_100.jpg

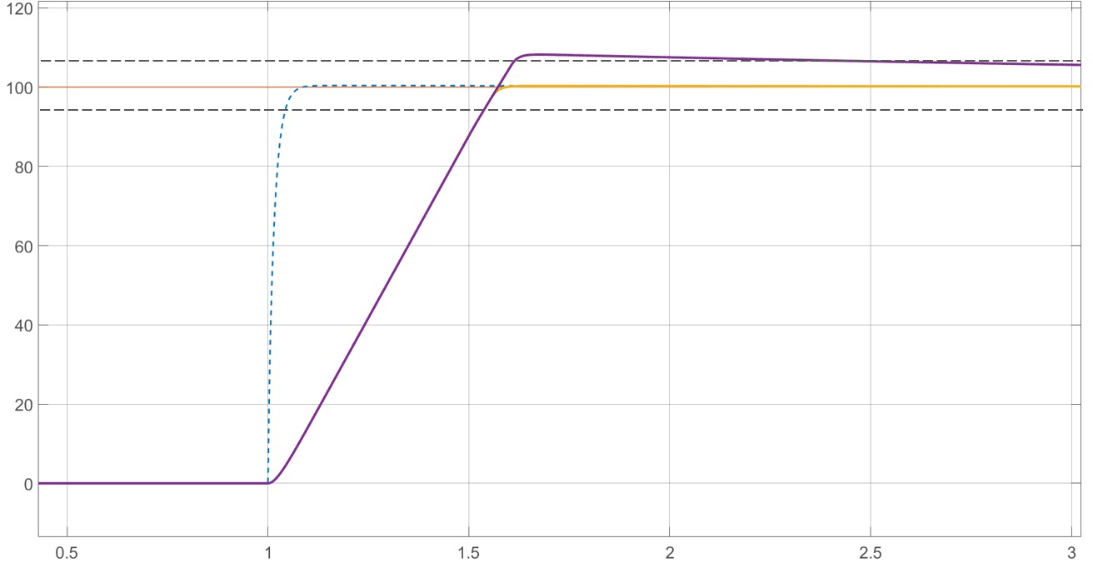
drawings/pp_100.jpg
