orku/graduation_work/drawings/pp___1.jpg

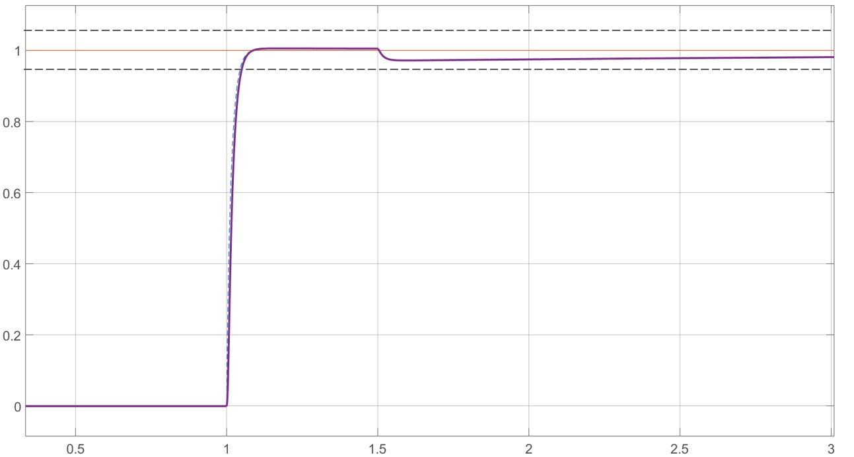
drawings/pp___1.jpg
