orku/graduation_work/pics/energy/fig_3_velocity_to_torque.PNG

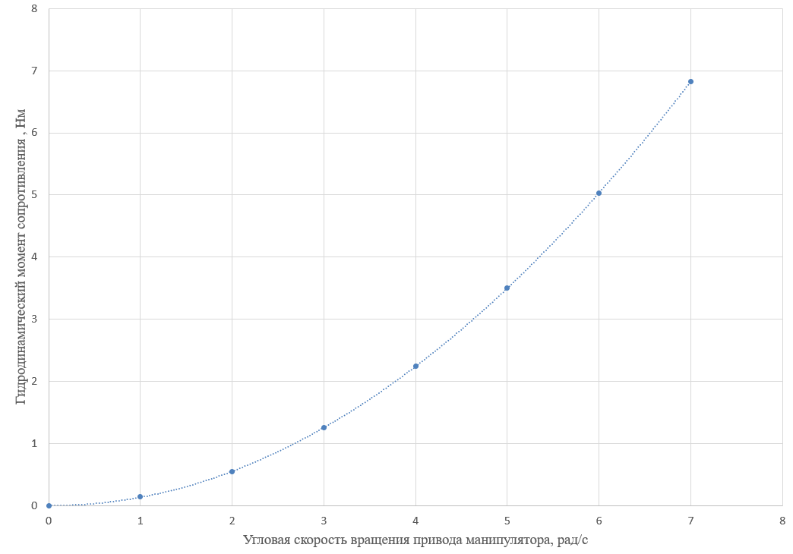
pics/energy/fig_3_velocity_to_torque.PNG
