orku/graduation_work/pics/energy/lin.PNG

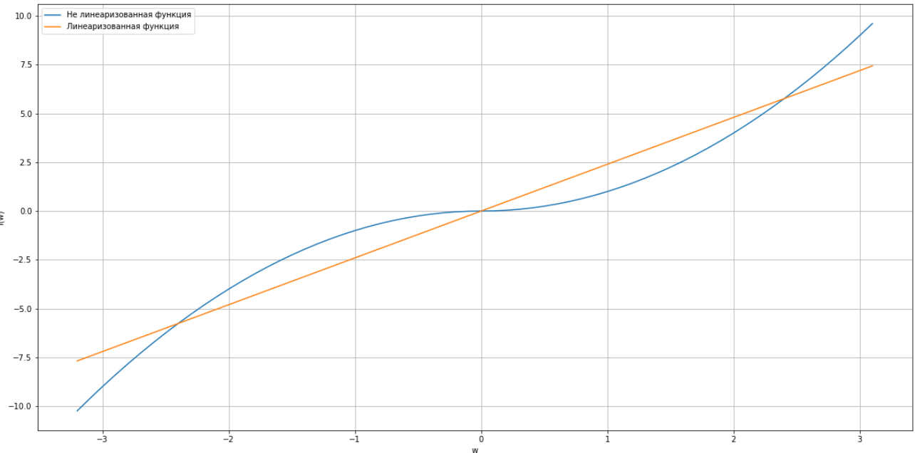
pics/energy/lin.PNG
