orku/graduation_work/pics/energy/mu_tf_lach.PNG.jpg

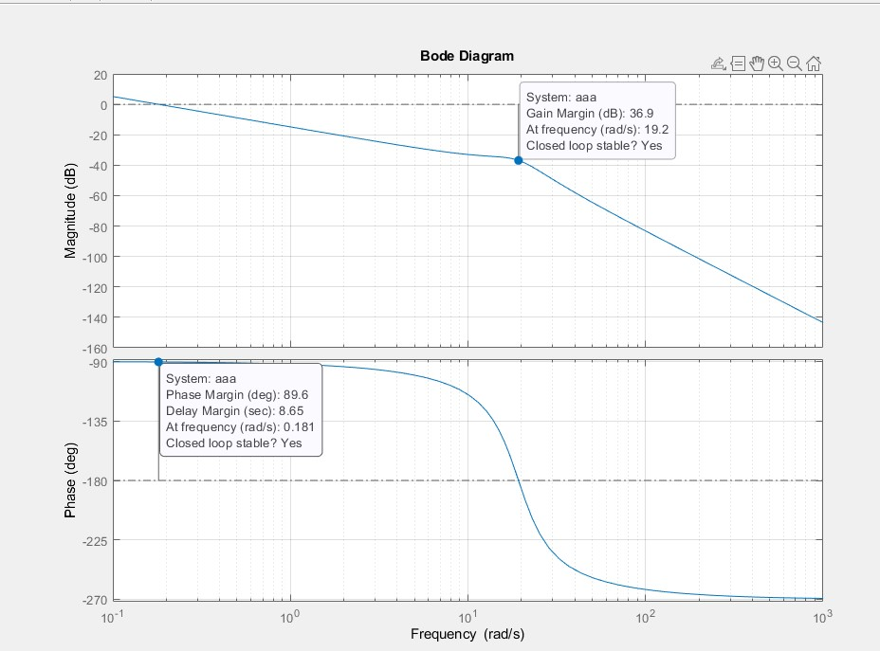
pics/energy/mu_tf_lach.PNG.jpg
