orku/graduation_work/pics/energy/rotate_1.png

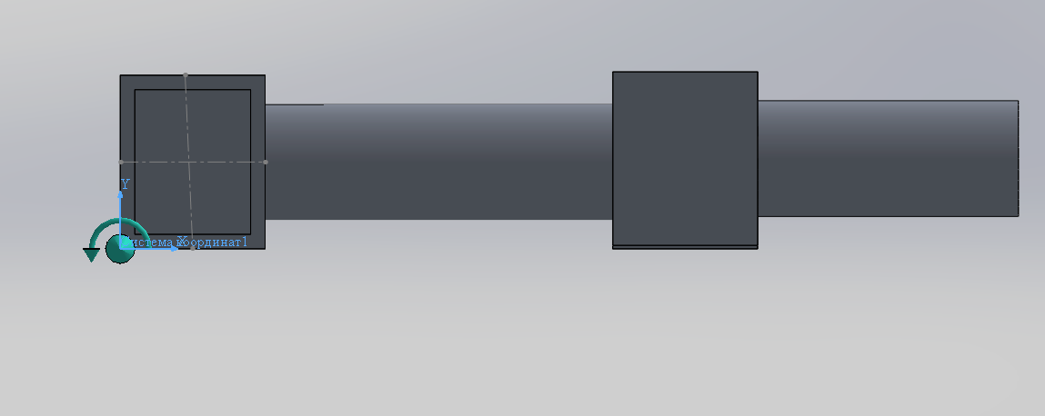
pics/energy/rotate_1.png
