orku/graduation_work/pics/energy/rotate_2.png

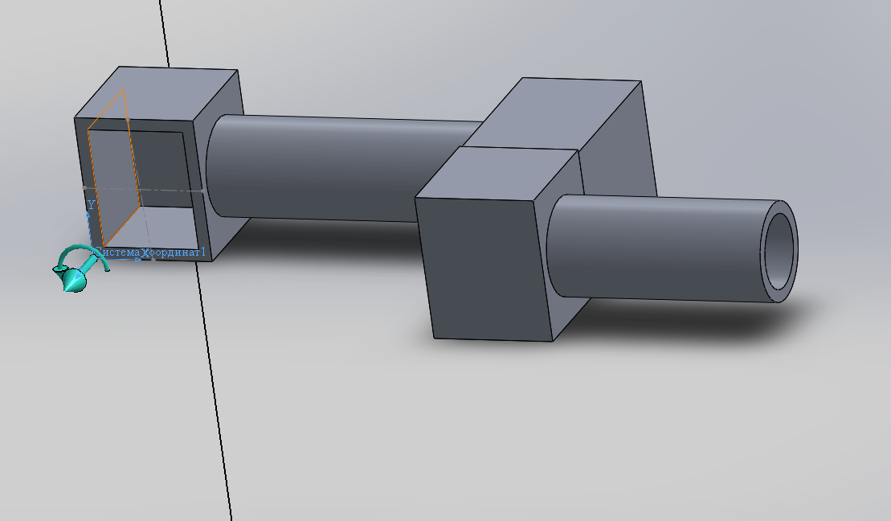
pics/energy/rotate_2.png
