orku/graduation_work/pics/energy/Безымянный.png

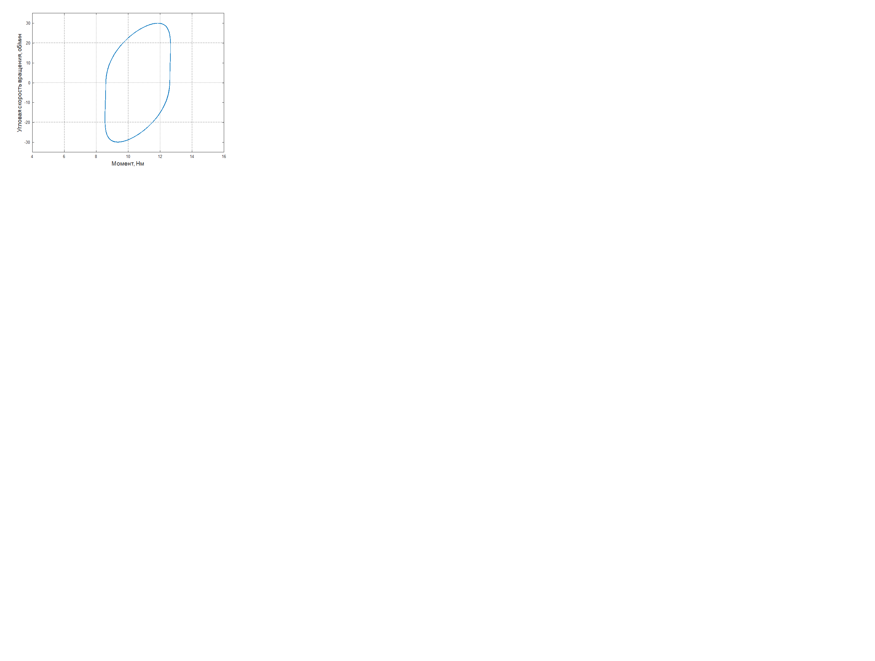
pics/energy/Безымянный.png
