orku/graduation_work/pics/research/backwash.jpg

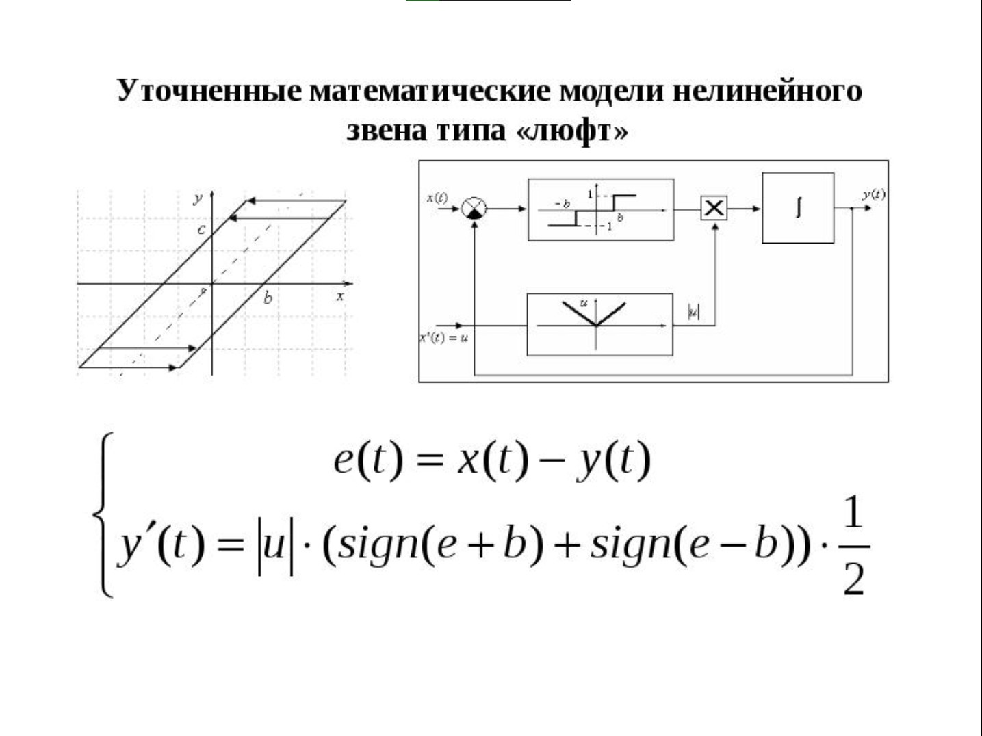
pics/research/backwash.jpg
