orku/graduation_work/pics/research/backwash_2.jpg

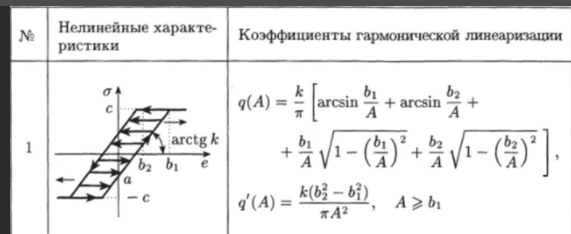
pics/research/backwash_2.jpg
