orku/graduation_work/(list of files, cad)

Other CAD files:
drawings/1.dwg
