orku/graduation_work/pics/energy/step_response_non_tined_pid_30.pdf

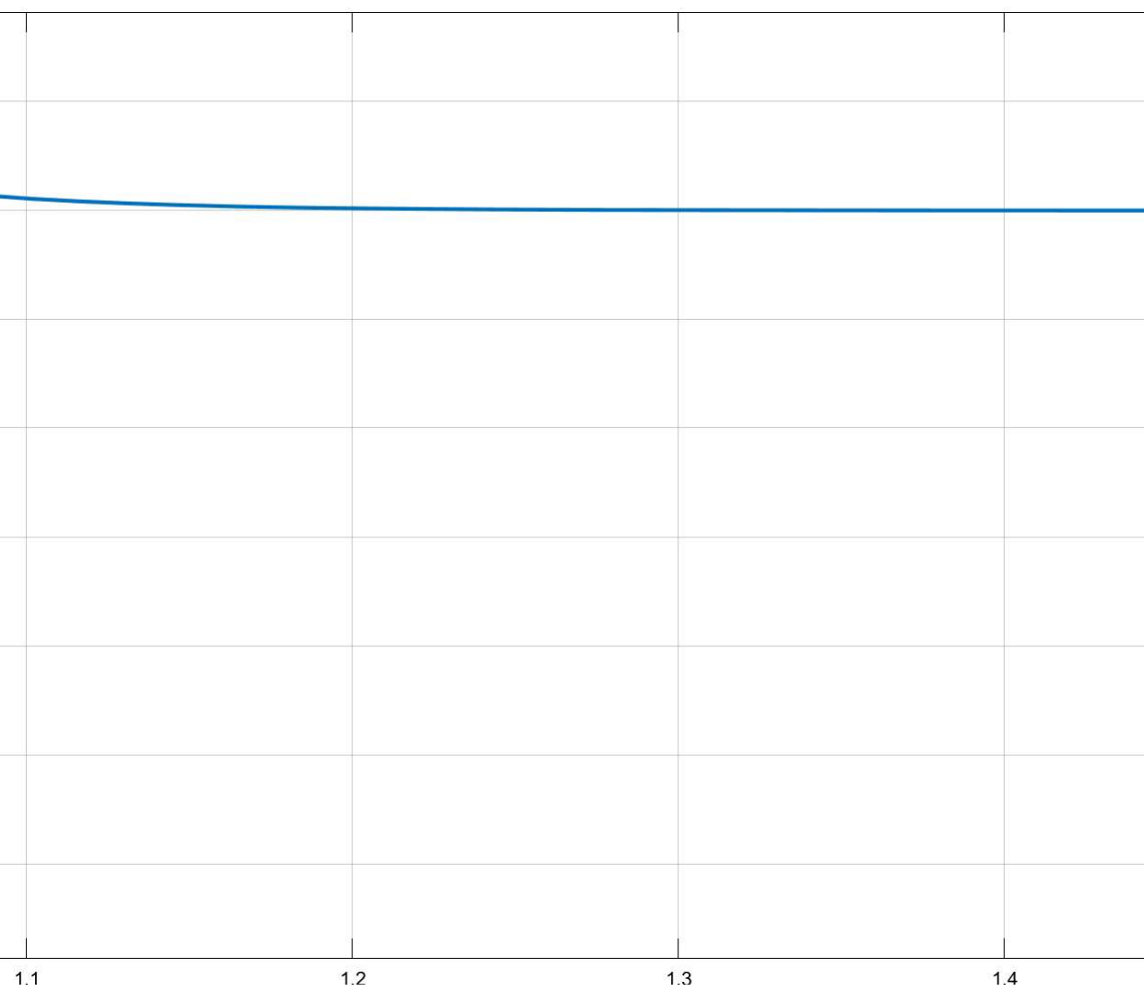
[picture p122: page 1]
