orku/graduation_work/pics/energy/step_res.jpg

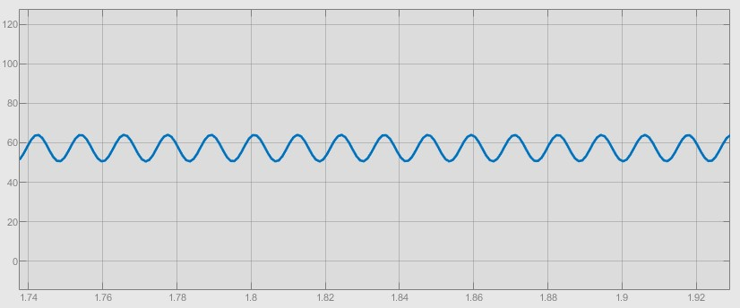
pics/energy/step_res.jpg
