orku/graduation_work/drawings/print/1.pdf

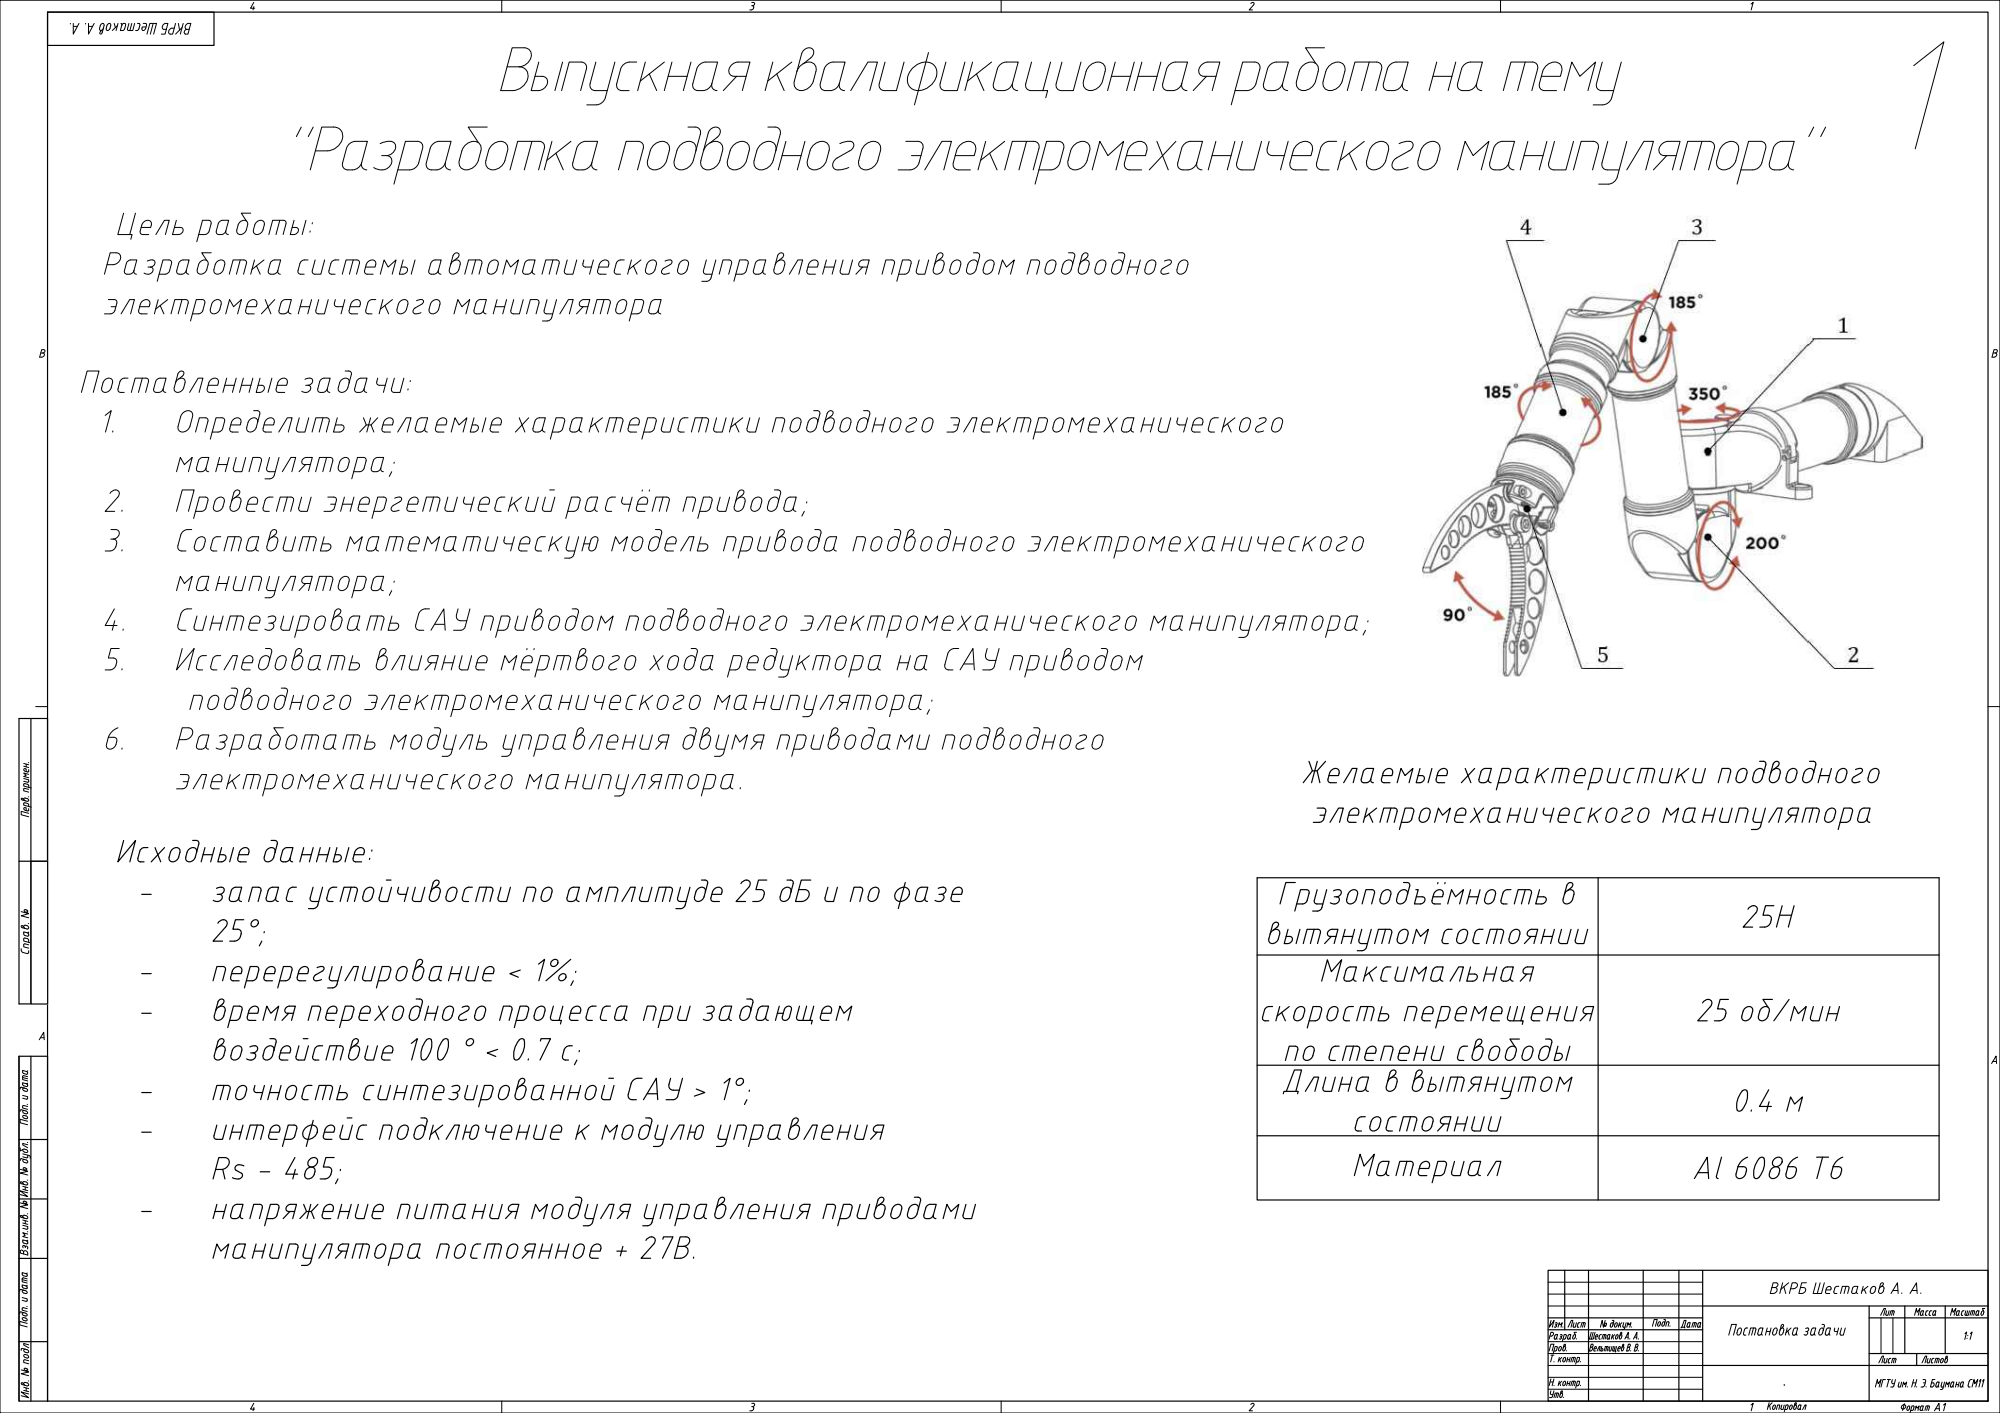
[picture p124: page 1]
