orku/graduation_work/drawings/print/2.pdf

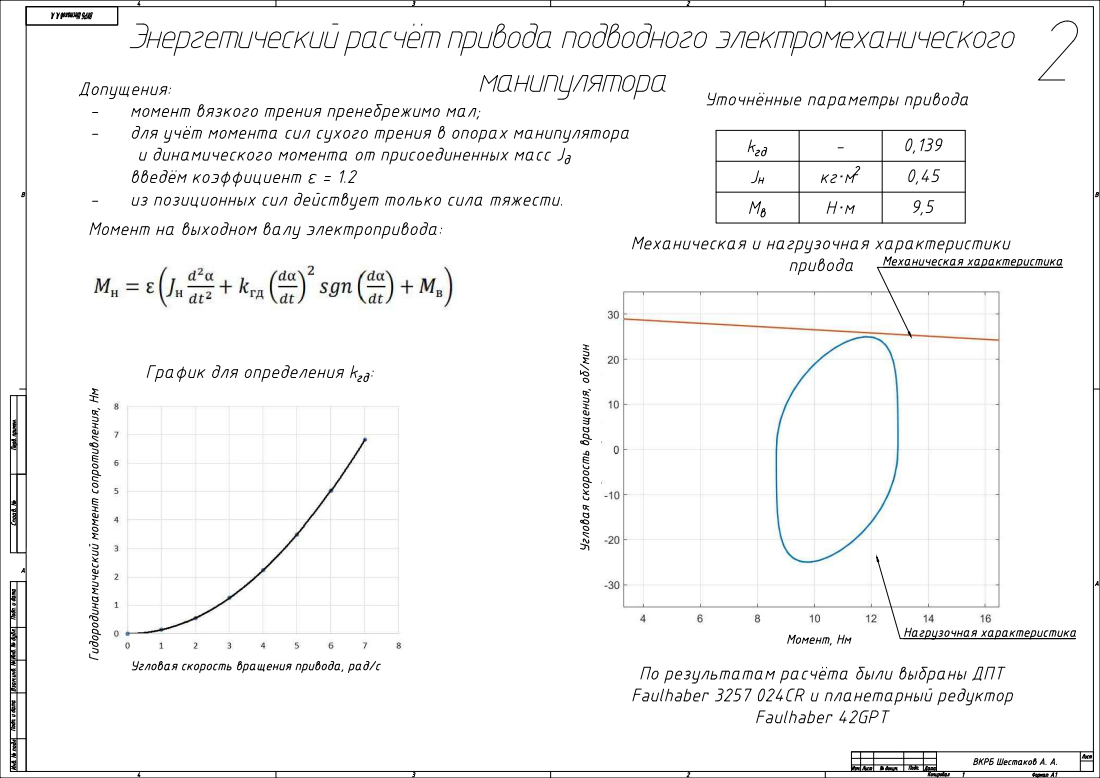
[picture p125: page 1]
