orku/graduation_work/drawings/print/3.pdf

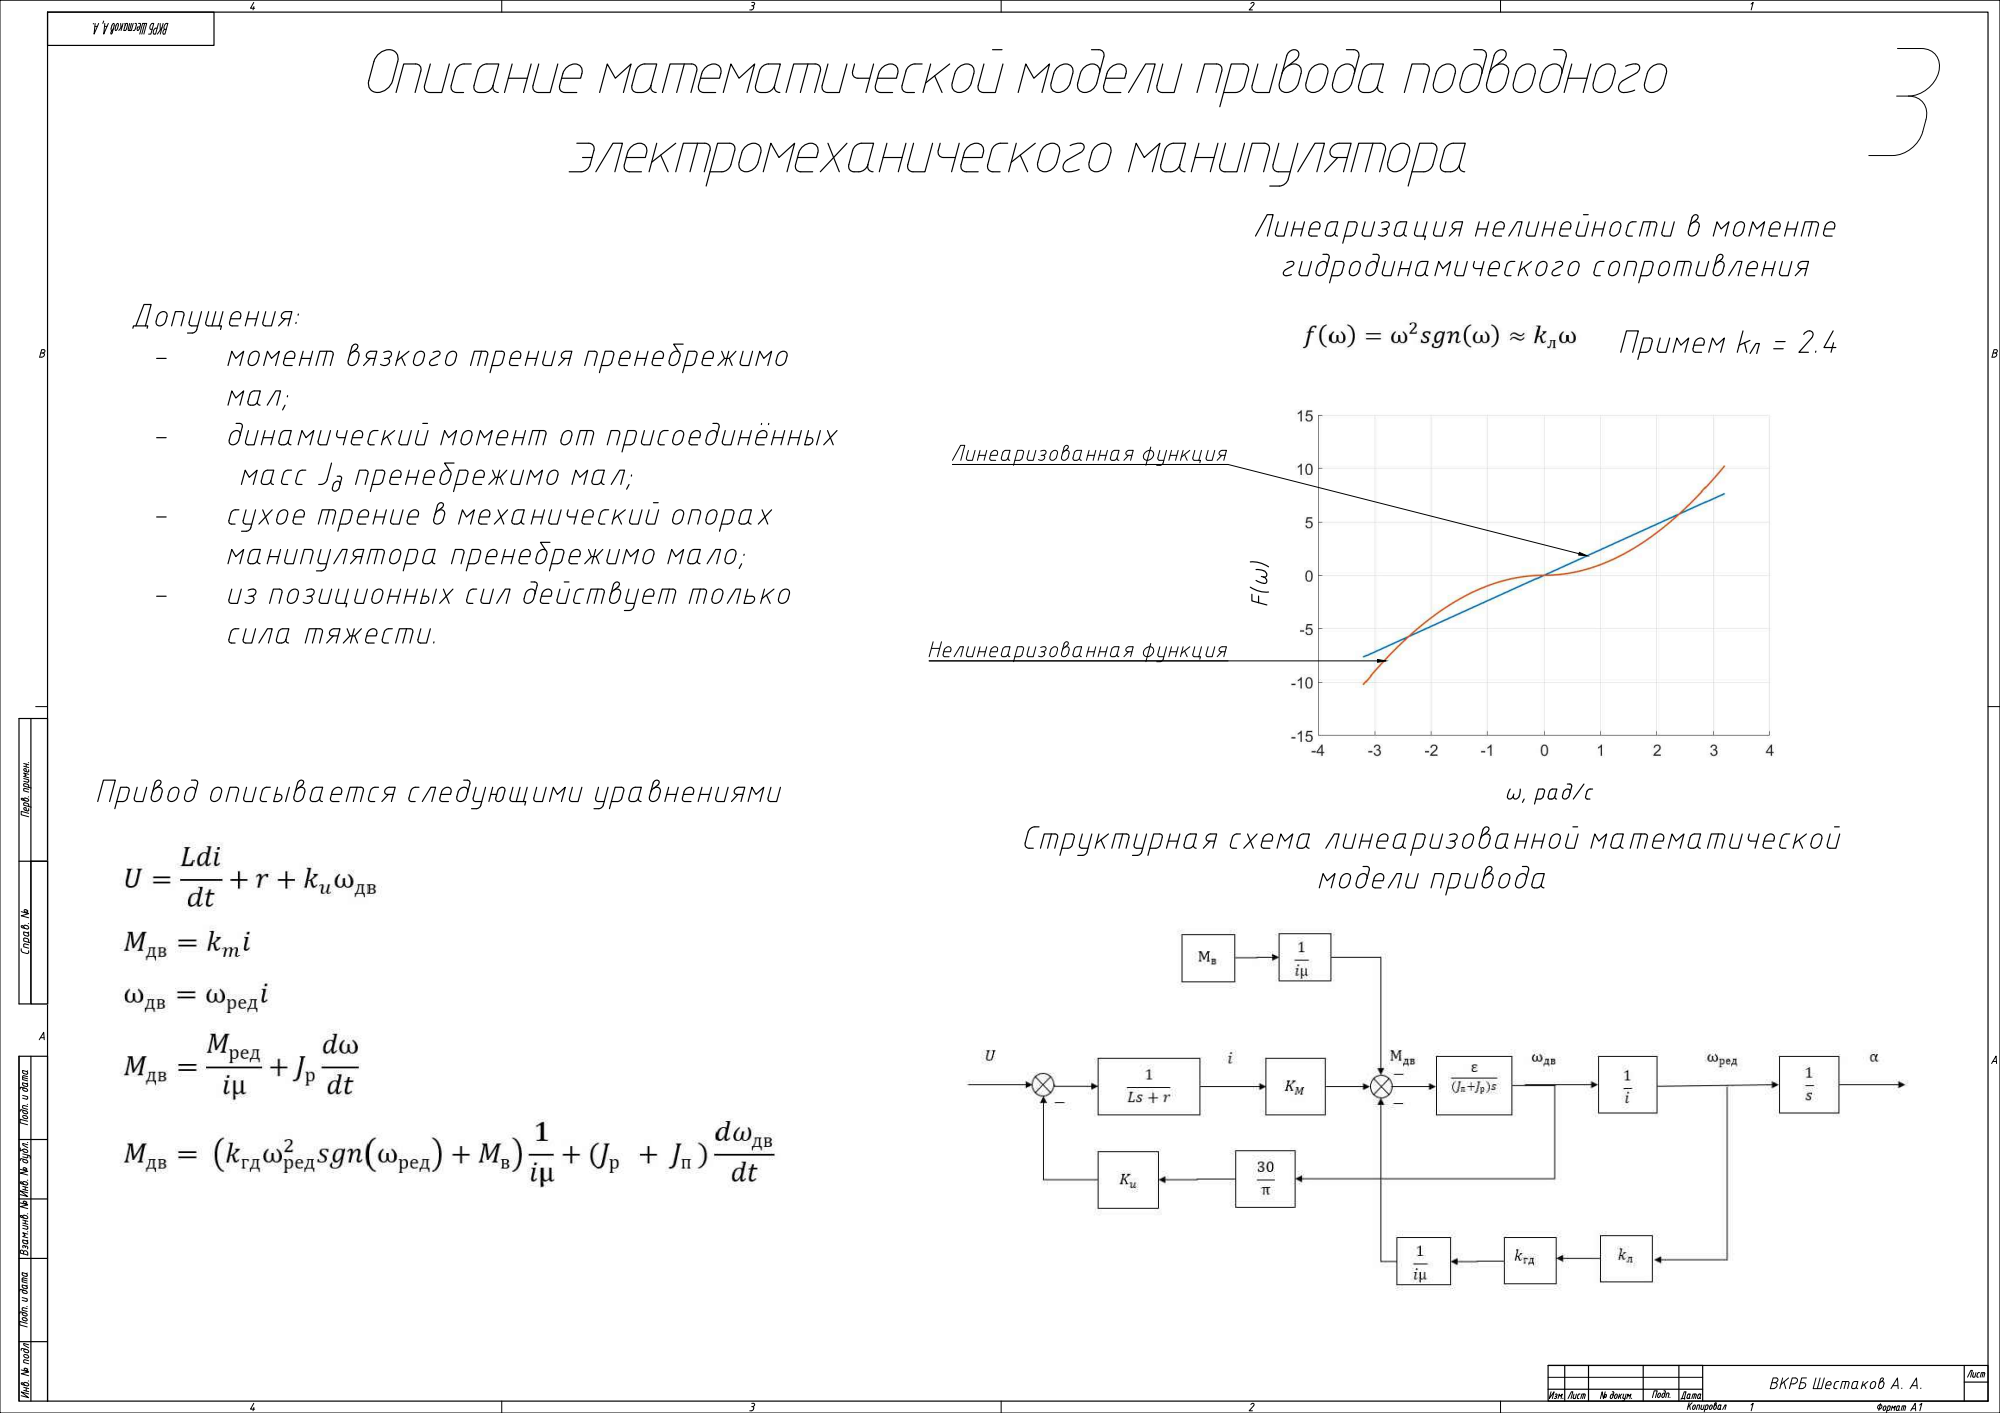
[picture p126: page 1]
