orku/graduation_work/drawings/print/4.pdf

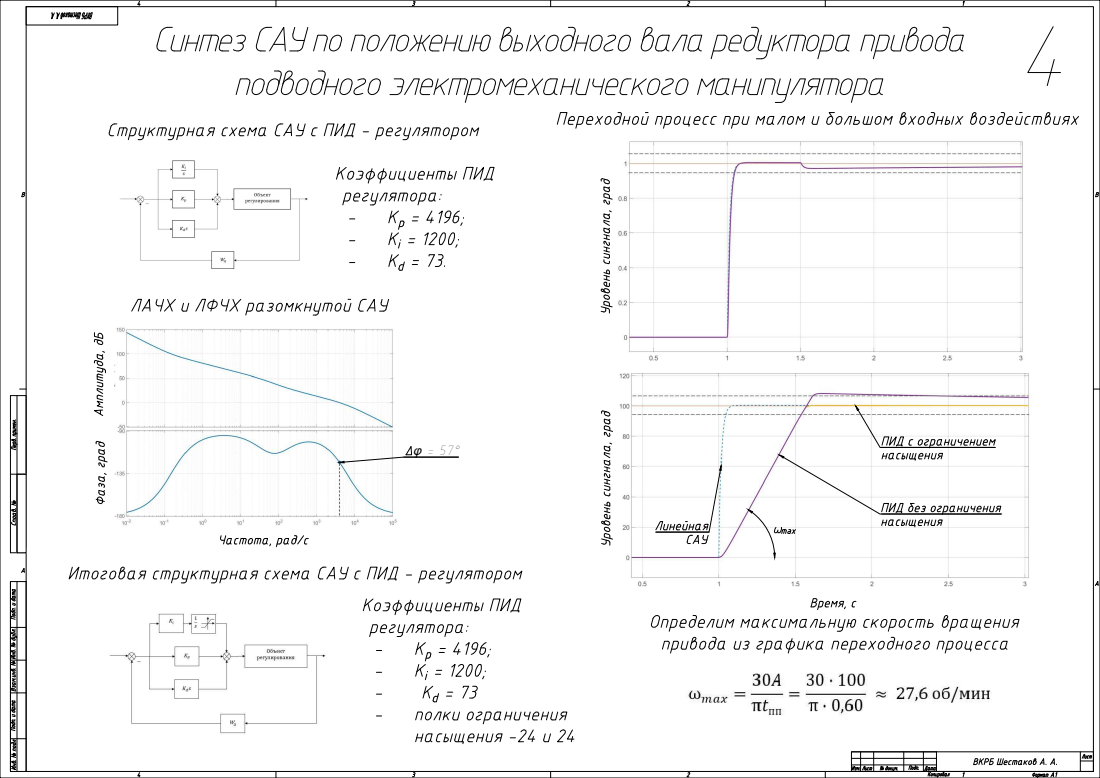
[picture p127: page 1]
