orku/graduation_work/(commit log)

2021-04-26 init commit
    [Книга1.xlsx]
2021-04-26 found some new gears
2021-05-07 added some info about motors and gears
2021-05-08 added some new motors and gearboxes
2021-05-09 added new docs for new ddc motor
2021-05-12 change motor
2021-05-12 add new motor with gear
2021-05-22 added PID controller
2021-06-14 added drawings
    [1.dwg]
